hansonxiex-stack/nrf52-th-sensor-hardware/docs/变更记录表_智能温湿度传感器.md

# 设计变更记录表

> 项目：开源智能温湿度传感器 Pro PCB 设计
> 姓名：谢天成
> 说明：记录项目周期内所有对原理图、PCB、BOM 的实质性变更，按周次归档。
> 最后更新：第 7 周（2026.10.11）

---

## 使用说明

- **「变更前 → 变更后」** 只记录可核查的差异项，不含过程性调整。
- **「依据」** 一栏写明该变更的判据来源（数据手册条款 / 实测数据 / DRC 结果 / 工艺约束）。
- 涉及**库封装与板上实例不一致**的变更，详见《DRC 检查说明》与《DFM 检查报告与优化记录》。

---

## 变更总表

### 第 3 周（2026.09.07 — 09.13）叠层与板框

| # | 变更对象 | 变更前 | 变更后 | 依据 |
|---|---|---|---|---|
| 3-1 | 叠层结构 | 未定 | 4 层：F.Cu / In1.Cu(GND) / In2.Cu(VDD) / B.Cu | 信号—地—电源—信号结构；嘉立创 4 层标准叠层 |
| 3-2 | 板框尺寸 | 36 × 36 mm | 40 × 40 mm | 器件布局后面积不足 |

### 第 4 周（2026.09.14 — 09.20）布局与布线

| # | 变更对象 | 变更前 | 变更后 | 依据 |
|---|---|---|---|---|
| 4-1 | **U2 传感器 keepout 层设置** | 仅 `F.Cu` 单层 | `F.Cu` + `B.Cu` + `In1.Cu` + `In2.Cu` **四层** | SHT4x Datasheet v7.3 §5.3：*"There shall be no copper under the sensor other than at the pin pads."* 该要求为全层 |
| 4-2 | 板框尺寸 | 40 × 40 mm | **48.2 × 40 mm** | 为底层 LCD 段码走线腾出通道 |
| 4-3 | In1 / In2 铺铜区 polygon | x 124.6 ~ 166.0 | **x 116.1 ~ 166.0** | 同步 4-2 的板框变更；否则新扩区域铺不上铜 |
| 4-4 | **U3 焊盘局部角度** | 0°（库定义值） | **270°** | 焊盘长边原落在 0.635 mm 节距方向上，相邻焊盘重叠，产生 50 条 `shorting_items` / `clearance` 违规；旋转后清零 |
| 4-5 | U3 封装旋转 | — | 90°（置于 B.Cu） | 配合 LCD 引脚顺序 |
| 4-6 | 晶振 Y2 位置 | 原位置 | **下移 1.4 mm** | I2C_SCL 原从 Y2 焊盘下方穿过，间距仅 0.200 mm；下移后提升至 0.600 mm |
| 4-7 | I2C 总线速率 | 400 kHz | **100 kHz** | HT16C21A 手册：400 kHz 需 VDD ≥ 3.0 V，而 CR2032 放电过程中无法保证 |
| 4-8 | I2C 上拉电阻 R1 / R2 | 待定 | **10 kΩ**（维持） | 配合 4-7 的 100 kHz；上升时间余量约 8 倍 |
| 4-9 | 射频区走线 | 进入天线禁布区 | 调整通道位置 | 天线 keepout 要求 tracks/vias/pads/copperpour not_allowed |
| 4-10 | **AE1 天线 pad 2 环形宽度** | 0.10 mm（库定义值） | **0.25 mm** | 库中 0.10 mm 低于常见厂家最小环宽要求，加宽以满足可制造性 |

### 第 5 周（2026.09.21 — 09.27）布线收尾与 DRC

| # | 变更对象 | 变更前 | 变更后 | 依据 |
|---|---|---|---|---|
| 5-1 | **L2 型号（DC-DC 储能电感）** | Sunlord `SDFL1608S100KTF`（立创 C1035） | **Murata `LQM21FN100M80L`**（立创 C162582） | 原型号额定电流仅 **3 mA**，不满足 Nordic 参考设计的 **IDC,min ≥ 50 mA**；实测工作峰值电流 13.6 mA |
| 5-2 | L2 封装 | `Inductor_SMD:L_0603_1608Metric` | **`Inductor_SMD:L_0805_2012Metric`** | 随 5-1 换型；10 µH 且 ≥ 50 mA 的屏蔽功率电感在 0603 尺寸难以实现 |
| 5-3 | L2 连接走线 | — | 重画 `L2 → U1.DCC`、`L2 → L3` 两段 | 随换型后的焊盘位置重连 |
| 5-4 | 缝合过孔数量 | 20 个 | **66 个** | 消除 56 条 `unconnected_items`（GND 焊盘够不到 In1、VDD 焊盘够不到 In2） |
| 5-5 | 过孔与焊盘间距 | 7 个过孔孔净距不足 | 挪至**孔净距 0.15 mm / 环压焊盘 0.05 mm** | 孔离焊盘过近会导致回流焊时焊料沿孔壁虹吸流失 |
| 5-6 | C8 的 GND 过孔 | 孔净距 0.070 mm | **维持原位不动** | 几何上被夹死：L1 焊盘下沿到 C8 焊盘上沿仅 0.770 mm，而 0.7 mm 过孔加两侧间隙需 1.10 mm |
| 5-7 | U1 散热焊盘过孔 | 位置重合的散乱过孔 | **3 × 3 规整阵列**（9 个，孔径 0.3 mm） | 散热过孔需在 EP 焊盘内 |
| 5-8 | 丝印 Reference 字段 | 53 条 `silk_overlap` / `silk_over_copper` | **1 条**（LCD1 自身图形压自身焊盘） | 逐条处理后剩余的 1 条无需处理，理由见《DRC 检查说明》 |
| 5-9 | BOM · L2 行 | C1035 / 0.13 元 | **C162582 / 0.79 元** | 随 5-1 换型 |
| 5-10 | BOM 合计 | 27.48 元 | **28.14 元** | 随 5-9 |

### 第 6 周（2026.09.28 — 10.04）ESD 器件落地与全部布线完成

| # | 变更对象 | 变更前 | 变更后 | 依据 |
|---|---|---|---|---|
| 6-1 | **J1（SWD 调试座）位置与朝向** | (160.20, 61.80)，旋转 180° | **(160.90, 55.40)，旋转 −90°** | 需要为保护器件 U4 提供**同层且紧邻**的位置——ESD 保护要求保护器件与连接器同层、保护前路径最短，见《ESD 与滤波设计说明》§3.2.4 |
| 6-2 | **SW1（按键）位置** | (161.53, 55.20)，右上角紧邻原 J1 | **(140.10, 87.50)，左下角靠近电池座** | 回归叠层方案 §3.4 的分区：按键应与电池座 BT1 同处一侧、靠近板边便于操作。**层不变（仍为 B.Cu）** |
| 6-3 | **R4（KEY 上拉 10 kΩ）位置** | (157.20, 54.40) | **(135.78, 86.70)** | 随 6-2；上拉电阻应贴近按键入口 |
| 6-4 | **U2（SHT40）位置** | (140.80, 86.00) | **(131.90, 85.50)** | 增大与热源的距离：距主控 U1 由 20.7 mm 增至 **25.5 mm**，距电池座 BT1 由 8.2 mm 增至 **11.1 mm**。降低热耦合对测温精度的影响，见《热设计分析》§3.4 |
| 6-5 | **C12（U2 去耦 100 nF）位置** | (140.75, 88.40) | **(131.85, 87.90)** | 随 6-4。去耦电容必须保持在传感器电源脚旁，实测距 U2 仅 **2.4 mm** |
| 6-6 | C1（体电容 2.2 µF）位置 | (135.80, 79.00) | (135.80, 77.60) | 靠近电池座 BT1 |
| 6-7 | C7（DEC1 去耦）位置 | (145.92, 71.20) | (145.80, 71.80) | 微调避让走线 |
| 6-8 | **新增 U4：ESD 保护阵列** | — | **TT0554TLX @ (159.20, 62.10)，旋转 −90°，B.Cu** | 落地第 5 周确定的 ESD 方案 A，见《ESD 与滤波设计说明》§3.2 |
| 6-9 | **原理图符号（U4）** | 借用 KiCad 系统库 `Power_Protection:SRV05-4` | 新建**工程本地符号库** `TT0554TLX.kicad_sym` 并注册进 `sym-lib-table`；引脚名按 TT0554TLX 手册改为 `I/O_1 / GND / I/O_3 / I/O_4 / VCC / I/O_2` | SRV05-4 的引脚名与 TT0554TLX 不一致，其中 **pin 2 = GND、pin 5 = VCC** 是接线正确性的关键 |
| 6-10 | **SWDIO / SWDCLK / RESET 走线** | 4 / 4 / 3 段，J1 直连 U1 | **7 / 9 / 6 段**，改为 J1 → U4 → U1 | 随 6-8，把保护器件串入信号路径。保护前长度实测 3.66 / 3.83 / 7.25 mm |
| 6-11 | **VDD 走线** | 30 段 / 12 个过孔 | **38 段 / 10 个过孔** | 随 6-1 重走；U1 的三个 VDD 脚（pad 13 / 36 / 48）与 C4 / C17 / C18 重新接入 In2 电源平面 |
| 6-12 | **KEY 走线** | 8 段 | **10 段** | 随 6-2 / 6-3 重走 |
| 6-13 | I2C_SCL / I2C_SDA 走线 | 各 17 段 | 各 17 段，路径重画 | 随 6-4 重走 |
| 6-14 | 走线总量 | 329 段 | **354 段** | |
| 6-15 | **BOM · 新增 U4 行** | — | C5156695 / JingYang TT0554TLX / SOT-23-6 / **0.22 元** | 随 6-8 |
| 6-16 | **BOM 合计** | 28.14 元 | **28.36 元** | 随 6-15 |
| 6-17 | **DRC 状态** | 第 5 周末：4 条 warning | **0 error / 4 条 warning / 0 未连接**，与第 5 周报告的 4 条逐条相同 | 全部布线完成（第 6 周里程碑）。期间由 6-1 引出 1 条 J1 丝印出界、另现 1 条 LCD1 丝印重叠，均已修正 |
| 6-18 | **Y1（32 MHz 晶振）两脚走线长度** | XC1 6.73 mm / XC2 5.41 mm（差 **1.32 mm**，失配 19.6%） | **XC1 6.53 mm / XC2 6.31 mm（差 0.22 mm，失配 3.3%）** | 晶振两脚的寄生怕生应尽量相等，否则振荡的两个半周不对称。差值折算寄生电容差约 **0.013 pF**，相对 12 pF 负载电容为 0.1%。详见《信号完整性分析》§7.1 |

> **说明**：6-1 ~ 6-7 是**位置变更**而非器件变更。按本表的使用说明，位置调整仅在**它不是其他变更的副产物**时才单独记录——这七项均为独立的布局决策，故逐一记录。反之，6-8 ~ 6-13 中器件换型带来的位置变化（如 U4 的落位）不另列条目。

### 第 7 周（2026.10.05 — 10.11）可制造性收尾与生产文件定稿

| # | 变更对象 | 变更前 | 变更后 | 依据 |
|---|---|---|---|---|
| 7-1 | **过孔位置（12 处）** | 焊盘—过孔最小 **0.013 mm** | **0.150 mm** | 孔离焊盘过近时，回流焊的焊料会沿孔壁虹吸流失。《DFM 检查报告与优化记录》§2.1 |
| 7-2 | **过孔位置（1 处）** | 两枚过孔间距 **0.061 mm** | **0.418 mm** | 同上 |
| 7-3 | **元件外框丝印线宽** | **0.12 mm**（低于嘉立创 0.15 mm 下限） | **0.16 mm**，并重排位号避让焊盘与过孔 | DFM 丝印"危险"项 **109 → 0**（丝印距孔 46→0、丝印距焊盘 63→0）；实测线宽 0.1599 mm。《DFM 检查报告与优化记录》§2.1 |
| 7-4 | **BOM · R3 料号** | C17604（实际匹配为 **2 kΩ**，与 Comment "2.2k" 不符） | **C17520**（`0805W8F2201T5E`，2.2 kΩ ±1% 125 mW，UNI-ROYAL 厚声） | 设计阻值确认为 2.2 k；DFM 的 BOM 合并数据证实原料号错配。三份 BOM 同步更正。《DFM 检查报告与优化记录》§4 |
| 7-5 | BOM 合计 | 28.36 元 | **28.36 元（不变）** | 随 7-4：同厂、同系列、同为 0805 ±1%，仅阻值不同 |
| 7-6 | **DRC 状态** | 第 6 周末：4 warning（3 条库不一致 + 1 条丝印压焊盘） | **0 error / 0 未连接 / 34 warning** | 34 条全部为 `lib_footprint_mismatch`：丝印加粗后每个封装都与 KiCad 库副本不一致，属预期结果，不进制造数据 |
| 7-7 | **生产文件包定稿** | — | `生产文件_20261009/`：Gerber 11 图层 + gbrjob、钻孔、钢网（Paste 层）、CPL（31 位号）、BOM_SMT（23 行）、制板说明 | 交付件之一。《生产文件包清单》 |
| 7-8 | 文档数字勘误 | `制板说明` §六 丝印 0.12 mm；§二 焊盘—过孔 0.125 mm；`DFM说明` §2.1 最小铜净距 0.101 mm | 分别更正为 **0.16 mm**、**0.150 mm**、**0.200 mm**（0.101 一说的支撑不存在，已删除） | 《DFM 检查报告与优化记录》§2.2 |

> **7-1 ~ 7-3 只移动过孔与丝印，元件位置与布线拓扑未改变**；PCB 已重跑 DRC 与 DFM 复验通过。U3 的贴装方向问题（DFM 报 20 + 8 条）经核实属立创库模型朝向，**不改板**，转由 SMT 侧确认。

*记录完*
