hansonxiex-stack/nrf52-th-sensor-hardware/presentation/项目演示PPT_讲解稿.md

# 项目演示 PPT 讲解稿

**项目**：智能温湿度传感器　**讲解人**：谢天成
**配套 PPT**：`项目演示PPT_智能温湿度传感器.pptx`　（本稿即该文件各页的「备注」栏，放映时用演讲者视图直接看）
**进度**：22 页全部完成，逐页讲解时间合计 **8 分 43 秒**。

> 表中时间为排练目标。型号、单位与数字都要完整读出，另需留出翻页与指图停顿；建议完整试读一次、以实际录音为准，整体控制在 **8 分半至 9 分钟**。
> 合计为第 1~22 页逐页时间之和，不含自由开场与答问。

| 页码 | 页面标题 | 讲解时间 |
|---|---|---:|
| 1 | 项目名称与成果展示 | 10 秒 |
| 2 | 项目目标与工作范围 | 26 秒 |
| 3 | 系统总体方案 | 24 秒 |
| 4 | 核心器件与方案选择 | 22 秒 |
| 5 | 项目实施过程 | 18 秒 |
| 6 | 原理图与接口设计 | 21 秒 |
| 7 | PCB 总体布局 | 26 秒 |
| 8 | 四层叠层与布线规则 | 27 秒 |
| 9 | 射频馈线阻抗设计 | 25 秒 |
| 10 | 晶振与去耦布局 | 23 秒 |
| 11 | I²C 总线参数设计 | 20 秒 |
| 12 | 传感器布局与热隔离 | 18 秒 |
| 13 | LCD 接口扇出与换层设计 | 27 秒 |
| 14 | LTspice 电源仿真 | 29 秒 |
| 15 | 电源完整性与低电量阈值 | 32 秒 |
| 16 | ESD 防护与可测试性设计 | 28 秒 |
| 17 | DRC 检查与问题整改 | 25 秒 |
| 18 | DFM 检查与处理结果 | 30 秒 |
| 19 | U3 贴装方向核对案例 | 27 秒 |
| 20 | 生产文件与交付成果 | 17 秒 |
| 21 | 项目成果与后续计划 | 19 秒 |
| 22 | 个人收获与结束 | 29 秒 |
| | **合计（第 1~22 页）** | **8 分 43 秒** |

---

## 第 1 页　项目名称与成果展示

**页面要点**：项目名称、姓名、周期；一句话概括完成四层 BLE 温湿度传感器硬件设计与生产文件准备。主视觉为板卡正反面 3D 图。

> 我是谢天成，八周完成四层 BLE 温湿度传感器的硬件设计与生产文件准备。

---

## 第 2 页　项目目标与工作范围

**页面要点**：目标为独立走完从需求到制造文件的硬件设计流程；温湿度采集、低功耗蓝牙通信、段码显示三项功能；工作范围覆盖需求、原理图、PCB、专项分析与制造文件。配图为四段式研发流程图。

> 项目目标是独立走完一遍从需求到制造文件的硬件设计流程，交付可复现的开源硬件。功能上覆盖温湿度采集、低功耗蓝牙通信和段码液晶显示；工作范围从需求与原理图，到四层板布局布线，再到专项分析与制造文件交付。

---

## 第 3 页　系统总体方案

**页面要点**：nRF52810、SHT40、HT16C21A、LCD、CR2032、SWD 各模块的连接关系。配图为系统框图，区分供电与数据连接。

> 这是系统总体方案，分三条路径。数据路径上，SHT40 采集的温湿度经 I²C 交给 nRF52810，主控处理后用同一路 I²C 写入 HT16C21A 驱动段码 LCD，同时通过板载 PCB 天线对外广播。供电上，CR2032 直接给三个模块供电，不经过 LDO。辅助路径是 SWD 三线，入口处放了 U4 做 ESD 保护。

---

## 第 4 页　核心器件与方案选择

**页面要点**：主控与传感器选型；段码 LCD 的低功耗显示方案；CR2032 直供；标准带屏版 BOM 约 28.36 元。配图为器件／选择依据简表。

> 核心器件四块。主控选 nRF52810，把 BLE 和主控集成在一颗芯片里；传感器选 SHT40，功耗低、适合电池供电。显示用 HT16C21A 驱动段码 LCD，能做低功耗常显，而且和传感器共用一路 I²C。供电用 CR2032 直供，省掉 LDO 的压差损失。标准带屏版 BOM 约 28.36 元。

---

## 第 5 页　项目实施过程

**页面要点**：第 1~2 周需求与原理图；第 3~5 周叠层与布局布线；第 6~7 周分析及制造准备；第 8 周汇报交付。配图为四阶段时间轴。

> 八周分四个阶段：前两周做需求调研和原理图，中间三周做叠层设计、布局布线并把 DRC 收口，第六到七周做专项分析、整改 DFM 并定稿生产文件，最后一周汇总交付。

---

## 第 6 页　原理图与接口设计

**页面要点**：主控最小系统；SHT40 与 LCD 驱动共用 I²C；SWD、按键和状态灯。配图为原理图分区截图，突出三个功能区域。

> 原理图分三个功能区。左边是主控最小系统，按参考设计配齐了 VDD 去耦和 DEC 引脚的稳压外围。中间是 I²C 接口：SHT40 和 HT16C21A 地址不冲突，共用主控的 P0.06 和 P0.07，省掉一路总线。右边是 SWD 三线引到 J1，入口放 U4 做 ESD 保护。

---

## 第 7 页　PCB 总体布局

**页面要点**：板框 48.25 × 40.05 mm；正反面功能分区；射频、传感器、主控、显示及电池的相对位置。配图为正反面 PCB 图加功能标注。

> 板框 48.25 乘 40.05 毫米，四层板。正面放射频天线、主控、晶振和传感器，背面放 LCD 驱动、电池座、按键和 SWD 调试口。分区的原则是：射频链路单独占一角并保持参考地完整，传感器放在板边、远离主控这个热源，两者的间距最后从 20.7 毫米拉到了 25.5 毫米。

---

## 第 8 页　四层叠层与布线规则

**页面要点**：S-G-P-S 层序；顶层射频参考地平面；普通信号、电源和射频分别设置规则。配图为叠层示意图＋小型规则表。

> 叠层采用信号、地、电源、信号的四层结构，总厚约 1.6 毫米。顶层射频馈线以下方地平面为参考，关键走线避免跨越参考平面的开槽和分割区域。布线规则按网络类分别设置：普通信号 0.2 毫米，电源线按载流需要加宽，射频单独建 RF_50R 类，线宽 0.36 毫米。

---

## 第 9 页　射频馈线阻抗设计

**页面要点**：根据介质厚度 0.2104 mm 与介电常数计算；50 Ω 对应线宽约 0.36 mm；局部短颈缩及顶层无过孔布线。50 Ω 约束针对指定馈线段，不含 ANT 引脚到天线的全部连接。配图为阻抗计算截图＋射频走线放大图，标出颈缩位置。

> 指定的射频馈线段按叠层参数进行 50 欧阻抗设计：介质厚度 0.2104 毫米，介电常数约 4.4，对应线宽约 0.36 毫米。QFN 引脚出口受焊盘间距限制，局部采用约 0.7 毫米长的短颈缩，其余馈线按目标阻抗布线，并保持顶层连续连接、避免过孔。

---

## 第 10 页　晶振与去耦布局

**页面要点**：晶振靠近对应引脚；缩短关键连接；去耦电容结合对应电源引脚布置，缩短电源连接与接地回路。配图为主控周边局部图，标出晶振与负载电容。

> 晶振和去耦的原则是就近。Y1 的 32 兆主晶振紧靠 XC1、XC2，Y2 的 32.768 千赫兹紧靠 XL1、XL2。负载电容按晶振标称值反推，取 12 皮法。去耦电容结合对应的电源引脚布置，缩短电源连接和接地回路，降低寄生电感对去耦效果的影响。

---

## 第 11 页　I²C 总线参数设计

**页面要点**：受液晶驱动供电前提约束采用 100 kHz；上拉 10 kΩ；按约 30 pF 电容估算上升时间约 254 ns，满足 1000 ns 要求。配图为公式 t_r ≈ 0.8473RC 与三档电容的参数表。

> 综合液晶驱动的供电条件和系统通信需求，总线采用 100 kHz。上拉电阻取 10 kΩ，按约 30 皮法总线电容估算，上升时间约 254 纳秒，满足标准模式 1000 纳秒的要求，同时降低低电平期间的灌电流。

---

## 第 12 页　传感器布局与热隔离

**页面要点**：SHT40 靠近板边、远离主控；器件下方禁铜区；分析重点为降低板内热耦合。配图为传感器局部布局与四层禁铜区。

> SHT40 布置在板边，与主控中心距离约 25.5 毫米，并在器件下方设置四层禁铜区，减少铜层带来的热传导。第一版只做了顶层，内层和底层仍是满铜，后来扩展到四层。

---

## 第 13 页　LCD 接口扇出与换层设计

**页面要点**：24 根 SEG／COM 线；引脚间距和排列顺序限制；分组扇出及器件本体下方换层。配图为 LCD 与驱动间布线图，两组走线用不同颜色区分。

> LCD 和驱动之间 24 根线，三处限制叠在一起。第一，U3 焊盘 0.635 间距，相邻只剩 0.235 毫米缝隙，只能垂直出脚。第二，U3 跨度 8.25 毫米，LCD 每列跨 27.94 毫米，要扇出。第三，U3 右列和 LCD 左列顺序互为镜像，单层不交叉接不通。最后拆两组：10 根走左侧通道，14 根在芯片本体下方打孔换到顶层。

---

## 第 14 页　LTspice 电源仿真

**页面要点**：电池电压源＋内阻＋等效负载＋去耦模型；10 mA 高裕量负载；三档内阻下的电压跌落与恢复，最低约 2.499 V。配图为仿真电路＋电压波形。

> LTspice 中采用 3 伏电压源、电池串联内阻、等效脉冲负载和去耦电容建立模型，扫描 10、30、50 欧三档内阻。主控负载取 10 毫安高裕量工况，观察活动期间的电压跌落和负载结束后的恢复。脉冲持续 10 毫秒，使电源响应充分展开。最低电压约为 2.499 伏，相对 2.4 伏设计下限仍有约 99 毫伏裕量。

---

## 第 15 页　电源完整性与低电量阈值

**页面要点**：正常活动峰值采用 6 mA；PCB 压降小于 0.5 mV，电池内阻压降为主要影响；结合 2.4 V 下限设置 2.8 V 告警阈值。配图为压降对比简表＋电压裕量示意。

> 前面的仿真采用 10 毫安高裕量负载，这里的电源完整性分析采用 6 毫安正常活动峰值。PCB 本身的压降不到 0.5 毫伏，可以忽略；主要的电压波动来自电池内阻，6 毫安下约 60 到 360 毫伏。系统采用的 2.4 伏下限主要受显示部分约束。结合活动期间的电池内阻压降和预留裕量，将低电量告警阈值设为 2.8 伏。

---

## 第 16 页　ESD 防护与可测试性设计

**页面要点**：SWD 入口设置 U4；兼顾信号路径和漏电流；保留调试资源，规划上电、通信及功耗测试。配图为 SWD／ESD 局部图＋三步测试流程。

> SWD 入口设置 U4，并与调试接口同层紧邻布置。选型时兼顾保护性能与低功耗要求，重点控制漏电流，并按手册最大值核算；布局上兼顾保护路径和接地回路。可测试性方面，保留 SWD 与必要测试节点，后续按上电检查、通信与显示验证、功耗测量的顺序开展调试。

---

## 第 17 页　DRC 检查与问题整改

**页面要点**：最终 0 error、0 未连接；说明剩余封装库差异警告；举 LCD 通孔焊盘与 U3 焊盘角度两个例子。配图为最终 DRC 截图。

> 最后 DRC 是 0 error、0 未连接，34 条 warning 全是封装库差异，已逐项核对，制造文件按板上最终封装生成。例如，LCD 采用通孔焊盘，布局时同时检查正反两面的焊盘间距与装配空间。整改中还修正了 U3 的焊盘角度，消除了相关的 50 条违规。

---

## 第 18 页　DFM 检查与处理结果

**页面要点**：丝印整改；组装告警按模型差异、贴装方向与盘中孔工艺分类核对；盘中孔保留现有设计，制板说明注明采用 POFV 工艺。配图为危险溯源分类表＋DFM 分析截图。

> DFM 一共报了 96 条危险，按封装模型差异、贴装方向和盘中孔工艺逐条分类核对：U1 引脚轮廓 48 条、U3 模型朝向 30 条、U1 散热盘盘中孔 10 条，其余为模型差异。丝印方面，将外框线宽从 0.12 增至 0.16 毫米，距孔和距焊盘的相关告警均清零；盘中孔则在制板说明中明确采用 POFV 工艺。

---

## 第 19 页　U3 贴装方向核对案例

**页面要点**：主要差异是模型朝向；结合焊盘编号、坐标文件和一脚标记逐项核对；随生产文件提交方向说明。配图为模型与焊盘对照图。

> U3 是这版最需要交代的一处。DFM 报它 20 条无焊盘、8 条相交区域，核对下来主要差异是模型朝向：板上焊盘两排沿 X，模型引脚两列沿 Y。结合焊盘编号、坐标文件和丝印一脚标记逐项核对，CPL 记录 90°，一脚标记指向 pad 1，所以设计不改，随生产文件交一份方向说明。

---

## 第 20 页　生产文件与交付成果

**页面要点**：Gerber、钻孔、BOM、CPL、制板与贴装说明；核对元件数量、贴装面和方向等一致性。配图为文件构成图＋八项核对清单。

> 生产文件包是 10 月 9 日定稿的：Gerber 11 个图层加作业文件、两个钻孔、钢网、31 个位号的坐标文件、23 行的 BOM 和制板说明。四份文件之间做了八项一致性核对，全部通过。

---

## 第 21 页　项目成果与后续计划

**页面要点**：已完成硬件设计、专项分析和制造文件；后续安排打样、首件检查及功能／功耗／射频测试。配图为「已完成／后续工作」两栏＋关键数字。

> 目前完成的是硬件设计、五项专项分析和整套制造文件；后续是打样，首件回来重点查 U1 的 0.4 毫米间距焊接质量、散热盘空洞和 U3 的贴装方向，再做功能、功耗和射频测试。

---

## 第 22 页　个人收获与结束

**页面要点**：四点收获：电路连对到板子做得出来；参数不仅要有出处，还要判断是否适用；取值依据可来自数据手册、项目常用值、同类项目等多方来源并交叉印证；设计要能完整交付。配图为四条简短总结＋PCB 3D 图，页尾「感谢聆听」。

> 八周下来有四点收获。一，连对电路只是起点，板子做得出来才算数。二，参数有出处还不够，手册值都带工况前提。三，取值依据可以来自多处：数据手册给边界，项目常用值给范围，同类项目给参照，仿真与计算做校验。四，设计要能被完整交接才算做完。谢谢各位。

---

**第 5 页时间轴数据来源**（取自八周实验报告与总结报告 §4）：

| 阶段 | 时间 | 内容 | 里程碑 |
|---|---|---|---|
| 第 1–2 周 | 08.24 – 09.06 | 需求与原理图 | 原理图通过 ERC |
| 第 3–5 周 | 09.07 – 09.27 | 叠层与布局布线 | 未连接 56 → 0 |
| 第 6–7 周 | 09.28 – 10.11 | 分析与制造准备 | DRC 0 error + 生产文件包 |
| 第 8 周 | 10.12 – 10.18 | 汇报与交付 | 总结报告完成 |
