hansonxiex-stack/nrf52-th-sensor-hardware/docs/wk8/项目总结报告_智能温湿度传感器.md

# 开源智能温湿度传感器 Pro PCB 设计——项目总结报告

> 姓名：谢天成
> 项目周期：2026.08.24 — 2026.10.18（共 8 周）
> 报告日期：2026-10-18
> 交付物：本报告 + **生产文件包**（`正式工程_方案B/生产文件_20261009/`）+ 八份专项说明 + 《设计变更记录表》
> 正文字数：8,528 字（按汉字计）

板卡 3D 视图：左＝正面（射频、主控、传感器、晶振），右＝背面（LCD 驱动、电池座、按键、调试口）

---

## 1. 项目概述

### 1.1 目标与定位

本项目的目标不是"画一块能用的板子"，而是**完整实践一遍专业硬件研发流程**：需求调研 → 原理图 → 仿真 → 叠层 → 布局布线 → SI/PI/热/DFT 分析 → DFM 与生产文件 → 打样，最终形成一套**可供后续打样、验证与复用**的硬件设计及生产文件。

最终落在**方案 B（标准带屏版）**：nRF52810 + SHT40 + HT16C21A 段码 LCD 驱动 + CR2032 直供，四层板，48.2 × 40 mm。

### 1.2 最终设计规格

| 项 | 数值 |
|---|---|
| 主控 | Nordic **nRF52810** QFN-48（6 × 6 mm，带 EP） |
| 传感器 | Sensirion **SHT40**-AD1B，DFN-4 1.5 × 1.5 mm（**无中心盘**封装） |
| 显示 | 定制 20×4 段码 LCD 玻璃 + **HT16C21A**（SSOP-28）驱动 |
| 通信 | BLE 2.4 GHz，板载 PCB 天线（TI SWRA117D），射频链路 **13.15 mm / 全程 F.Cu / 0 过孔 / 0.36 mm** |
| 供电 | **CR2032 直供**（无 LDO），工作范围 2.4 ~ 3.3 V |
| 保护 | TT0554TLX 四通道 ESD 阵列（U4），置于 SWD 入口 |
| 层数 / 板框 / 板厚 | 4 层（S-G-P-S） / **48.25 × 40.05 mm** / 1.6 mm |
| 铜厚 | 外层 1 oz / 内层 0.5 oz |
| 叠层 | 与嘉立创标准模板 `JLC04161H-7628` 一致（PP 0.2104 mm / εr 4.4，Core 1.065 mm / εr 4.5） |
| 最小线宽 / 最小铜净距（异网络） | **0.20 mm** / **0.200 mm** |
| 过孔 | 65 个，全部 0.70 mm 盘 / 0.30 mm 孔（环宽 0.20 mm） |
| 孔总数 | 92（全部 PTH；NPTH 0） |
| 元件 / 贴装位号 | 37 个（正面 28 / 背面 9） / **31 个**（双面贴装，需两张钢网） |
| 走线 | 354 段，总长 798.7 mm |
| 网络数 | 47 |
| BOM 成本 | **¥28.36**（其中 SMT 部分 ¥27.01；基础库 9 项 / 扩展库 14 项） |
| 表面处理 / 特殊工艺 | 沉金（ENIG，1u"） / **盘中孔 POFV**（U1 散热盘 9 孔） |

### 1.3 交付物清单

| 类别 | 文件 | 内容 |
|---|---|---|
| **生产文件** | `生产文件_20261009/` | Gerber 11 图层 + `.gbrjob`、钻孔、钢网、CPL（31 位号）、BOM（23 行）、制板说明 |
| 可制造性 | 《DFM 检查报告与优化记录》 | DFM 报出的每一项：报了什么、为什么、依据在哪 |
| 可制造性 | 《DFM 可制造性设计说明》 | 设计要求与嘉立创 4 层板工艺能力的逐项核对 |
| 可制造性 | 《生产文件包清单》《BOM 清单与工艺说明》 | 文件构成、成本与库别、贴装范围 |
| 下单 | 《PCB 打样下单说明》《U3 贴装方向说明》 | 下单页逐项填写值、需向板厂确认的事项 |
| 分析 | 《信号完整性分析》《电源完整性分析》《热设计分析》《DFT 可测试性设计说明》《ESD 与滤波设计说明》 | 五份设计分析报告 |
| 分析 | 《LTspice 电源仿真取数依据与适用性说明》 | 早期仿真的取数溯源与适用范围界定 |
| 过程 | 《设计变更记录表》 | 第 3 ~ 7 周全部实质性变更（共 **48** 条：3-1~3-2、4-1~4-10、5-1~5-10、6-1~6-18、7-1~7-8） |
| 过程 | 第 1 ~ 7 周实验报告 | 每周目标、完成情况、问题与处理、进度评估 |

---

## 2. 系统组成与预期工作流程

### 2.1 三条路径

**数据路径**：SHT40 测得温湿度，经 I²C 交给 nRF52810；主控处理后，用同一路 I²C 把待显示内容写进 HT16C21A，由它驱动 20×4 段码 LCD；同时经 BLE 从板载 PCB 天线对外广播。

**供电路径**：CR2032（标称 3.0 V）直接给三个模块供电，**不经过 LDO**。电池端由 C1 2.2 µF 承担局部储能，五颗 100 nF 分别挂在 nRF52810 的 VDD 引脚旁做高频去耦；芯片内部 DC-DC 的外围（L2、L3、C11）按 Nordic 参考设计配置。不用 LDO 的理由是：本机关注的 2.5 ~ 3.2 V 区间本就落在 nRF52810 的 1.7 ~ 3.6 V 输入范围内，加一级稳压只会带来压差损失与额外静态功耗。

**辅助路径**：SWD 三线（SWDIO / SWDCLK / nRESET）引到 J1 调试座，入口处并联 U4（TT0554TLX）做 ESD 保护；SW1 按键与 D1 + R3 状态灯提供本地交互与指示。

### 2.2 预期运行过程

按硬件设计意图，固件运行时的常态是一个循环：

> 休眠 / 等待 → 唤醒 → 发起测量 → 读取数据 → 更新显示 / 发送广播 → 返回低功耗状态

三件事的节奏互相独立，**测量周期、显示刷新周期与广播间隔可以分别设置**。这也正是本板功耗结构的特点：LCD 常显的 18 µA 是持续负载，射频发射与传感器测量各只占很短的时间片，整机平均电流由各自的占空比决定。

需要说明的是，**本项目未开发固件**，以上是硬件侧的预期工作方式，具体周期须由固件侧确定。也正因为周期未定，第 2 周的电源仿真只能给出设定负载工况下的压降，给不出续航结论（原因见 §6.4）。

---

## 3. 原理图设计与器件选型落实

### 3.1 主控最小系统

- **电源与去耦**：VDD 轨上共 6 个电容（C1 2.2 µF + 5 × 100 nF）；DEC1 ~ DEC4 是芯片内部稳压节点的引出脚，按参考设计各配一颗（C7 / C6 / C5 / C11，其中 C6 为不贴装位）。核对方式是从**网表反查**：把每个电容两端的网络打出来，确认各自接在哪个节点上。核对确认了内部 DC-DC 的外围 L2（10 µH）与 L3（15 nH）在电路上**串联**、C11 是唯一的输出电容（最初以为两者之间还有电容支路）。
- **时钟**：Y1 32 MHz 主晶振（接 XC1 / XC2，负载电容 C15 / C16 = 12 pF）与 Y2 32.768 kHz RTC 晶振（接 XL1 / XL2，负载电容 C9 / C10 = 12 pF）分别靠近各自引脚。负载电容按晶振标称负载电容反推，核对结果与二版建议见 §9.3。
- **调试接口**：SWDIO / SWDCLK / nRESET 三线引到 J1（1.27 mm 2×5），入口处放 U4；保护优先级与选型依据见 §5.7。
- **射频外围**：按 Nordic 参考设计落实为 C8 0.8 pF 并联到地（芯片侧匹配）+ L1 3.9 nH 串联 + R5 0 Ω，另留 C13 / C14 两个并联位作为天线侧调试余量（当前 DNP）。

### 3.2 传感与显示接口

- **共享一路 I²C**：HT16C21A 的 7 位从机地址是 **0x38**，SHT40-AD1B 是 **0x44**，两者不冲突，可直接挂在同一对 P0.06 / P0.07 上，省掉一路总线。地址是**逐个查手册确认**的，不是按"常见值"填的——SHT40 按订购型号不同，地址有 0x44 / 0x45 / 0x46 三种。
- **上拉与供电**：R1 / R2 各 10 kΩ（取值依据见 §5.5），两条线的供电同取 VDD 轨。
- **液晶偏压**：HT16C21A 的 VLCD 直接取 VDD，不另做偏压电路。这一条带来一个全局后果：**整机工作范围的下限由它决定（2.4 V），而不是由 nRF52810 的 1.7 V 决定**，所以低电量告警必须在 LCD 先出问题之前发出（见 §5.6）。
- **段码玻璃**：20×4 段码 LCD 与驱动器之间有 24 根 SEG / COM 线，其扇出矛盾要到版图阶段才暴露（见 §5.10）。

### 3.3 符号与封装核对

原理图能不能画对，取决于**符号的引脚号与封装的焊盘号是不是真的对得上**，所以这两项分开核对：

- **符号**：每个器件按数据手册的引脚定义建符号，引脚编号与手册一致；连接靠网络标签落实。
- **ERC**：检查连接性、电源引脚冲突与未驱动网络。这一步发现一类较隐蔽的错——**HT16C21A 的 SEG9 与 LCD 符号的 SEG16 ~ SEG19 共 5 个引脚被放在 50 mil 网格之外（偏移约 0.05 mm）**，视觉上导线已碰到引脚，ERC 却报未连接；移回网格后通过。
- **封装**：按手册封装尺寸表逐个选 footprint 并对齐焊盘号——U1 为 QFN-48 6 × 6（带 4.6 mm 散热盘）、U2 为 DFN-4 1.5 × 1.5 **且无中心盘**（立创库内同料号的封装带 EP，属刻意不用的差异）、U3 为 `SSOP-28_3.9x9.9mm_P0.635mm`（最初误记为 5.3 mm 宽，核对手册 p34 尺寸表后更正）。段码玻璃无标准封装，按《HT16C21A_KiCad_symbol 创建指南》自建符号与封装：**两列各 12 个通孔焊盘（1.5 mm 盘 / 0.8 mm 孔），脚距 2.54 mm，每列跨度 27.94 mm**，与 §5.10 的扇出方式一致。

---

## 4. 八周主线

| 周次 | 时间 | 主线 | 里程碑 |
|---|---|---|---|
| 1 | 08.24 ~ 08.30 | 竞品调研、器件选型、KiCad 入门（两层板练习） | 选型方向确定 |
| 2 | 08.31 ~ 09.06 | 系统框图 → 原理图 → ERC → LTspice 电源仿真 → BOM 定价 | **原理图过 ERC**；成本口径确认 |
| 3 | 09.07 ~ 09.13 | 四层板叠层设计、50 Ω 阻抗计算、KiCad 规则落地 | **叠层 + 板框 + 网络类定稿** |
| 4 | 09.14 ~ 09.20 | 全部器件布局；天线 / LCD / I2C 三部分布线 | 布局完成；DRC 电气类违规清零 |
| 5 | 09.21 ~ 09.27 | 缝合过孔补齐、过孔—焊盘间距、丝印整理、DRC 收口 | 未连接 56 → **0**，DRC 仅余 4 条 warning |
| 6 | 09.28 ~ 10.04 | ESD 防护落地（U4 + 本地符号库）、全部布线完成 | **全部布线完成** |
| 7 | 10.05 ~ 10.11 | 嘉立创 DFM 全量提交与整改、生产文件包定稿 | **DRC 0 error + 生产文件包** |
| 8 | 10.12 ~ 10.18 | 总结报告、PPT、演示视频、GitHub 开源、答辩 | 报告、PPT、演示视频与开源仓库完成；答辩待进行 |

---

## 5. 关键设计决策：依据与取舍

### 5.1 方案分级与成本目标调整

需求阶段定的目标是 BOM ≤ 15 元。实际选型后发现，**nRF52810（¥13.71）+ SHT40（¥6.95）两颗核心器件就已经 ¥20.66**，仅这两颗就超了。

**处理**：把方案拆成极简广播版 / 标准带屏版 / 高精度 Pro 版三档，明确本项目做标准带屏版，成本口径随即调整为"约 28 元"，**经评审确认通过**，不再作为风险项。

**取舍**：综合功能要求与器件成本，保留现有主控与传感器方案，并调整成本目标。

### 5.2 四层板与 S-G-P-S 层序

本板含 2.4 GHz 蓝牙射频与 32 MHz 晶振，采用四层板。三种常见层序（S-G-P-S / G-S-S-P / S-S-G-P）中选定 **S-G-P-S**：顶层射频与晶振紧贴完整地平面，底层 I2C 紧贴电源平面，两个信号层各自都有完整参考平面。

**铜厚口径**：嘉立创标准四层板的铜厚为**外层 1 oz / 内层 0.5 oz（芯板标 H/HOZ）**，并非四层均为 1 oz；查标准叠层表后，在 KiCad 物理叠层里按 0.035 mm 与 0.0152 mm 分别填写，叠层合计 1.6062 mm 与标称 1.59 mm 相符。

### 5.3 射频馈线阻抗计算与布线设计

以本板实际叠层的**介质厚度 H = 0.2104 mm**（Top→GND 的 7628 半固化片）与 **εr ≈ 4.4** 为输入，用嘉立创阻抗计算器反算，得单端 50 Ω 微带线宽 **W = 14.1 mil ≈ 0.36 mm**，反算阻值 49.84 Ω。在 KiCad 中建 `RF_50R` 网络类（线宽 0.36 mm）绑定射频网络，布线时自动约束。

**取舍**：进入 QFN-48 的 ANT 脚时受 0.4 mm 间距限制，做了 **0.2 mm 颈缩**，长度仅 0.7 mm ≈ 0.01 λ，属集总范围，反射可忽略。权衡后未采用"全程等宽"的绕线方案，因绕出的额外长度代价大于颈缩。

### 5.4 SHT40 热隔离与禁铜区设计

SHT4x 数据手册 §5.3 的要求是 **"There shall be no copper under the sensor other than at the pin pads"** —— 传感器下方除引脚焊盘外不得有铜，**且覆盖所有层**。

第一版 U2 内嵌的禁铜区（keepout）**只设在 F.Cu**，In1（GND）、In2（VDD）、B.Cu 在传感器正下方都是满铜。其中 In2 是**载流、自热的电源平面**，压在温湿度传感器正下方尤为不利。

**判据**：铜的导热系数约 385 W/(m·K)，FR4 约 0.3 W/(m·K)，相差约 **1300 倍**。内层平面会把传感器与整块板热耦合在一起，其热沉作用强于表层铜；去除铜之后，剩余的 FR4 本身就是良好的隔热层。

**处理**：禁铜区由 F.Cu 扩展到四层。同时不在传感器下方开槽——U2 的 4 个焊盘之间净空只有 0.9 mm，小于嘉立创内槽最小宽度约 1.0 mm；且 SHT4x 的**感湿开孔在顶面**，底部开槽对湿度测量没有帮助。

**与热设计的关系**：本板平均功耗约 0.1 mW、最热器件结温升约 0.7 ℃，热设计的主要对象是传感器与板内热源的隔离，而非散热（U2 距 U1 由 20.7 mm 增至 25.5 mm）。

### 5.5 I2C 定 100 kHz、上拉保持 10 kΩ

**速率**：HT16C21A 手册的 I2C 交流特性是**分两档**写的——400 kHz 需要 VDD ≥ 3.0 V，100 kHz 只需 2.4 ~ 5.5 V。而 CR2032 标称 3.0 V，一接负载立即跌破，寿命末期内阻涨到数百 Ω ~ kΩ，蓝牙发射的 mA 级脉冲还会再拉低。**400 kHz 的前提条件不成立，定 100 kHz。**

**上拉**：按 100 kHz 的 1.0 µs 上升时间上限核算 `t_r ≈ 0.8473·R·C`，总线电容在 30 / 40 / 50 pF 三种估计下，10 kΩ 的余量分别为 3.9× / 2.9× / 2.4×，**10 kΩ 保持不变**，同时比 4.7 kΩ 省一半灌电流。

**灌电流判据的修正**：最初引用的是 **I2C 总线规范**的 3 mA，逐颗查手册后，nRF52810 的保证值为 **≥1 mA**（PS p188），余量由 11.5× 修正为 **3.8×**，核算以器件手册值为准。

### 5.6 供电压降分析与低电量阈值设计

PCB 导电路径的直流压降 **< 0.5 mV**；而 CR2032 内阻（10 ~ 60 Ω）在 6 mA 下造成 **60 ~ 360 mV** 压降，**比前者高两个数量级**。因此本板 PI 分析的重点是电池内阻引起的负载压降与局部去耦。

**工作范围的下限**：2.4 ~ 3.3 V 的**下限由 HT16C21A 的 2.4 V 决定**（nRF52810 可低至 1.7 V）。因此电量耗尽的先兆是 **LCD 先显示异常**，而不是 MCU 先掉电；据此把低电量告警阈值定为 **2.8 V**。另在早期 LTspice 的 10 mA 较重负载工况下，最低电压为 2.499 V，相对 2.4 V 下限仍有约 99 mV 余量。

### 5.7 ESD 器件选型与保护布局

U4 与连接器 J1 **同层紧邻**，四条保护前路径长度分别为 3.66 / 3.83 / 7.25 / 15.98 mm（版图测量）。VDD 那一路偏长，**评估后不把 U4 转 180°**：转过去 VDD 能缩到约 9.4 mm，代价是两条信号线的保护前长度从 3.83 / 7.25 mm 增至约 6.1 / 6.8 mm。

**判据**：SWDIO / SWDCLK / nRESET 是**裸露焊盘直连 nRF52810 引脚**，ESD 能量集中在单个引脚；VDD 网络有 2.2 µF 体电容与完整电源平面分摊。本项目优先保证两条信号线的保护前路径最短，未用其裕量换取 VDD 路径长度。

**另一条实现细节**：接入电源平面的过孔必须打在保护器件**之后**（pin 5 一侧），打在那 15.98 mm 路径的中段会让 ESD 电流在到达钳位点之前就流入电源平面，增加瞬态干扰进入电源平面的风险，削弱保护效果。

**器件选型的第一约束是漏电流**：本机静态电流约 20 µA，TT0554TLX 手册给出典型 0.1 µA / 最大 1.0 µA，按最大值核算占静态电流的 **5%**（按典型值则为 0.5%）。本板器件选型一律按手册最大值核算。

### 5.8 过孔与焊盘间距控制

本板的孔—盘间距按两条判据控制：

- **环压着焊盘不影响电气性能**：同网络下环与焊盘重叠属于零长度连接，本设计中不作限制。
- **孔必须离焊盘边 ≥ 0.15 mm**（0.10 mm 是底线）。孔和焊盘贴太近，回流焊时**焊料会顺着孔壁虹吸跑掉**，造成焊点虚空。

**孔净距 = 环净距 + 0.2 mm 是恒定的**（0.7 mm 外径 − 0.3 mm 钻孔 = 0.4 mm 环宽，两侧各 0.2 mm），因此调整位置时以**孔**的净距为准。全板最终做到孔净距 0.15 mm，仅 C8 的 GND 过孔受局部布局空间限制维持在 0.070 mm（已知例外）。

### 5.9 主控裸露焊盘的盘中孔工艺方案

U1（nRF52810）的散热焊盘 pad 49 为 4.6 × 4.6 mm，内部布置 9 个 0.30 mm 过孔（3 × 3），构成盘中孔。回流焊时敞口过孔会吸走焊料：**9 个过孔的总孔内容积约 1.02 mm³，约为钢网印刷锡膏体积（约 1.66 mm³）的 60%**，散热焊盘焊点存在空洞风险。

**处理**：采用**树脂塞孔 + 电镀填平（IPC-4761 Type VII / POFV）**。该工艺在 4 层板属**收费项**（嘉立创仅对 6 层及以上免费），下单时须由计价器核算；其余 56 个过孔按标配的免费"过孔塞油"处理。

### 5.10 LCD 接口扇出与换层布线

LCD 与驱动之间 24 根线，三处限制叠加：

1. U3 焊盘 1.2 × 0.4 mm @ 0.635 mm 间距，相邻焊盘只剩 **0.235 mm 缝隙**，0.2 mm 走线需要 0.6 mm 通道 → **焊盘之间走不了线，只能垂直出脚**；
2. U3 引脚跨度只有 8.25 mm，而 LCD 每列跨 27.94 mm，0.635 mm 要扇出到 2.54 mm；
3. **U3 右列与 LCD 左列的顺序互为镜像** —— SEG8 在 U3 右列最靠上，在 LCD 左列却最靠下。单层无交叉的扇出在拓扑上无法实现。

**化解**：拆成 10 根（U3 左列 → 左侧通道 → LCD 右列）+ 14 根（U3 右列 → 在芯片**本体下方**打过孔换层到 F.Cu → 顶层布线 → LCD）。利用**贴片器件本体下方 B.Cu 没有铜**这一点，在芯片本体下方区域布置 12 个换层过孔，外部不可见。

---

## 6. 验证结果

### 6.1 DRC（KiCad）

| 项 | 结果 |
|---|---|
| error | **0** |
| 未连接 | **0** |
| warning | 34（**全部为 `lib_footprint_mismatch`**） |

电气类检查（短路 / 间距 / 交叉 / 禁布区 / courtyard / 孔位 / 环宽 / 悬空过孔 / 孤立铜）**全部为 0**。

34 条 warning 的来源不是缺陷，而是丝印整改（外框线宽 0.12 → 0.16 mm）后每个封装都与 KiCad 库副本不一致，属**预期结果，不进制造数据**。其中 **U2 / AE1 / U3 三个器件禁止执行"从库中更新封装"**——U2 最危险：从库更新会**静默删掉四层热隔离 keepout，且不产生任何额外的 DRC 告警**。

### 6.2 DFM（嘉立创，Gerber + 钻孔 + CPL + BOM 全量提交）

| 分析层 | 危险 | 警告 | 处理 |
|---|---|---|---|
| 线路层 | **0** | 少量（同网络） | 无需处理 |
| 阻焊层 | **0** | 1 | 0.125 mm 高于板厂 0.09 mm 下限 |
| 丝印层 | **0** | 36 | **已整改**（109 条危险清零） |
| 钻孔层 | **0** | 0 | — |
| **元件组装（SMT）** | **96** | 2 | 已完成分类与原因分析（见下） |

**丝印整改**（本批唯一改动过 PCB 图形的一项）：元件外框线宽 0.12 → **0.16 mm** 并重排位号，丝印距孔 46 → **0**、丝印距焊盘 63 → **0**，线宽 69 条警告 → **全部达标**（DFM 检查值 0.1599 ~ 0.1600 mm）。

**SMT 侧 96 条危险的溯源结果**：

| 来源 | 条数 | 性质 |
|---|---|---|
| U3 库模型朝向与板上焊盘相差 90° | 30 | **工具侧模型差异** |
| U1 引脚边界轮廓差异 | 48 | **工具侧模型差异**（自测偏差 0.0000 ~ 0.0002 mm） |
| U1 散热盘盘中孔 | 10 | **设计意图** |
| L2 引脚边界轮廓差异 | 6 | **工具侧模型差异**（25 ~ 38 µm） |
| U2 中心盘 | 1 | **工具侧封装差异** |
| 同网络铜重叠 | 1 | **允许** |
| **合计** | **96** | **无一条由板上缺铜引起** |

**板上焊盘的数量、尺寸、间距已逐个数 Gerber 闪光核对**（U1 48 个 0.20 × 0.80 mm + 4.6 × 4.6 散热盘、U3 28 个 0.40 × 1.20 mm、U2 4 个、L2 2 个），**数量、尺寸、间距均与设计一致**。

### 6.3 U3 贴装方向核对

**发现的问题**：DFM 报 U3 有 20 条"PIN脚无焊盘"+ 8 条"焊脚和焊盘相交区域"，比对所用模型的引脚朝向与板上焊盘存在 90° 差异。

**核对内容**：封装尺寸、引脚间距、CPL 角度与丝印一脚标记。

| | 排列方向 | 间距 | 单脚间距 | 跨度 |
|---|---|---|---|---|
| 板上实际焊盘（Gerber 核对） | 两排，**沿 X** | 5.20 mm | 0.635 mm | 8.255 mm |
| DFM 模型摆出的引脚 | 两列，**沿 Y** | 5.169 mm | 0.635 mm | 8.255 mm |

**核对结果**：封装尺寸与引脚间距一致，仅整体朝向相差 90°。板文件、Gerber 与坐标文件三者对应关系一致——CPL 记录 90°，丝印一脚标记（`B_Silkscreen.gbo` 中指向 pad 1 的实心三角）同样指向 pad 1；DFM 的比对依据是 BOM 中 U3 的立创编号 C5444716，其库模型默认朝向与板上不同。逐脚接触面积比均为 0.41，与规整 90° 旋转的模型相符。

**处理措施**：保留现有设计，不改版、不修改 CPL；随生产文件提供《U3 贴装方向说明》，交由嘉立创在贴装审核环节确认。

### 6.4 仿真与专项分析

| 分析 | 主要结论 |
|---|---|
| 信号完整性 | 射频链路 49.8 Ω、电长度 0.19 λ；I²C 上升时间 254 ns（上限 1000 ns，约 4 倍电容裕量）；Y1 两脚走线失配由 19.6% 降至 3.3% |
| 电源完整性 | PCB 直流压降 < 0.5 mV；瓶颈是电池内阻（60 ~ 360 mV）；告警阈值定 2.8 V |
| 热设计 | 平均功耗约 0.1 mW，最热器件结温升约 0.7 ℃；重点是 SHT40 的热耦合而非散热 |
| DFT | 测试资源清单、功耗分档测量方案、测试流程 |
| ESD / 滤波 | U4 方案与选型、四路保护前路径、EMI 布局措施 |
| LTspice 复核 | 三路负载电流按手册值与裕量设定；**占空比假设可用于负载压降评估（< 1%），用于平均电流与续航评估不可用（差 4 ~ 6 倍）** |

**LTspice 电源模型与分析结果**

模型采用的等效电路为：3.0 V 电压源串联内阻 Rb（`.step` 10 / 30 / 50 Ω，分别代表低、中、高内阻的比较工况）表示电池，三路脉冲电流源表示 nRF52810、SHT40、HT16C21A 三个负载，2.7 µF（C1 2.2 µF + 5 × 100 nF）表示去耦电容组。该模型用于分析负载电流阶跃时 VDD 的跌落深度与恢复过程，即直供方案在电池内阻较大时剩余的余量，不用于估算电池续航。因此等效电路中保留去耦电容、内阻与脉冲电流三项即可，未建立完整供电路径。

**参数依据**：nRF 取 **10 mA** —— 在手册给出的发射电流基础上设置较高裕量，用于观察较重负载条件下的供电压降与恢复过程；SHT40 取 0.6 mA（手册最大值 0.5 mA 上取 20%）；HT16C21A 取 18 µA（手册典型值，恒流）。脉冲宽度 ton = 10 ms 有两条依据：覆盖 SHT40 最慢一档测量（8.3 ms），且等于 74 倍放电时间常数，保证谷底走到稳态，而不是停在电容未放完的中间态；脉冲周期 1 s / 2 s 无手册依据，按"设备随时在上报"的常发假设设定。

**仿真取值与 PI 分析取值的区别**：早期 LTspice 仿真采用 **10 mA**，是在手册值之上留有较高裕量的负载电流，用于观察较重负载条件下的供电压降与恢复过程；后续 PI 分析采用 **6 mA**，是预期正常运行时的活动峰值电流，用于评估电池内阻压降及低电量告警阈值，属正常工况的峰值电流而非平均电流。两者分属不同负载工况的分析，取值不同有明确原因。

**与 PI 分析的分工**：LTspice 给出的是**设定负载工况下**的时域响应（三档内阻、固定占空比），谷底最低 **2.499 V**，对 HT16C21A 的 2.4 V 下限余量 99 mV；PI 分析则把**最终设计参数**（走线、平面、过孔）与**预设工作工况**（七种"寿命阶段 × 温度"组合）代入，比较 PCB 压降（< 0.5 mV）、电池内阻压降（60 ~ 480 mV）与同一根 2.4 V 下限，换算出低电量告警阈值 2.8 V 与电池内阻边界 60 Ω。仿真的占空比假设只适用于压降评估：求平均电流与续航必须用固件上报周期，同一套数按 1 s 与 60 s 两种周期算出来相差 4 ~ 6 倍。

### 6.5 文件一致性核对

Gerber / CPL / BOM 三者 8 项核对全部通过：板框、层数、坐标系（X 正 / Y 负，三者一致可直接对齐）、元件数（37 = CPL 31 + 不贴 6）、贴装面分布、孔数（92 = `drill.rpt` 92）、U3 朝向、R3 料号；与 DFM 报告的 `assembler_total_num = 31`（正面 24 / 背面 7）完全一致。

---

## 7. 主要问题与整改记录

项目主要问题及整改结果汇总如下。以下 12 项均为过程中发现并已闭环、且影响设计或交付的问题；分析过程中的计算误差另见附录 A。

| # | 问题 | 原值 / 原表述 | 更正后 | 核对方式 |
|---|---|---|---|---|
| 1 | HT16C21A 封装 | 5.3 mm 宽 | `SSOP-28_3.9x9.9mm_P0.635mm` | 核对 Holtek 手册 p34 尺寸表 |
| 2 | 四层板铜厚 | 各层均为 1 oz | 外层 1 oz / 内层 **0.5 oz** | 查嘉立创标准叠层表 |
| 3 | 去耦优先级 | "地过孔必须离芯片 < 1 mm" | 平面扩展电感按**对数**增长，应先缩短顶层走线 | 重算过孔电感与平面扩展电感 |
| 4 | 传感器下方开槽 | 按手册要求开槽 | 手册全文无 cutout / slot 等词，感湿孔在顶面 | 逐页检索 SHT4x 与 SHT3x 手册 |
| 5 | U3 焊盘局部角度 | 0°（库定义值） | **270°**（旋转后 50 条短路 / 间距违规清零） | DRC 逐脚比对焊盘定义 |
| 6 | I2C 灌电流判据 | 引用 I2C 规范 3 mA | nRF52810 手册保证值 **≥ 1 mA**（余量 11.5× → 3.8×） | 逐颗查手册 |
| 7 | 盘中孔处理方式 | 按缩小过孔孔径处理 | 改用 **POFV**（树脂塞孔 + 电镀填平） | 复核毛细作用与孔径关系 |
| 8 | 制板说明 §六 丝印线宽 | 0.12 mm（低于 0.15 mm 下限） | **0.16 mm** | DFM 检查值 |
| 9 | 制板说明 §二 最小焊盘—过孔 | 0.125 mm（3 处） | **0.150 mm**（2 处） | DFM 检查值 |
| 10 | DFM 说明 §2.1 最小铜净距 | 0.101 mm（I2C_SDA 与 R1 pad 1） | **0.200 mm**（异网络最小净距） | 版图净距测量 + DRC／DFM 结果 |
| 11 | BOM · R3 料号 | C17604（实物为 **2 kΩ**） | **C17520**（2.2 kΩ ±1%，`0805W8F2201T5E`） | DFM 的 BOM 合并数据 |
| 12 | LTspice 正文 nRF 发射电流 | 7.5 mA | **4.6 mA**（7.5 mA 出自 nRF52832 手册的 +4 dBm 档，是另一颗芯片） | 溯源数据手册章节 |

第 10 条结合版图净距测量及 DRC／DFM 结果，确认并更正为异网络最小净距 **0.200 mm**。

---

## 8. 工程实践经验总结

八周中反复用到的是下面几条做法，与具体电路无关。

### 8.1 参数逐颗查手册

I2C 灌电流引用规范值时为 3 mA，nRF52810 手册的保证值只有 ≥ 1 mA；ESD 器件漏电流按典型值 0.1 µA 核算占静态电流 0.5%，按手册最大值 1.0 µA 核算则为 5%。本项目所有支撑设计判断的参数均以器件手册为准，规范值只用于总线级的通用约束。

### 8.2 一个数字用两个独立工具交叉验证

0.101 mm 那条净距的确认（见 §7 第 10 条）依靠 DFM 与 DRC 两个独立工具的结果一致。

### 8.3 判别几何方向要用非对称图元

把 `.kicad_pcb` 的焊盘局部坐标换算到板坐标时，**旋转方向极易搞反，且搞反时是整体 180° 翻转**。QFN-48 / SSOP / 0805 / DFN 这类封装的焊盘位置集合在 180° 下**映射到自身**，因此按焊盘位置做的校验都会通过，错误只在**引脚编号**上显形（即附录 A 中误算成 (127.415, −67.400) 的那一项）。

**本项目采用的做法**：使用**非对称图元**——把丝印的 `fp_poly` 顶点算出来，去 `B_Silkscreen.gbo` 里找同形状的描线，**顶点逐个对应**。

### 8.4 报警先溯源，再决定是否改动

DFM 报了 96 条危险，逐条溯源后没有一条由板上缺铜引起（逐项分类与条数见 §6.2），并以 Gerber 闪光复核焊盘数量与尺寸作为结论的落脚点。本项目在这一步按"先分类溯源、再确定改动范围"的顺序处理，最终仅丝印一项修改了 PCB 图形。

### 8.5 区分"危险档"与"警告档"

丝印线宽整改后，危险档清零，"警告"档反而从 0 增加（数值见 §6.2），只看总数会得出相反结论。板厂以危险档作为是否接收的判据；而 0.15 mm 的最细线宽下限不能靠减少细线数量规避。

### 8.6 版图类改动必须连带修改，文件改动前必须退出工具

- 板框每左扩一次，In1 / In2 两个铺铜区的 polygon 都必须同步重画，否则新扩出来的区域**铺不上铜**。
- 改 `.kicad_pcb` 前必须**完全退出 KiCad**，否则改动会被 KiCad 的保存覆盖（本项目发生过 3 次）。
- 处理**位置完全重合**的对象必须**框选**并看状态栏的选中数量——重合过孔在屏幕上只显示一个，单击也只能选中一个，会漏删。

### 8.7 先算清代价再动手

U4 是否转 180°（§5.7）、散热过孔用 0.2 mm 还是 0.3 mm（改小会触发 `drill_out_of_range`）、射频线颈缩还是绕线（§5.3）——这三项决策均先计算两种方案的代价再选定，而非依据惯例判断。

---

## 9. 后续工作与改进计划

### 9.1 尚未闭环的事项（下单环节）

| 事项 | 状态 |
|---|---|
| **打样订单** | 工艺参数已逐项核定并留存截图，**订单尚未提交** |
| **层压顺序** | 下单页选的是"指定层压顺序"，而建议选"我的文件中已有层压顺序"（可直接读 `.gbrjob` 声明的叠层）。**须确认所指定叠层与文件一致，关键在外层到 In1.GND 的介质厚度 0.2104 mm**——叠层一变，射频阻抗必须重算 |
| **J1（C51897894）库存** | 查询时为 0 pcs，需确认交期，或改为首版手工焊接、把 J1 从 SMT 范围剔除 |
| **盘中孔报价** | 4 层板为收费项，需由下单页计价器核算 |

### 9.2 设计本身尚未做到的部分

- **没有实物、没有实测数据。** 板子尚未打样，因此本报告中所有"结论"都是**设计层面与仿真层面**的结论，不是实测结论。首件到货后必须重点复查三项：**U1 的 0.4 mm 间距焊接质量**（是否连锡、开路及焊接偏移）、**U1 散热焊盘焊点空洞**、**U3 的贴装方向**。
- **固件未开发。** 本项目范围是硬件设计与制造文件，BLE 协议栈与低功耗固件不在交付范围内。
- **未做基准点（fiducial）**。嘉立创 SMT 允许无基准点下单，其产线可在工艺边自行添加；本板尺寸小、元件间距宽松，本次未添加。
- **天线性能未实测**。射频链路按叠层算出 49.8 Ω，理论值接近 50 Ω，但**未做阻抗测试条、未实测天线增益与驻波**。首版下单时"需要阻抗"选的是"无要求（免费）"；若实测不理想，二版再选 ±10% 管控。

### 9.3 二版可改进项

| 项 | 现状 | 建议 |
|---|---|---|
| Y2（32.768 kHz）负载电容 | C9 / C10 为 12 pF，估算负载电容偏大，需复核 | 改为 **8 pF** |
| C8 的 GND 过孔 | 孔净距 **0.070 mm**，全板唯一低于 0.10 mm（受局部布局空间限制） | 重新布局 C8 / L1 区域留出通道 |
| C6 / C13 / C14 不贴装件 | 板文件中**未勾选 DNP 属性**，重新导出坐标文件时会含它们 | 在板文件中勾上 DNP，或导出后手工剔除 |
| 基准点 | 无 | 若后续批量贴装，可在工艺边三个角加 1.0 mm 铜 / 1.5 mm 开窗 |

---

## 10. 个人收获

**从"电路连对了"到"板子真的做得出来"。** 进项目时我以为硬件设计的难点在电路本身，八周下来最深的体会是：原理图画对只是起点。LCD 那 24 根线在原理图上就是 24 条网络，看不出任何问题——到版图上才发现三处限制叠加、且 U3 右列与 LCD 左列的 SEG 顺序**互为镜像**，单层无交叉的扇出在拓扑上根本不可能实现，最后靠在芯片本体下方布置 12 个换层过孔才化解。QFN-48 周边也一样：0.4 mm 间距的引脚怎么出线、散热盘里的 9 个过孔算不算盘中孔、回流路径怎么走——这些在原理图上一条都看不见。**同一张网表可以对应一块好板，也可以对应一块做不出来的板。**

**从"参数有出处"到"判断参数适不适用"。** 第 2 周做电源仿真时，我把手册上的电流直接填进电流源，觉得"有手册依据"就站得住。到第 6、7 周复核取数时才把几件当时混在一起的事分开：**典型值 ≠ 保证值**（HT16C21A 静态电流典型 18 µA / 最大 36 µA，差一倍；ESD 器件漏电流典型 0.1 µA / 最大 1.0 µA，**差十倍**）；**活动电流 ≠ 平均电流**（峰值电流用于压降分析，平均电流用于续航估算）；**手册值还带工况前提**（nRF 的 4.6 mA 是 DC/DC 档，LDO 档是 10.1 mA）。"仿真里的 10 mA 与 PI 里的 6 mA 取值不同"这类问题，也是在复核取数时发现的。

**从"做完设计"到"交付设计"。** 板子画完、DRC 清零，并不等于别人能拿去生产。要交付出去，还得把坐标文件的角度基准、BOM 的料号、钢网开窗、贴装方向、特殊工艺都写成接手者能读懂的文字：U3 的库模型朝向与板上差 90°，如果只交文件不写说明，贴装厂会照库模型摆件；R3 的料号 C17604 对应实物是 2 kΩ 而不是 2.2 kΩ，只有写进 BOM 才不会被错采；盘中孔、沉金这些收费工艺也得在下单页逐项点明。**设计只有被完整地交接出去，才算真正做完。**

---

## 附录 A：分析过程勘误（不影响设计或交付）

以下两项为分析过程中的计算误差，不涉及板文件与生产文件，记录备查。

| # | 项 | 原值 | 更正后 | 核对方式 |
|---|---|---|---|---|
| A-1 | U3 pad 1 坐标 | (127.415, −67.400) | **(135.670, −72.600)** | 用丝印三角顶点对 Gerber 描线（见 §8.3） |
| A-2 | 丝印 1 脚标记距 U3 pad 1 | 0.53 mm | 距焊盘中心 **0.47 mm** / 距外沿 0.27 mm | 按板文件重算 |

---

## 附录 B：生成式 AI 在本项目中的使用情况

本项目由本人完成需求分析与方案取舍、器件选型、原理图与 PCB 设计、LTspice 仿真，以及 DRC／DFM 检查与整改，并负责关键参数核算、结果分析和生产文件整理。生成式 AI 辅助资料整理、候选方案比较、部分计算分析，以及各周报告、总结报告和演示材料的初稿编写，相关内容经本人核查、修改后采用。具体分工如下。

| 模块 | AI 辅助的部分 | 本人完成的部分 |
|---|---|---|
| 需求分析与方案分级 | 竞品资料整理、方案对比与报告起草 | 成本目标制定、"标准带屏版"的选定、预算可行性判断与功能取舍 |
| 器件选型与 BOM | 数据手册要点整理、候选器件参数对比、BOM 表格整理 | nRF52810、SHT40、HT16C21A 与 CR2032 直供方案的选定；价格、料号及阻容值核对 |
| 原理图与建库 | 建库方法说明、ERC 问题分析辅助 | 原理图绘制与连接、符号引脚映射、封装尺寸核定及 ERC 问题整改 |
| 叠层与阻抗 | 阻抗计算方法与相关资料整理 | 查找并选定板厂四层板叠层，采用 S-G-P-S 层序及对应介质厚度；使用板厂计算器与手算确定并交叉核对馈线线宽 |
| 布局与热隔离 | 布局原则与热隔离建议整理 | 器件分区与摆放、SHT40 与主控间距安排、天线及传感器区域禁铜处理 |
| 布线与接口参数 | 布线规则及 I²C 计算分析辅助 | SEG／COM 走线分组与换层、网络类规则设置、I²C 速率与上拉电阻选取及上升时间核算 |
| 电源仿真与电源完整性 | 相关资料整理、计算分析辅助与报告起草 | LTspice 电路搭建、参数设置、仿真运行与波形分析；电池内阻及负载条件选取；电源完整性参数核算与设计判断 |
| 热设计分析 | 热模型、估算方法及计算分析辅助 | 功耗与布局条件核对、计算结果审查及热隔离措施落实 |
| ESD 与可测试性 | 保护器件参数整理、候选器件比较与测试建议 | 保护器件选型与参数确认、J1 引脚安排及保护走线、调试流程规划 |
| DRC 与 DFM 整改 | 告警条目归类、问题解释与检查报告起草 | 检查提交、未连接项与缝合过孔整改、盘中孔及器件方向核查、DFM 条目逐项判断与整改取舍 |
| 生产文件与交付 | 文件清单与核对表整理 | Gerber、BOM、CPL 等生产文件导出与一致性核对；贴装角度与贴装面确认 |
| 报告与演示 | 各周报告、总结报告、演示 PPT 与讲解稿的初稿编写及排版辅助 | 提供设计文件、工具输出与过程记录；核对数值、修改内容并确定最终结论与讲解口径 |

原理图与版图编辑、LTspice 仿真及 DRC／DFM 检查提交均由本人操作完成。尺寸与间距依据 KiCad 测量结果核对，仿真波形与电压依据 LTspice 输出分析，可制造性条目依据板厂 DFM 结果逐项审查。器件参数、计算假设及分析结论结合数据手册与实际设计条件核查；AI 提供的建议经本人判断后采用，最终设计取舍与交付内容由本人确认。

---

## 附：文件索引

| 目录 | 内容 |
|---|---|
| `wk1/` | 产品需求分析报告、第 1 周实验报告 |
| `wk2/` | 第 2 周实验报告、LTspice 电源仿真、LCD 显示方案选型报告 |
| `wk3/` | 本项目叠层方案、PCB 四层板叠层设计教学、第 3 周实验报告 |
| `wk4/` | 叠层方案、第 4 周实验报告 |
| `wk5/` | 电源模块布线分析报告、ESD 与滤波设计说明、DRC 检查说明、第 5 周实验报告 |
| `wk6/` | 信号完整性分析、电源完整性分析、热设计分析、DFT 可测试性设计说明、第 6 周实验报告 |
| `wk7/` | DFM 检查报告与优化记录、DFM 可制造性设计说明、生产文件包清单、BOM 清单与工艺说明、PCB 打样下单说明、U3 贴装方向说明、LTspice 电源仿真取数依据与适用性说明、第 7 周实验报告 |
| `wk8/` | 本报告（答辩 PPT、演示视频、开源仓库） |
| 根目录 | 《设计变更记录表》、《项目理解与个人 8 周计划》 |
| `正式工程_方案B/` | KiCad 工程源文件、`生产文件_20261009/`（生产文件包） |

---

**参考**：Sensirion SHT4x Datasheet v7.3；Nordic nRF52810 Product Specification v1.0；Holtek HT16C21A Datasheet v1.30；TI SWRA117D；IPC-4761 / IPC-2221；嘉立创 4 层板制造能力与叠层参数。
