hansonxiex-stack/nrf52-th-sensor-hardware/docs/wk1/产品需求分析报告.md

# 开源智能温湿度传感器 Pro —— 产品需求分析报告（初稿骨架）

> 提交人：谢天成
> 提交日期：2026-08-25
> 最近更新：2026-09-03（锁定显示方案：HT16C21A-28SSOP，见 §5.4）
> 对应项目要求：第 1 周交付物 ① —— 产品需求分析报告（含 3 款竞品对比）
>
> 说明：本文件已根据 Sensirion SHT3x/SHT4x 与 Nordic nRF52810/nRF52832 官方数据手册完成第一轮补充。`【待补】` 标注项仍需通过价格查询、产品说明书、参考设计或评审沟通确认。

---

## 1. 产品概述

### 1.1 一句话定位

> 一款 **目标 BOM ≤ 15 元（可按 §2.4 方案分级放宽）、完全开源（原理图 / PCB / 固件）、可扩展的 BLE 低功耗智能温湿度传感器**，
> 用 4 层板实现消费级成本、开源级可复现性。

### 1.2 目标用户与使用场景

- **目标用户**：硬件学习 / 二次开发人群、智能家居 DIY 用户、需要低成本环境监测的中小场景
- **使用场景**：
  - 室内 / 仓储 / 实验室温湿度监测
  - 作为开源硬件参考设计，供他人复现与二次开发
  - 教学演示（4 层板 + 射频 + 低功耗全流程）

### 1.3 为什么做「开源」

| 开源优势 | 硬件层落地方式 |
|---|---|
| 低功耗 | 低频广播 + 深度睡眠，BOM 选低静态电流器件 |
| 低成本 | LCSC 基础库件、精简 BOM、4 层板控制打样成本 |
| 可扩展 | 预留 GPIO / 调试接口 / 模块化供电架构 |

---

## 2. 竞品分析（第 1 周核心交付）

### 2.1 竞品选取原则

按「一个代表一类」选取 3 款，分别覆盖本项目要学的三个能力点：

| 代表产品 | 覆盖的能力点 |
|---|---|
| 米家蓝牙温湿度计 2（LYWSD03MMC） | 成本 / 功耗极限（消费级量产标杆） |
| 青萍蓝牙温湿度计 Lite（CGDK2） | 显示与低功耗平衡（段码 LCD + BLE 5.0） |
| 美德时 JR916B 蓝牙温湿度记录仪 | 高精度 + 数据记录（工业 / 仓储定位） |

### 2.2 竞品对比表

| 维度 | 米家蓝牙温湿度计2 | 青萍温湿度计 Lite | 美德时 JR916B 记录仪 |
|---|---|---|---|
| **型号** | LYWSD03MMC | CGDK2 | JR916B |
| **通信** | BLE 4.2 | BLE 5.0 | 支持蓝牙，具体版本待说明书确认 |
| **主控 / SoC** | 小米定制 BLE SoC | 未公开 | 未公开 |
| **温湿度传感器** | Sensirion（SHT30/SHTC3 系） | Sensirion（瑞士工业级） | 未公开 |
| **温度量程 / 精度** | 0~60 ℃ / 约 ±0.3 ℃ | −9.9~50 ℃ / 显示 0.1 ℃ | −20~60 ℃ / ±0.5 ℃（26~42 ℃） |
| **湿度量程 / 精度** | 0~99.9 %RH / 约 ±3 %RH | 0~99.9 %RH / 显示 0.1 %RH | 10~99 %RH / ±3 %RH（43~79 %） |
| **供电** | CR2032 × 1 | CR2430 × 1 | 2 × AAA（7 号） |
| **续航** | ≈ 1 年 | 8~12 个月（官方约 10 个月） | 约 6 个月（蓝牙款，电池可换） |
| **尺寸 (mm)** | 43×43×12.5（约 18 g） | Ø60.5×13.7（约 38 g） | 117×94×23（约 165 g） |
| **板层数** | 2 层（拆解推测） | 未公开 | 未公开 |
| **显示** | 段码 LCD | 段码 LCD | 大屏 LCD |
| **数据记录** | App（云端，需网关） | 本地约 30 天 | 本地记录 + App 历史时间轴 |
| **价格** | ≈ ¥29–39 | ≈ ¥40–60 | ¥99.9 |
| **生态 / 定位** | 米家 / Home Assistant | 米家 App | 工业 / 仓储 / 实验室 |

> 注：美德时 JR916B 蓝牙款无官方公开规格。本表精度 / 量程取自美德时 JR916 官方参数页（anymetre.com，−20~60 ℃ / ±0.5 ℃）；蓝牙款特征（蓝牙 5.0、约 6 个月续航、超限震动提醒、App 历史时间轴绘图、量程可达 −20~70 ℃）来自淘宝商品介绍，需以实物说明书确认为准。三款价格随平台 / 活动波动，仅作量级参考。

### 2.3 差异化结论

> 米家用 **2 层板 + 极简 BOM + 低频广播** 把成本 / 功耗做到极致，但**封闭、不可复现、无扩展性**；
> 青萍 Lite 用**段码 LCD + BLE 5.0 + 本地历史** 在显示与低功耗之间取得平衡，但尺寸偏大、显示成本偏高；
> 美德时 JR916B 面向**工业 / 仓储**，大屏 + 高精度 + 数据记录，但体积大、成本高、同样封闭。
> 本项目切入点：**36×36mm 4 层板、目标 BOM ≤ 15 元（分级见 §2.4）、完全开源可复现的 BLE 温湿度传感器**——
> 比米家「更开源可复现」、比青萍「更小更便宜」、比美德时「更轻量、更面向学习与二次开发」。

### 2.4 本项目方案分级（需求对齐用，不搞一刀切）

> 评审反馈：需求可以「卡得不那么死」；**三个方案都推进**，电池 / 板框 / 天线**纳入各方案**而非单列，一切以**成本与性能**权衡；依自身学习状态，**优先做模块最少的方案（A）**，其余有时间再补。

| 方案 | 传感器 | SoC | 显示 | 供电 | 板框 | 天线 | 特色功能 | 器件+PCB BOM（估） | 对标竞品 |
|---|---|-----|---|---|---|---|---|---|---|
| **A 极简广播版** | SHT40 | nRF52810 QFN48 | 无（1×LED） | CR2032 直供 | 方形 36×36 | PCB | 周期采集 + BLE 广播 | ≈ 23 元 | 无屏信标（比米家更省） |
| **B 标准带屏版** | SHT40 | nRF52810 QFN48 | 无背光段码 LCD + HT16C21A-28SSOP（已锁定，见 §5.4） | CR2032 直供 | 方形 36×36 | PCB | 广播/直连 + LCD + 按键 + 电量 | ≈ 27–38 元 | 米家 / 青萍 |
| **C 高精度 Pro 版** | SHT45 | nRF52832 QFN48 | 段码 LCD / 墨水屏 | CR2477 | 方形 36×36（或按外壳） | PCB / 陶瓷 | + NFC + 本地记录 + OTA + App | ≈ 50 元 | 美德时（工业） |

> 注：方案 A 的 23 元 = §6 逐项拆解合计（SHT40 / nRF52810 为硬数据）；方案 B 在方案 A 上增加 LCD 驱动器、裸段码 LCD 玻璃和少量外围，当前按约 +3～15 元估算。LCD 玻璃价格与尺寸、图案、COM/SEG 数量及是否定制密切相关，定标前必须取得具体型号和询价。

**方案 A · 极简广播版（成本优先）**
- 精度目标：系统 ±0.3 ℃ / ±2.5 %RH（SHT40 典型 ±0.2 ℃ / ±1.8 %RH）
- 续航：≥ 12 个月（大广播间隔，如 10–60 s）
- 功能：只广播不直连；无屏、无 NFC、无本地记录、无 OTA
- 取舍：把成本 / 功耗压到最低，牺牲显示与连接交互，最接近「纯传感器信标」

**方案 B · 标准带屏版（均衡，推荐）**
- 精度目标：同方案 A
- 显示方案：无背光、反射式裸段码 LCD + 外置 LCD 驱动器；驱动器已锁定 **HT16C21A-28SSOP**（见 §5.4）
- 供电：与nRF52810共用CR2032的VDD，按3 V直接供电；HT16C21A 工作范围为 2.4–5.5 V
- 功耗目标：带屏版整机长期平均电流暂按≤80 μA设计；显示驱动器按≤60 μA进行首轮上限预算，最终以所选料号和样机实测为准
- 续航：当前仅暂估约3～10个月；禁止采用常亮背光，最终需通过功耗预算和实测确认
- 功能：广播 + 可直连读取 + 温湿度/电量段码显示 + 按键触发 + 低电量检测
- 取舍：增加约3～15元显示硬件和持续功耗，换来不依赖App的本地读数；价格和续航均高于方案A

**方案 C · 高精度 Pro 版（性能 / 功能优先）**
- 精度目标：系统 ±0.1 ℃ / ±1.0 %RH（SHT45 典型）
- 续航：约 6–12 个月（更大容量 CR2477，可换）
- 功能：+ NFC 触碰配网 + 本地历史记录（外部 Flash）+ OTA 升级 + App 曲线
- 取舍：SHT45 + nRF52832 + 大屏 + 记录，BOM 翻倍，换来工业级精度、可扩展与数据能力

**关于「≤ 15 元」的现实（需评审确认）**
- 即便最省的方案 A（SHT40 6.27 + nRF52810 11.7 + 晶振/阻容/PCB ≈ 5.4），器件+PCB 也已约 **23 元**，且不含电池 / 外壳 / 屏。
- 结论：在「nRF52 + SHT4x + 4 层板」这套方案下，「≤ 15 元」只有在大批量量产阶梯价、把 PCB/电池/外壳排除在外、或换国产低成本 BLE SoC（如 Telink / WCH，超出本项目 nRF52 范围）时才可能接近。
- 建议对齐口径：**15 元是「器件级、量产阶梯价」还是「整机含 PCB」**；若不放宽，方案 A 也无法达标，需回到方案替换（换 SoC）层面讨论。

**推进策略（评审口径 + 自身学习状态）**：三档**都推进**，按「模块从少到多」排序——先做 **方案 A（最简单）** 打底，跑通后再依次补 **B（加屏）→ C（加 NFC / 记录 / OTA）**。电池、板框、天线均已在各方案内按成本 / 性能给定，不再单列对齐。

---

## 3. 功能需求

| 优先级 | 功能 | 说明 |
|---|---|---|
| Must | 温湿度测量 | SHT 系列数字传感器，I2C 接口 |
| Must | BLE 广播 / 直连 | 低功耗广播，间隔可配置 |
| Must | 低功耗 | 静态 + 广播平均电流达标（见 §4） |
| Must | 成本 ≤ 15 元（目标） | 软目标，分级见 §2.4 |
| Should | 状态指示 | 方案A使用LED；方案B使用无背光段码LCD和外置驱动器 |
| Should | 按键 | 手动触发广播 / 配对 |
| Could | NFC | 快速配网（nRF52 支持，可选） |
| Could | 扩展 GPIO | 预留接口，支撑二次开发 |

---

## 4. 性能规格表（可测量，对齐 §8 验收标准）

| 规格项 | 目标值（建议） | 依据 / 来源 |
|---|---|---|
| 温度量程 | −20 ~ +60 ℃ | 对齐美德时 JR916B，覆盖室内 + 仓储 |
| 温度精度 | 系统目标 ±0.3 ℃（SHT40 传感器典型 ±0.2 ℃） | SHT4x 数据手册 |
| 湿度量程 | 0 ~ 100 %RH | SHT40 数据手册 |
| 湿度精度 | 系统目标 ±2.5 %RH（SHT40 传感器典型 ±1.8 %RH） | SHT4x 数据手册；系统精度需考虑结构与热源误差 |
| 供电电压 | CR2032直接供电，标称3 V；方案B的显示驱动器与系统共用VDD | SHT4x：1.08–3.6 V；nRF52：1.7–3.6 V；HT16C21A：2.4–5.5 V。低于2.4 V后不再保证显示正常 |
| 平均功耗 | 方案A：≤20 μA；方案B：≤80 μA（首轮目标） | 方案B包含显示驱动器持续工作电流，需通过功耗预算与样机实测确认 |
| 续航目标 | 方案A：≥12个月；方案B：暂估3～10个月 | CR2032有效容量、广播策略、显示驱动电流和低温性能都会影响实际续航 |
| 通信 | BLE 5.x，广播间隔可配 | nRF52810/32 |
| 通信距离 | ≥ 10 m（室内，暂定验收环境） | 需明确测试环境、发射功率和接收端 |
| BOM 成本 | 目标 **≤ 15 元**（可按 §2.4 分级放宽） | 项目要求；实际缺口见 §2.4 / §6 |
| 板尺寸 | 36×36 mm | 项目要求 |
| 板层数 | 4 层（信号-地-电源-信号） | 项目要求，设计核心 |
| 天线 | 50Ω PCB 天线 | TI SWRA117 指南 |

---

## 5. 硬件方案选型（由竞品 + 手册推导）

> 本节为推导过程，结论经评审后再锁定。每张表填完即形成选型依据。

### 5.1 传感器选型：SHT40 vs SHT30 vs SHT45

| 对比项 | SHT30(SHT30-DIS-B2.5KS) | SHT40(SHT40-AD1B-R3) | SHT45(SHT45-AD1B-R2) | 结论倾向 |
|---|---|---|---|---|
| 温度精度 | 典型 ±0.2 ℃（0–65 ℃） | 典型 ±0.2 ℃ | 典型 ±0.1 ℃ | SHT45 最高，SHT40 已满足消费级目标 |
| 湿度精度 | 典型 ±2 %RH | 典型 ±1.8 %RH | 典型 ±1.0 %RH | SHT40 性能与成本较平衡 |
| 测量范围 | −40–125 ℃；0–100 %RH | −40–125 ℃；0–100 %RH | −40–125 ℃；0–100 %RH | 三者均覆盖目标范围 |
| 空闲 / 测量电流 | 0.2 μA 典型空闲；600 μA 典型测量 | 0.08 μA 典型空闲；320 μA 典型测量 | 与 SHT4x 平台相同的典型电气指标 | SHT4x 更适合低功耗 |
| 1 次/秒平均电流 | 1.7 μA（最低重复性、单次测量） | 0.4/1.2/2.2 μA（低/中/高重复性） | 0.4/1.2/2.2 μA（低/中/高重复性） | 可通过降低测量频率进一步降低平均值 |
| 工作电压 | 2.15–5.5 V | 1.08–3.6 V | 1.08–3.6 V | SHT4x 更适合纽扣电池直接供电 |
| 封装 | 8-pin DFN，2.5 × 2.5 × 0.9 mm | 4-pin DFN，1.5 × 1.5 × 0.54 mm（标称值） | 同 SHT4x 4-pin DFN | SHT4x 更小、引脚更少 |
| I²C 地址 / 接口 | I²C，0x44 默认或 0x45（由 ADDR 脚选择） | I²C；具体订购型号可为 0x44/0x45/0x46，常见 SHT40-AD1B 为 0x44 | I²C，SHT45-AD1B 为 0x44 | 均可直接连接 nRF52 TWI/TWIM |
| 响应时间（典型） | 湿度约 8 s；温度大于 2 s | 湿度约 4 s；温度约 2 s | 湿度约 4 s；温度约 2 s | SHT4x 响应更快 |
| 单价（LCSC，1000+阶梯价，￥） | 9.77 | 6.27 | 24.05 | 价格是最终选型关键 |

**初步选型结论**：优先选择 **SHT40-AD1B**。相较 SHT30，它尺寸更小、空闲和测量电流更低、工作电压范围更适合 CR2032 直接供电；相较 SHT45，它的精度略低，但已能满足室内消费级温湿度监测需求，预计成本更容易控制。最终仍需用 LCSC 单价和库存验证是否满足 15 元 BOM。

**PCB 设计约束**：SHT4x 顶部开孔必须接触环境空气；应远离 nRF52、电源器件、电池和显示驱动等热源。官方不建议在传感器中央焊盘下方铺铜或放置铜焊盘，以免形成热传导路径并影响片上加热器和测量结果。

### 5.2 主控选型：nRF52810 vs nRF52832

| 对比项 | nRF52810(NRF52810-QFAA-R) | nRF52832(NRF52832-QFAA-R) | 结论倾向 |
|---|---|---|---|
| Flash / RAM | 192 kB / 24 kB | 512 kB/64 kB 或 256 kB/32 kB（按具体变体） | nRF52832 余量更大；nRF52810 更精简 |
| CPU | 64 MHz Cortex-M4，无 FPU | 64 MHz Cortex-M4F，带 FPU | 本项目基本采集和 BLE 不依赖 FPU |
| 外设资源（GPIO/I²C/ADC） | 最多 32 GPIO；1 组 I²C 兼容 TWIM/TWIS；8 通道 12-bit ADC | 32 GPIO；最多 2 组 I²C 兼容 TWIM/TWIS；8 通道 12-bit ADC | 两者均满足 SHT40 + 按键 + 电量检测 |
| BLE 数据率 | 1 Mbps、2 Mbps | 1 Mbps、2 Mbps | 相同 |
| 发射功率 / 接收灵敏度 | −20 至 +4 dBm；BLE 灵敏度 −96 dBm | −20 至 +4 dBm；BLE 灵敏度 −96 dBm | 射频能力相近 |
| 射频峰值电流 | TX 0 dBm 约 4.6 mA；RX 约 4.6 mA（Key features 条件） | TX 0 dBm 约 5.3 mA；RX 约 5.4 mA | nRF52810 略低；整机平均值取决于广播占空比 |
| 低功耗模式电流（3 V） | System OFF 0.3 μA（无 RAM 保持）；0.5 μA（全 RAM 保持）；System ON + RTC 1.5 μA | System OFF 0.3 μA；0.7 μA（全 64 kB RAM 保持）；System ON + RTC 1.9 μA | nRF52810 略低 |
| NFC | 数据手册 Key features 未列出 NFCT | 支持 NFC-A Tag、触碰配对 | NFC 若为必需功能，应选 nRF52832 |
| 工作电压 | 1.7–3.6 V | 1.7–3.6 V | 均可由 CR2032 直接供电 |
| 封装 | QFN48 6 × 6 mm（QFAA） | QFN48 6 × 6 mm；WLCSP 3.0 × 3.2 mm | 首版 QFN48（QFAA）；WLCSP 不利于打样返修 |
| 单价（LCSC，1000+阶梯价，￥） | 11.7 | 16.3 | |

**初步选型结论**：若产品只需要周期采集、BLE 广播/连接和简单状态显示，优先选择 **nRF52810 QFN48（QFAA-R）**，其资源基本够用、与 nRF52832 QFN48 基本 pin 兼容（便于后续升级）且已按 11.7 元定价。若后续确认需要 NFC、较复杂的 LCD、较长历史数据、OTA/双镜像升级或更复杂协议栈，则选择 **nRF52832 QFN48** 更稳妥。最终决定需要结合固件空间估算、具体料号价格和库存。

### 5.3 电源架构：直接供电 vs LDO vs 开关电源

| 对比项 | CR2032 直接供电 | LDO（如 ME6211） | 开关电源（Buck） | 结论倾向 |
|---|---|---|---|---|
| 静态电流 | 无稳压器静态电流 | 【待补：ME6211准确型号手册】 | 【待补：候选Buck型号手册】 | 直接供电最低 |
| 电压兼容性 | nRF52 为 1.7–3.6 V；SHT4x 为 1.08–3.6 V，理论兼容 CR2032 放电范围 | 可提供固定电压，但会损失压差和有效电池容量 | 可稳压，但轻载效率和待机电流需验证 | 直接供电可行 |
| 效率 | 无转换损耗 | 约等于 VOUT/VIN | 取决于负载，轻载可能不占优势 | 小电流场景直接供电最简单 |
| 成本 / 外围复杂度 | 最低 | 增加芯片和电容 | 最高，通常还需电感等外围 | 直接供电有利于 BOM ≤ 15 元 |
| 输出噪声 | 电池本身较低，但需局部去耦 | 较低 | 通常高于 LDO，布局更复杂 | 本项目不需要 Buck |

**初步选型结论**：若最终确定使用单颗 CR2032，首版建议 **直接供电，不使用 LDO 或 Buck**。需在原理图中保留足够的局部去耦，并通过电池内阻和射频发射脉冲电流计算/测试确认最低电压不会触发复位。只有在更换为锂聚合物电池或加入其他电压不兼容器件后，才重新评估稳压方案。

### 5.4 显示方案选型：无背光段码 LCD + HT16C21A-28SSOP（已锁定）

> 结论（源自《LCD 显示方案选型报告》，本处只列最终结论）：
> 方案 B/C 采用 **无背光反射式段码 LCD + Holtek HT16C21A-28SSOP（LCSC C5444716）**，由 3 V VDD 直接供电，经 I²C（SDA/SCL）与 SHT40 共用总线。

| 对比项 | 结论 |
|---|---|
| 显示器件 | 无背光反射式段码 LCD（常显功耗低、适配 CR2032；OLED 显示能力过剩） |
| LCD 驱动器 | HT16C21A-28SSOP（C5444716），工作电压 2.4–5.5 V，覆盖 3 V VDD |
| 与 HT1621B 对比 | 2 线 I²C vs 3 线串行（引脚更少）、28-SSOP vs 48-SSOP/LQFP（体积更小）、约 18 μA vs 约 60 μA（功耗更低） |
| 驱动容量 | 20×4 / 16×8，覆盖温度、湿度、单位、电量与状态图标显示 |
| 电路影响 | 与 nRF52810、SHT40 共用 3 V VDD，VDD 引脚旁加 100 nF 去耦；SDA/SCL 并入现有 I²C 总线 |

### 5.5 天线方案：PCB 天线 vs 陶瓷天线

| 对比项 | PCB 天线 | 陶瓷天线 | 结论倾向 |
|---|---|---|---|
| 成本 | 无独立器件成本，但增加 PCB 禁布区 | 增加天线器件和匹配成本 | PCB 天线更利于成本目标 |
| 占用面积 | 天线本体和净空区较大，形状受参考设计约束 | 器件本体较小，但仍需要净空区和匹配网络 | 需结合 36 × 36 mm 板框评估 |
| 设计难度 / 一致性 | 对叠层、板框、外壳和附近铜皮敏感；必须复用参考布局并实测调谐 | 布局相对紧凑，但天线型号、地尺寸和匹配同样影响性能 | 陶瓷天线通常一致性更好，成本更高 |

**初步选型结论**：首版优先 PCB 天线以控制 BOM，但不能只照抄天线外形。需取得所选 nRF52 封装对应的 Nordic 射频参考布局，并根据最终 4 层叠层计算 50 Ω 馈线；预留 π 型匹配网络和测试位置。若板框或外壳无法满足 PCB 天线净空，再改用有完整参考设计的陶瓷天线。

---

## 6. 成本预算拆解（目标 BOM ≤ 15 元；本表 = §2.4 方案 A 基准 ≈ 23 元）

> 逐项估，找到缺口在哪里、哪里能砍。SHT40 / nRF52 为 LCSC 1000+ 阶梯价（引自 §5.1 / §5.2，属硬数据）；其余标注「估」的为参考值，最终以实际询价为准。

| 类别 | 器件 | 预估单价（￥） | 数量 | 小计（￥） | 备注 |
|---|---|---|---|---|---|
| 传感器 | SHT40-AD1B | 6.27 | 1 | 6.27 | LCSC 1000+ 阶梯价（§5.1） |
| 主控 | nRF52810-QFAA（QFN48） | 11.70 | 1 | 11.70 | LCSC 1000+ 阶梯价（§5.2，QFAA 料号）；选 nRF52832 则 16.30 |
| 电源 | CR2032 直接供电；不配置稳压芯片 | 0 | — | 0 | 若电池方案改变则重新评估 |
| 晶振 | 32 MHz + 32.768 kHz | 0.7 / 0.5 | 各 1 | 1.20 | 估，待询 LCSC |
| 阻容 | 去耦 / 滤波 / 匹配网络（约 20 颗） | 0.03 | 约 20 | 0.60 | 估，基础库件优先 |
| 天线 | PCB 天线（板载，无单独成本） | 0 | — | 0 | 或陶瓷天线【待补】 |
| 连接器 / 其它 | 电池座 / 测试点调试接口 | 0.60 | 1 | 0.60 | 估，可用测试焊盘替代 |
| PCB | 4 层板（打样分摊） | 3.00 | — | 3.00 | 估，待询嘉立创 |
| **合计（估算）** | | | | **约 23.37** | **＞ 15，超预算约 8 元**；不含电池 / 外壳 / 屏 |

### 6.1 方案 B 显示部分新增预算

| 类别 | 器件 | 预估单价（￥） | 数量 | 小计（￥） | 备注 |
|---|---|---|---|---|---|
| LCD驱动 | HT16C21A-28SSOP（C5444716，已锁定） | 1～4 | 1 | 1～4 | 见 §5.4；具体价格待 LCSC 询价确认 |
| 显示器 | 无背光裸段码LCD玻璃 | 2～10 | 1 | 2～10 | 定制图案可能另有开模费和MOQ |
| 外围 | 100 nF去耦及偏置/预留器件 | 0.1～0.5 | 1组 | 0.1～0.5 | VLCD外围以最终LCD和驱动器数据手册为准 |
| PCB/装配增量 | 布板面积或装配工序 | 0～1 | — | 0～1 | 36×36 mm能否容纳需在布局阶段验证 |
| **方案B新增合计** | | | | **约3.1～15.5** | 不含LCD定制开模费、外壳和电池 |
| **方案B总计** | 方案A 23.37 + 显示部分 | | | **约26.5～38.9** | PRD取整写约27～38元 |

> 若采用现成OLED或HT1621显示模块，样机验证更快，但模块尺寸、接口板和价格不代表正式产品方案。正式PCB仍需根据实际LCD玻璃、驱动器和机械结构重新设计。

**成本风险与对策**：已量化的核心矛盾是 **SHT40（6.27）+ nRF52810（11.70）= 17.97 元**——仅两颗主芯片就超过 15 元预算，且这是 1000+ 阶梯价、小批量更高；全 BOM（含晶振 / 阻容 / PCB 分摊）估算约 23 元。不能随意删除数据手册要求的去耦、晶振负载或射频匹配元件。若超预算，应依次评估：① 评审确认「15 元」口径（是否含 PCB / 电池 / 外壳、按打样价还是量产价）——见 §8 第 5 问；② 锁定 nRF52810 低配封装并复核小批量价；③ 取消非必要 LCD / NFC / 连接器；④ 用测试焊盘代替连接器；⑤ 比较合规替代料。关键去耦和射频网络不作为优先删减项。

---

## 7. 约束条件与 DFM 约束

| 约束 | 值 |
|---|-----|
| 板尺寸 | 36×36 mm（方形，见 §2.4） |
| 板层数 | 4 层（信号-地-电源-信号） |
| 工艺 | 嘉立创（已确认；最小线宽 / 线距 / 孔径 / 叠层待锁定） |
| 焊接 | 手工可焊 / 回流焊兼容，QFN/DFN 封装需热风或钢网 |

【待补：评审确认嘉立创具体工艺参数，避免第 7 周 DFM 返工】

---

## 8. 待确认问题（待评审确认）

1. **推进顺序**：三档都推进，先做方案 A（模块最少）打底，时间允许再补 B、C。
2. **嘉立创工艺参数**：已确认走嘉立创，提前锁定 4 层板最小线宽 / 线距 / 孔径 / 叠层，避免第 7 周 DFM 返工。

---

## 9. 仍需补充的资料清单

### 9.1 优先级 A：第 1 周必须取得

1. **项目边界确认**：15 元是否包含 PCB、显示、电池、电池座和外壳；首版是否必须显示；电池是否指定 CR2032。

### 9.2 优先级 B：第 2–3 周原理图和布局前必须取得

1. **所选 nRF52 完整封装对应的 Nordic Reference Schematic、Reference Layout/Gerber 和 Hardware Design Guidelines**。
2. **32 MHz 与 32.768 kHz 晶振候选型号数据手册**：频率精度、负载电容、ESR、启动要求、封装和价格。
3. **PCB 天线参考设计**：天线几何尺寸、所需地尺寸、净空区、匹配网络及允许修改范围。
4. **CR2032 电池与电池座数据手册**：容量、脉冲放电能力、内阻、工作温度、终止电压、尺寸和焊盘。
5. **显示器资料（方案B）**：无背光段码LCD的具体型号、外形尺寸、显示图案、COM/SEG数量与引脚映射、偏置/占空比、推荐LCD驱动电压、工作温度、连接方式、MOQ、开模费和批量价格。LCD 驱动器已锁定 HT16C21A-28SSOP（C5444716，见 §5.4），仍需确认其阶梯价格与库存。
6. **ESD 器件、按键、LED、连接器及候选稳压器数据手册**：只有确定器件后才能完成电气和封装设计。

### 9.3 优先级 C：PCB 与生产阶段需要

1. 嘉立创目标4层板叠层、介质厚度、铜厚和阻抗计算参数。
2. 嘉立创最小线宽/线距、过孔、阻焊桥、板边间距及贴片工艺能力。
3. 外壳尺寸、通风孔、电池更换方式、安装孔和禁布区要求。
4. 功耗测试方案和设备条件，例如万用表、示波器、电流分析仪或低功耗测量工具。
5. 射频验证条件：是否具备 VNA、频谱仪或由板厂/实验室协助调试天线。

---

## 参考资料

- 小米米家电子温湿度计 2 参数：https://m.suning.com/itemcanshu/0000000000/12072324558.html
- Mi Temperature and Humidity Monitor 2 Specs：https://www.mi.com/pl/product/mi-temperature-and-humidity-monitor-2/specs/
- 青萍 Temp & RH Monitor Lite 规格：https://www.qingping.co/temp-rh-monitor-lite/specifications
- 美德时（ANMEATE）JR916 官方参数页：https://anymetre.com/goods.php?id=141&lang=zh_cn
- Sensirion：SHT3x-DIS Datasheet，Version 7，December 2022（用户提供）
- Sensirion：SHT4x Datasheet，Version 7.3，June 2026（用户提供）
- Nordic Semiconductor：nRF52810 Product Specification v1.0，2017-09-29（用户提供）
- Nordic Semiconductor：nRF52832 Product Specification v1.4，2017-10-10（用户提供）
- Holtek Semiconductor：HT1621/HT1621G产品页（32×4段码LCD驱动，2.4–5.2 V）：https://www.holtek.com/page/vg/ht1621
- Holtek Semiconductor：LCD Controller & Driver产品表（HT16C21A与HT1621参数对比）：https://www.holtek.com/products/100417
- Holtek Semiconductor：HT1621 Datasheet，Application Circuits：https://static.chipdip.ru/lib/249/DOC000249765.pdf
- LCSC：HT1621B价格与库存参考：https://www.lcsc.com/product-detail/LCD-Drivers_Holtek-Semicon-HT1621B_C7873.html
- Solomon Systech：SSD1306官方产品页（128×64 OLED控制器）：https://www.solomon-systech.com/en/product/SSD1306
- Winstar：0.96英寸128×64 OLED示例（50%图案时约6 mA）：https://www.winstar.com.tw/products/oled-module/graphic-oled-display/weo012864ad.html
