hansonxiex-stack/nrf52-th-sensor-hardware/docs/wk4/第4周实验报告_智能温湿度传感器.md

# 开源智能温湿度传感器 Pro PCB 设计——第 4 周实验报告

> 姓名：谢天成
> 项目周期：第 4 周（2026.09.14—2026.09.20）
> 本周阶段：完成布局，并完成天线、LCD、I2C 三部分的布线

---

## 1. 本周目标

按第 3 周锁定的叠层方案进入实际布局与布线，具体包括：

- 完成 **Top 层**射频链路与主控段布局，把第 3 周算出的 50Ω 规则落到实际走线上。
- 落实温湿度传感器（SHT4x）的**热隔离**设计，这是本项目区别于普通 MCU 板的关键点。
- 完成 **Bottom 层**布局（段码玻璃、HT16C21A 驱动、电池座、按键、SWD），并解决 LCD 与驱动之间 24 根线的走线难题。
- 核查 I2C 总线的电气参数（速率、上拉、灌电流）与走线质量。

## 2. 本周完成情况

### 2.1 Top 层布局：射频与主控段完成

- 天线 AE1（TI SWRA117D）放置在板角，辐射边贴板边；四层 keepout 净空区（`tracks/vias/pads/copperpour not_allowed`）已核对，无走线或过孔侵入。
- 射频链路 `U1.ANT → L1 → C13/R5 → C14 → AE1` 全程 Top 层、0.36mm 线宽、无换层无过孔。末段进入 nRF52810 的 ANT 脚时受 QFN-48（0.4mm 间距）限制，做了 **0.2mm 颈缩**（长度 0.7mm ≈ 0.01λ，属集总范围，反射可忽略）。
- nRF52810（U1，QFN-48 带 EP）与 32MHz 晶振 Y1、负载电容 C15/C16 完成布局；晶振紧贴 XL1/XL2 脚，走线全程 Top。
- DC-DC 外围（L2 10µH、L3 15nH、C11 1µF）放在 U1 西侧。评测后确认：开关环路虽比"贴着芯片"略大，但**离晶振 9.0mm、离射频区 13.8mm**，隔离优先，维持现布局。

### 2.2 传感器热隔离：keepout 从单层扩展到四层 ★

**数据手册的明文要求**——SHT4x Datasheet v7.3 **§5.3 Land Pattern（第 16 页）**：

> "Soldering of the central die pad, as well as an exposed copper pad underneath it, is not recommended by Sensirion due to **it acting as a heat sink** which prevents the heater from functioning according to its specifications."

Figure 17 图注原文：

> **"There shall be no copper under the sensor other than at the pin pads."**

即：**传感器下方除引脚焊盘外不得有铜，且是所有层。**

**问题**：U2 内嵌的 keepout 原先**只有 F.Cu**。In1（GND 平面）、In2（VDD 平面）、B.Cu 在传感器正下方都是满铜。其中 In2 是载流、自热的电源平面，压在温湿度传感器正下方尤其错误。

**依据**：铜的导热系数 ≈ **385 W/(m·K)**，FR4 ≈ **0.3 W/(m·K)**，相差约 **1300 倍**。内层平面不只是"下面的铜"——它把传感器和整块板热耦合在一起，**热沉效应比表层铜更强**。去掉铜之后，剩下的 FR4 本身即是良好的隔热层。

**处理**：把 U2 内嵌 keepout 的层设置由单层改为四层。

```
(layer  "F.Cu")                                  ← 修改前
(layers "F.Cu" "B.Cu" "In1.Cu" "In2.Cu")         ← 修改后
```

净空轮廓（1.5 × 1.5 mm，绝对坐标 x 149.65~151.15 / y 86.05~87.55）不变。

**顺带澄清的两个问题：**

1. **不需要开槽（routed cutout）。** 逐页检索 SHT4x 与 SHT3x 数据手册，**全文均未出现 cutout / slot / routed / milled 等开槽相关词**。而且 SHT4x 的**感湿开孔在顶面**，底部开槽对湿度测量没有帮助——开槽是给底部开孔的传感器、或极限热隔离场合用的。
2. **开槽在本板正下方也做不到。** U2 的 4 个焊盘（0.5×0.3mm，位于 ±0.7 / ±0.4）之间**净空只有 0.9mm**，而嘉立创内槽最小宽度约 1.0mm，放不下。

**性质说明（已确认不影响后续项目）**：该 zone 位于 `.kicad_pcb` 中 U2 封装块内部（板文件），**不是库文件**。系统库 `Sensor_Humidity.pretty` 保持只读、未被改动，对以后的工程零影响。但需注意：**不可对该器件执行"从库中更新封装"**，否则 keepout 会被整体删除且不产生 DRC 告警。

### 2.3 由叠层推出的去耦设计规则

把叠层的电气后果量化后写入《叠层方案.md》：

| 连接 | 孔深 | 过孔电感 |
|---|---|---|
| F.Cu → In1.Cu（**地过孔**） | 0.2355 mm | **0.101 nH** |
| F.Cu → In2.Cu（**电源过孔**） | 1.3157 mm | 1.017 nH |

**关键结论**：In1 就在顶层下方 0.235mm，**去耦电容的地过孔几乎免费**。而平面扩展电感是**对数增长**的（1mm 0.089nH → 6mm 0.174nH → 10mm 0.198nH），远小于顶层走线的 0.30 nH/mm。

由此定出去耦优先级：① 缩短"引脚→电容 VDD 焊盘"的顶层走线② 电容地就近打过孔下 In1，不要用走线串到芯片 GND 焊盘 ③ 两个过孔的距离是次要的。**电容朝向应 VDD 焊盘朝内。**

> **一处自我修正**：最初曾按"地过孔必须离芯片 <1mm"设计，后来重算发现平面扩展电感是对数的，1mm 走线 ≈ 挪远 10mm 过孔。正确的优先级是"先缩短顶层走线"。这个结论已写入叠层文档。

### 2.4 板框扩边与铺铜区同步

为给 Bottom 层腾出走线空间，板框从 40×40mm 左扩到 **48.2 × 40mm**（x 116.80~165.00）。

**踩到的坑**：板框改了，但 In1 GND 和 In2 VDD 两个 zone 的 polygon 仍是旧板框的 `x 124.6~166`，导致新扩出来的左侧一条（约 7.8mm 宽）**铺不上铜**。

**处理**：两个 zone 的 polygon 同步改到 `x 116.1~166.0`。

**教训（本周最大的流程教训）**：

> **① 板框每改一次，两个铺铜区的 polygon 都必须同步重画。**

### 2.5 底层布局：LCD 驱动扇出分析

段码玻璃 LCD1、驱动 HT16C21A（U3）、电池座 BT1、32.768kHz 晶振 Y2、按键 SW1、SWD 座 J1 放到 Bottom 层。

**排查了 LCD 与驱动之间 24 根线难走的原因，得到三条结论：**

1. **引脚顺序其实是完美对应的**——`LCD pad N ↔ U3 pad N+4`（N = 1..24），COM0~COM3 与 SEG0~SEG19 一一对上，不存在顺序错位。
2. **两处物理限制**：
   - **U3 的焊盘是 1.2×0.4mm @ 0.635mm 间距**，相邻焊盘只剩 **0.235mm** 缝隙，而 0.2mm 走线需要 0.6mm 通道 → **焊盘之间走不了线，只能垂直出脚**；
   - **U3 的引脚跨度只有 8.25mm，而 LCD 每列跨 27.94mm**，0.635mm 间距要扇出到 2.54mm 间距，扇出必然展开。
3. 补充发现：**LCD1 的焊盘是通孔**（`thru_hole`，1.5mm / 钻 0.8mm）→ 顶底两层都能直接落到焊盘上。

**但最根本的一条瓶颈是最后才找到的：**

> **U3 右列的顺序与 LCD 左列的顺序是镜像的。**
> SEG8 在 U3 右列是最靠上的一个（y=63.80），在 LCD 左列却是最靠下的一个（y=85.18）。
> 这导致单层、无交叉的扇出**在拓扑上不可能实现**——无论通道顺序怎么排，总有一侧必然交叉。

### 2.6 LCD 24 根走线

**最终方案**：

```
10 根（COM0~COM3、SEG0~SEG5）
    U3 左列 → 左侧通道扇出 → LCD 右列焊盘

14 根（SEG6~SEG19）
    U3 右列 → 在本体下方打过孔换层到 F.Cu → 顶层布线 → LCD
```

**关键手法**：U3 是贴片件，**本体下方 B.Cu 没有铜**，所以可以在芯片正中央打 12 个过孔，用换层来化解"镜像顺序"造成的拓扑交叉。过孔全部藏在芯片底下，外部不可见。

**过程中的两次失败与原因（值得记录）**：

| 次数 | 现象 | 根因 |
|---|---|---|
| 第 1 次 | 32 条 `tracks_crossing`（走线互相交叉） | 通道排序排反了：最外侧通道配了最靠上的走廊高度，导致长横段切断了所有内侧竖段 |
| 第 2 次 | 23 条 `items_not_allowed`（走进禁布区） | 右侧上升通道安排在 `x 136.6~141.0`，而**天线禁布区从 x=137.8 开始** |

**共同根因**：**检查时只比对了"走线 ↔ 焊盘"，没有比对"走线 ↔ 走线"和"禁布区"**，所以得出了错误的"无违规"结论。

**后续修正**：走线前必须同时校验五项——① 四层禁布区 ② 走线↔走线 ③ 走线↔所有焊盘 ④ 45° 拐角 ⑤ 通道排序单调性。

最终完成布线，**DRC 电气类违规 0 条**。

### 2.7 I2C 总线专项核查 ★

**拓扑**：`U1(pin8/9) → R1/R2 上拉 → U2(SHT40) + U3(HT16C21A)` 共用一条总线。

#### ① 速率：100 kHz，不是 400 kHz

**HT16C21A 数据手册（中文版 p8）的 I2C 交流特性是分两档写的：**

| | VDD = 2.4~5.5V | VDD = 3.0~5.5V |
|---|---|---|
| f_SCL 最大值 | **100 kHz** | 400 kHz |
| t_R 上升时间上限 | **1.0 µs** | 0.3 µs |

**而 CR2032 保不住 3.0V**：标称 3.0V，一接负载立即跌破；内阻从全新的 ~10~40Ω 涨到寿命末期的数百 Ω~kΩ；nRF 蓝牙发射时 mA 级脉冲会把电压进一步拉低。

**所以 400kHz 的前提条件不成立，只能按 2.4~5.5V 那一档设计 → 100 kHz。**

#### ② 上拉电阻：保持 10 kΩ

按 100kHz 的 1.0µs 上升时间上限核算（`t_r ≈ 0.8473 × R × C`）：

| 假设总线电容 | 10kΩ 的上升时间 | 余量 |
|---|---|---|
| 30 pF | 254 ns | 3.9× |
| 40 pF | 339 ns | 2.9× |
| 50 pF | 424 ns | 2.4× |

三种估计下余量都在 2.4 倍以上，**10k 可以保持不变**，同时比 4.7k 省一半灌电流（对 CR2032 有利）。

> 一度考虑换成 4.7k（为 400kHz 留余量），确认速率只需 100kHz 后**不需要改**。

#### ③ 灌电流核算（查数据手册，不用规范值）

| 器件 | 数据手册 IOL 规格 | 出处 | 260µA 的余量 |
|---|---|---|---|
| **nRF52810** | **≥ 1 mA** @ VOL=0.4V（标准驱动） | PS **p188** | **3.8×** |
| nRF52810（高驱动） | 3 mA @ VOL=0.4V | PS p188 | 11.5× |
| **HT16C21A** | **≥ 3 mA** @ VOL=0.4V, VDD=3V | 中文 DS **p8** | **11.5×** |
| **SHT40** | 未给 IOL，仅给 `R_pullup > 390Ω` | DS **p9** | 4.7k/10k ≫ 390Ω ✓ |

> **方法上的修正**：最初引用的是 **I2C 总线规范**的 3mA（接口通用要求），而不是各芯片数据手册的实际保证值。nRF52810 的实际规格是 **≥1mA**，余量从 11.5 倍修正为 3.8 倍。**这类参数必须逐颗查手册，不能用规范值代替。**

#### ④ 走线质量

| 项 | 实测 | 判定 |
|---|---|---|
| 长度 | SCL 37.85mm / SDA 39.47mm，差 1.62mm | ✓ I2C 不要求等长，1.6mm ≈ 11ps，相对 2500ns 位周期可忽略 |
| 换层 | 各 1 次（每网 1 个过孔） | ✓ 同一网络在过孔处汇合，正确用法 |
| SDA/SCL 过孔间距 | 0.406 mm | ✓ 规则 0.2 |
| SDA 与 SCL 平行段最小间距 | 0.200 mm | ✓ 刚好卡规则，长度很短，低速下无影响 |
| R1/R2 的 VDD 就近过孔 | 1.48 / 1.29 mm，走线已连通 | ✓ 上拉是直流，不受此距离影响 |

#### ⑤ 与 32.768kHz 晶振 Y2 的干涉

**发现**：I2C_SCL 有一段 12.2mm 的横线（B.Cu，`y=74.40`），正好从 Y2 的两个焊盘（F.Cu，`y 73.70~75.50`）中间穿过，最小间距仅 **0.200mm**。

**处理**：把 Y2 下移 1.4mm（y 74.600 → 76.000），间距提升到 **0.600mm**。

**判定依据**：这不只是"0.6mm 是规则的 3 倍"，更关键的是层间关系——Y2 焊盘在 F.Cu，In1 完整地平面就在其下方 **0.236mm**，而走线在 1.61mm 外的 B.Cu。**焊盘的电场几乎全部终止在 In1 上，走线在场之外**，所以 0.6mm 的平面投影距离是安全的。（若在同层，0.6mm 就偏近了。）

### 2.8 制程检查

| 检查项 | 规则 | 实测 | 结果 |
|---|---|---|---|
| 元件焊盘到板边 | 0.5 mm | 最紧为 SW1 的 0.875mm，其余 ≥1.4mm | ✅ |
| 走线到板边（196 段） | 0.5 mm | 全部合格 | ✅ |
| 过孔到板边（19 个） | 0.5 mm | 全部合格 | ✅ |
| 走线宽度 | Default 0.2 / RF_50R 0.36 | 一致 | ✅ |

## 3. 本周遇到的问题及处理

| 问题 | 处理情况 |
|---|---|
| 传感器 keepout 只做了表层，内层平面仍是满铜 | 查 SHT4x 数据手册 §5.3 确认"传感器下方不得有铜"是**全层**要求；改为四层 keepout |
| 一度认为数据手册推荐在传感器下方开槽 | 逐页检索 SHT4x / SHT3x 数据手册，全文无 cutout/slot 相关词，此说法不成立；且感湿孔在顶面，底部开槽无收益 |
| 在 PCB 编辑器里选中不了 U2 的 keepout | 该 zone 位于**封装内部**，点选只会选中器件。确认其为板级实例、不影响库文件后直接修改该行 |
| **DRC 报 50 条短路/间距违规，全部指向 U3，无法走线** | 逐脚比对 U3 的焊盘定义，发现焊盘旋转角度异常，导致 1.2mm 长边落在 0.635mm 的引脚间距方向上、相邻焊盘重叠；修正后 50 条报错清零 |
| LCD 与驱动之间 24 根线怎么也走不通 | 找到根因：**U3 右列与 LCD 左列的顺序是镜像的**，单层无交叉在拓扑上不可能。改用"在本体下方打过孔换层"化解 |
| 走线走进天线禁布区 | 右侧上升通道排在 x 136.6~141.0，与禁布区（x≥137.8）重叠。调整后解决 |
| 板框扩了但左侧铺不上铜 | 两个 zone 的 polygon 未同步。**板框与铺铜轮廓必须同改** |
| I2C 速率与上拉如何定 | 查 HT16C21A 手册确认 400kHz 需要 VDD≥3.0V，而 CR2032 保不住 3.0V → 定 100kHz → 上拉 10k 保持不变 |
| I2C_SCL 从 32.768kHz 晶振焊盘下方穿过 | Y2 下移 1.4mm，间距从 0.200mm 提升到 0.600mm；且 In1 地平面提供层间屏蔽 |

## 4. 当前进度评估

**已完成**：全部器件布局；天线（含射频匹配网络）、LCD 驱动（24 根）、I2C 总线三部分的布线；板框定稿（48.2 × 40mm）；In1/In2 铺铜。

**DRC 现状（截至 09-20 16:28）：56 条违规 + 56 条未连接**

| 类型 | 条数 | 归属 |
|---|---|---|
| `shorting_items` / `clearance` / `tracks_crossing` / `items_not_allowed` | **0** | ✅ 电气类全部清零 |
| `silk_overlap` / `silk_over_copper` | 53 | 丝印，收尾阶段集中处理 |
| `lib_footprint_mismatch` | 3 | AE1 / U2 / U3，**均不可执行"从库中更新封装"** |
| `unconnected_items` | 56 | 见下 |

**56 条未连接的构成：**

| 网络 | 出现次数 | 说明 |
|---|---|---|
| **GND** | 49 | **主因**：32 个 GND 焊盘目前只有 4 个过孔，够不到 In1 地平面 |
| **VDD** | 24 | 16 个 VDD 焊盘只有 2 个过孔，够不到 In2 电源平面 |
| KEY / XL1 / XL2 | 6 / 4 / 4 | 按键 SW1、32.768kHz 晶振 Y2 的连线 |
| DEC4 / DEC1 / DCC | 3 / 2 / 2 | DC-DC 外围 |
| SWDCLK / SWDIO / RESET / LED | 2 / 2 / 2 / 2 | 调试口、复位、指示灯 |

> 每条未连接涉及两个网络，故上表次数之和大于 56。

**未完成**：
1. **GND / VDD 缝合过孔**（约 40~48 个）—— 这是 56 条未连接的主因，不是布线问题
2. 按键、晶振、DC-DC、SWD/LED 等信号的走线
3. 丝印整理（53 条）

## 5. 下周计划

1. **补齐 GND / VDD 缝合过孔** —— 32 个 GND 焊盘现有 4 个过孔，16 个 VDD 焊盘现有 2 个，是当前 56 条未连接的主因。
2. 走完剩余信号：按键 SW1、32.768kHz 晶振 Y2、DC-DC 外围、SWD / 复位 / 指示灯。
3. 整理丝印（53 条），收尾阶段集中处理。
4. 输出制板文件（Gerber + 钻孔 + 阻抗控制要求），评审确认后下样。

## 6. 本周总结

本周完成了全部器件布局，并走通了天线、LCD、I2C 三部分布线，**DRC 的电气类违规（短路、间距、交叉、禁布区）全部清零**。

技术上最有价值的两处收获：

**① LCD 扇出的拓扑矛盾**——引脚顺序是完美对应的（`LCD pad N ↔ U3 pad N+4`），但 **U3 右列与 LCD 左列的顺序互为镜像**，加上 U3 焊盘 0.235mm 的缝隙走线穿不过去、引脚跨度 8.25mm 要展开到 27.94mm，三者叠加导致单层无交叉走线在拓扑上不可能。最终用"在芯片本体下方打过孔换层"化解——利用贴片器件本体下方无铜的特性，把 12 个过孔藏在芯片底下。

**② I2C 参数必须逐颗查手册**——最初引用的 3mA 是 I2C 总线规范值，实际查手册后发现 nRF52810 的保证值只有 ≥1mA。另外确认了 400kHz 需要 VDD≥3.0V，而 CR2032 的电压特性满足不了，因此定在 100kHz、上拉保持 10k。

流程上有两条教训值得记牢：

**① 板框改了，两个铺铜区的 polygon 必须同步重画。** 三次板框左扩都只改了 `gr_rect`，新区域一直铺不上铜。
**② 改 `.kicad_pcb` 前必须完全退出 KiCad。** 本周有 3 次文件改动被 KiCad 的保存覆盖。

还有一条关于自查方法的教训：走线检查最初只比对了"走线↔焊盘"，漏掉了"走线↔走线"和"禁布区"，因此得出了**错误的通过结论**，导致 32 条交叉和 23 条禁布区违规在 DRC 时才暴露。补上五项校验（禁布区、走线↔走线、走线↔焊盘、45° 拐角、通道排序单调性）之后才可靠。
