hansonxiex-stack/nrf52-th-sensor-hardware/docs/wk6/电源完整性分析_智能温湿度传感器.md

# 电源完整性分析

**项目**：智能温湿度传感器（方案 B） · 四层板 · nRF52810 + SHT40 + HT16C21A + 20×4 段码 LCD + CR2032
**日期**：2026-10-04，修订 2026-10-06　**依据文件**：`正式工程_方案B.kicad_pcb`、`BOM.csv`

本报告依据设计文件、器件资料及工程估算，分析本板供电网络的电压稳定性，为当前设计取值和后续调试提供依据。

---

## 1. 供电架构与工作范围

```
CR2032（标称 3.0 V）
   │
   └── BT1 ──┬── C1 2.2 µF（局部储能）
             │
             └── In2 完整电源平面（VDD）──┬── U1 nRF52810（内部 DC-DC）
                                          ├── U3 HT16C21A（LCD 驱动）
                                          ├── U2 SHT40（传感器）
                                          ├── R1/R2（I²C 上拉）
                                          └── R3 → D1（状态指示）
```

**不使用 LDO**：本项目关注的电池电压区间（约 2.5 ~ 3.2 V）落在 nRF52810 的 1.7~3.6 V 输入范围内，无需稳压；加入 LDO 会带来压差损失与额外的静态功耗，对本机的低功耗目标不利。

### 1.1 电池电压的术语与取值

锂锰纽扣电池的端电压在放电过程和不同温度下有较大跨度，**"电池电压"这个词本身不是单值的**。为避免全文混用，统一按下表的口径表述：

| 术语 | 定义 | CR2032 取值 |
|---|---|---|
| **标称电压** | 电芯规格书给出的标称值，用于器件选型与功耗估算 | **3.0 V** |
| **开路电压 V_OCV** | 无负载时电池两端电压，随放电深度与温度变化 | 新电池 25 °C 约 **3.2 V**；寿命末期降至 2.6 V 以下 |
| **最高电压** | 设计输入上限 | 暂按 **3.3 V** 取值 |
| **负载电压 V_LOAD** | 带载时器件端电压，`V_LOAD = V_OCV − I·R_bat` | §4 的计算对象 |
| **工作范围** | 全板器件均满足规格的供电区间 | **2.4 ~ 3.3 V** |
| **低电量告警阈值** | 固件判定低电量的门限，按轻载时的端电压判定 | **2.8 V**（推导见 §4.3） |

**工作范围**　下限由 U3（HT16C21A）的 **2.4 V** 决定，上限为上述设计输入上限 **3.3 V**。因此本板按 **2.4 ~ 3.3 V** 分析。nRF52810 可低至 1.7 V、U2（SHT40）可低至 1.08 V，均不构成下限。

**这决定了本板 PI 分析的重心**：没有稳压器，电池内阻造成的压降会直接落在器件上。**本板 PCB 导电路径的直流压降较小，供电分析重点是电池内阻压降及局部去耦。**

## 2. 去耦网络

### 2.1 PDN 构成

| 组成部分 | 实现 | 说明 |
|---|---|---|
| **电源平面** | In2 完整 VDD 平面（0.5 oz），不分块不切槽 | 提供低阻抗的电流分配 |
| **去耦电容** | C1 2.2 µF（局部储能）＋ **5 颗** 100 nF（VDD 引脚）＋ 4 个 DEC 电容位（其中 C6 不贴装） | 去耦主力 |
| **过孔** | 10 个 VDD 过孔、38 个 GND 过孔 | 连接各层 |

**两类电容需要分开看**：直接接 VDD 的 C4、C12、C17、C18、C19 服务 VDD 网络；C7、C6、C5、C11 分别接 U1 的 DEC1~DEC4，服务的是芯片内部电源节点，不直接并联在 VDD 平面上，不应与前一组合并计数。

**平面电容**　In1.GND 与 In2.VDD 之间夹 1.065 mm 芯板（Er ≈ 4.5），构成平行板电容：

```
C_plane = ε0·εr·A/d = 8.854×10⁻¹² × 4.5 × 1.928×10⁻³ / 1.065×10⁻³ ≈ 72 pF
```

相对 2.2 µF 的体电容小四个数量级，**对本板的低频储能贡献很小**。本板 VDD 平面真正的作用是低阻抗的电流分配，而不是储能。

### 2.2 去耦的频段说明

**2.2 µF 用于局部储能，100 nF 用于各芯片电源脚的高频去耦；两者的实际效果由电容量、ESR、ESL 和连接电感共同决定。**

按 ESL = 0.6 nH 估算，0402 封装 100 nF 的自谐振频率约 20 MHz。超过自谐振后电容转为感性、阻抗随频率上升，但**阻抗上升不等于失去去耦作用**。取 50 MHz 作对比：

```
100 nF 电容：X_L = 2πfL ≈ 0.19 Ω，X_C = 1/(2πfC) ≈ 0.03 Ω
             |Z| ≈ |0.19 − 0.03| ≈ 0.16 Ω
72 pF 平面电容：|Z| = 1/(2π × 50 MHz × 72 pF) ≈ 44 Ω
```

在该频点上电容的阻抗仍比平面电容低两个数量级以上，去耦依然由电容承担。平面电容在更高频段的贡献，需要结合具体的电流变化速率与回路电感评估，不能仅凭阻抗的单调性判断。

### 2.3 DC-DC 输出外围

U1 内部 DC-DC 的输出（DEC4）外接 **L2 10 µH、L3 15 nH、C11 1.0 µF**。经网表核实，**L2 与 L3 之间没有电容支路，两者在电路上串联**（L_eq ≈ 10.02 µH），C11 是唯一的输出电容。

该网络的元件取值来自 Nordic nRF52810 参考设计，作用是配合芯片内部 DC-DC 完成降压与输出滤波。其滤波效果由内部开关频率、电感直流电阻、C11 的 ESR/ESL 与负载共同决定。

<div class="keep" markdown="1">

## 3. PCB 侧的电压降落

从电池到芯片，电流经过三段路径：

| 段 | 计算 | 6 mA 下的压降 |
|---|---|---|
| **走线**（最坏路径按 25 mm、0.2 mm 宽、1 oz 铜） | R = ρL/A = 0.061 Ω | **0.4 mV** |
| **In2 电源平面**（片电阻 1.13 mΩ/□，取 20×20 mm 一段） | R ≈ 1.1 mΩ | **约 7 µV** |
| **过孔**（0.7/0.3 mm） | 单孔电阻在 0.5 mΩ 量级 | 可忽略 |

**PCB 侧合计 < 0.5 mV。**

</div>

本板负载在毫安级，走线、平面与过孔的**载流与压降都不是约束**，0.2 mm 走线与 0.3 mm 孔径过孔的载流余量充足。过孔选用 0.7/0.3 mm 是由工艺规则下限（`min_via_diameter = 0.6`、`min_via_annular_width = 0.2`）决定的，不是由载流决定的。

## 4. 电池脉冲压降（本板 PI 的主导项）

### 4.1 电池内阻造成的压降

```
ΔV = I × R_bat
```

内阻不是常数，它受**温度**与**放电深度**共同影响。下表按「寿命阶段 × 温度」列出七种**估算工况**，负载电流取本板峰值 6 mA：

| # | 寿命阶段 | 温度 | 开路电压 V_OCV | 内阻 R_bat | 6 mA 下压降 | 负载电压 V_LOAD | vs U3 的 2.4 V |
|---|---|---|---|---|---|---|---|
| ① | 新电池 | 25 °C | 3.20 V | 10 Ω | 60 mV | 3.14 V | ✓ |
| ② | 新电池 | −10 °C | 3.15 V | 20 Ω | 120 mV | 3.03 V | ✓ |
| ③ | 中等放电 | 25 °C | 2.95 V | 20 Ω | 120 mV | 2.83 V | ✓ |
| ④ | 中等放电 | −10 °C | 2.90 V | 40 Ω | 240 mV | 2.66 V | ✓ |
| ⑤ | 寿命末期 | 25 °C | 2.70 V | 40 Ω | 240 mV | 2.46 V | ✓（余量 60 mV） |
| ⑥ | 寿命末期 | 0 °C | 2.65 V | 60 Ω | **360 mV** | **2.29 V** | **✗** |
| ⑦ | 寿命末期 | −10 °C | 2.60 V | 80 Ω | **480 mV** | **2.12 V** | **✗** |

> 各工况的开路电压与内阻按通用 CR2032 特性估算，**不对应某一具体电芯**；选定型号后应按其**放电曲线**与**温度-内阻曲线**复核，重点是 0 °C 以下的数据。

**由表得到两条结论：**

- **在所列工况中，常温工况均满足供电下限**（①③⑤，最低为 ⑤ 的 2.46 V）；
- **末期低温工况下，电池压降增大，LCD 驱动首先低于保证工作电压**（⑥⑦）。这也是判据取 U3 的 2.4 V、而不是 nRF52810 的 1.7 V 的原因。

电池内阻造成的压降（60 ~ 480 mV）比 PCB 侧全部压降（< 0.5 mV）高**两个数量级以上**。

### 4.2 体电容能支撑多久

<div class="keep" markdown="1">

负载阶跃时，去耦电容同时供电，因此还要看电流脉冲持续多久。假设 6 mA 全部由 C1 提供、允许下降 30 mV：

```
Δt = C·ΔV / I = 2.2 µF × 30 mV / 6 mA ≈ 11 µs
```

该计算不是电压跌落的预测。它说明的是：**在电容独立提供 6 mA、允许压降 30 mV 的假设下，C1 的支撑时间约为 11 µs**——即体电容主要用于短时缓冲，**持续供电仍依赖电池**，平均电流决定了电池能支撑多久。

</div>

### 4.3 低电量告警阈值

告警必须**在 U3 跌破保证工作电压之前**发出，因此阈值不能直接取 2.4 V。**保证供电的条件**是：

```
V_OCV − I × R_bat ≥ 2.4 V        （U3 的保证工作下限）
```

<div class="keybox" markdown="1">
<p class="kb-title">取值依据</p>

```
V_alarm = 2.4 + I_peak × R_design + V_margin
        = 2.4 + 0.006 × 40 + 0.16
        = 2.80 V
```

**I_peak = 6 mA**　整板峰值电流，与《热设计分析》§1.2 的峰值功耗采用相同工况。

**R_design = 40 Ω**　**室内常温场景采用的设计内阻估算值**。§4.1 表中 60 ~ 80 Ω 的低温、放电末期工况作为**额外校核**保留，不纳入本阈值的设计覆盖范围。

**V_margin = 160 mV**　**总设计余量**，用于吸收电池电压检测误差、电池内阻及峰值电流估算偏差与老化裕量。该数值是设计取值，不等于 ADC 的误差值。

</div>

**按 ADC 比例误差上限校核**（手册 SAADC 电气规格 `EG1/6`，增益 1/6，**−3% ~ +3%**，脚注 b 注明不含温漂）：

```
最坏按 +3% 计：读数 2.8 V 对应的实际电池电压
    2.8 / 1.03 ≈ 2.718 V
扣除 40 Ω × 6 mA = 240 mV 的电池内阻压降
    2.718 − 0.240 = 2.478 V

在上述估算条件下，距 2.4 V 下限约有 78 mV 余量。
```

**取值：低电量告警阈值 = 2.8 V**，按**轻载时的端电压**判定。

**测量方式**　固件在**主要负载空闲、供电电压恢复后**采样，以减小电池内阻压降对读数的影响。

nRF52810 的 SAADC **可以直接把 VDD 选作输入通道**（PS Table 69：`CH[n].PSELP = VDD` 合法），**不需要外加分压电阻**；当前 ADC 配置（内部参考 + 1/6 增益）的**满量程为 3.6 V**。

<div class="keep" markdown="1">

### 4.4 续航估算

续航按**平均电流**估算，与瞬时压降所用的**峰值电流（6 mA）不可混用**：

```
t = 可用容量 / 平均电流
  = (150 ~ 200 mAh) / 0.033 mA
  ≈ 189 ~ 253 天 ≈ 6 ~ 8 个月
```

- **平均电流 33 µA** 取自《热设计分析》§1.4，其假设为：BLE 广播间隔 1 s、单次发射 1.5 ms；传感器采样间隔 60 s、单次 8.3 ms；每次广播后 CPU 处理 3 ms；LCD 常显。
- **可用容量 150 ~ 200 mAh** 是**续航预算假设**，不是厂家放电曲线上精确对应 2.8 V 的容量。

**按可用容量暂取 150 ~ 200 mAh、平均电流约 33 µA 估算，预计使用时间约 6 ~ 8 个月（量级估算，不是保证的告警触发时间），出现持续低电量告警时提前更换。**

</div>

## 5. 结论

| 项 | 结论 |
|---|---|
| **供电架构** | CR2032 直供 + In2 完整平面，满足要求，当前架构可保留 |
| **工作范围** | **2.4 ~ 3.3 V**；下限由 U3（HT16C21A）决定，设计输入上限暂按 3.3 V 取值 |
| **去耦** | 2.2 µF 局部储能 + 5 颗 100 nF 引脚去耦，DEC 电容按参考设计配置；当前取值可保留 |
| **PCB 压降** | < 0.5 mV，相对电池内阻可忽略；毫安级负载下走线与过孔载流余量充足 |
| **限制所在** | 电池内阻：`ΔV = I·R_bat` 是主导项。所列工况中常温工况均满足供电下限；**末期低温工况下电池压降增大，LCD 驱动首先低于保证工作电压** |
| **低电量告警阈值** | **2.8 V**（按轻载时的端电压判定）= 2.4 V + 6 mA × 40 Ω + 160 mV 设计余量 |
| **后续** | ① 索取选定电芯的**放电曲线**与**温度-内阻曲线**（重点是 0 °C 以下）；② 据此复核告警阈值与产品的最低工作温度 |

---

## 附录 A　计算依据

### A.1 目标阻抗

```
Z_target = ΔV_允许 / ΔI_瞬态
```

- **ΔV 允许 = 30 mV**：本报告设定的设计预算（约标称电压 3.0 V 的 1%）。该数值是设计目标，不由器件的供电范围推出。
- **ΔI 瞬态取 VDD 侧的负载电流变化**：按射频发射开启的阶跃，约 4.6 mA。此处不使用 U1 内部 DC-DC 的电感峰值电流——后者位于 DEC4 侧，不直接构成 VDD 网络的负载阶跃。

```
Z_target = 30 mV / 4.6 mA ≈ 6.5 Ω
```

单颗电容在某一频点的阻抗为

```
|Z| = √( ESR² + (ωESL − 1/ωC)² )
```

但**单颗电容的阻抗不能代表整个 PDN**——完整评估还需计入全部电容、平面与连接电感。本报告不据此给出倍数结论：本板的判断依据是 PCB 导电路径的直流压降（毫安级负载下 < 0.5 mV，见 §3），高频段的供电阻抗由 §2.2 的局部去耦承担。

**30 mV 预算的适用范围**：该预算用于局部快速瞬态的去耦设计参考；电池内阻压降（§4，60 ~ 480 mV），按器件的最低工作电压单独校核。

### A.2 数据来源

| 数据 | 来源 |
|---|---|
| 板框尺寸、铺铜层、过孔数量 | 从 `正式工程_方案B.kicad_pcb` 文件提取（65 过孔：GND 38 / VDD 10 / 信号 17） |
| 电容容值、器件位号与位置 | `BOM.csv` + PCB 文件 |
| 网络拓扑（L2–L3 串联、C11 接 DEC4） | 从 `正式工程_方案B.net` 网表核实 |
| 叠层介质厚度与 Er | 《本项目叠层方案_智能温湿度传感器_4层板》 |
| DC-DC 外围元件取值 | Nordic nRF52810 参考设计 |
| U3 工作电压下限 2.4 V | HT16C21A 数据手册 |
| CR2032 内阻范围 | 通用 CR2032 规格书典型值，按电芯规格书复核 |
| SAADC 可直接测量 VDD（`CH[n].PSELP = VDD`） | Nordic nRF52810 产品规格书 Table 69（Legal connectivity CH[n] vs. analog input） |
| SAADC 增益误差 `EG1/6` = −3% ~ +3%（不含温漂） | **Nordic nRF52810 产品规格书 v1.0（4430_161）印刷页 370**，§6.17.12.1 SAADC Electrical Specification；脚注 b "Does not include temperature drift" |
| 平均电流 33 µA 及其假设 | 《热设计分析》§1.4 |
| 可用容量 150 ~ 200 mAh | **续航预算假设**，非厂家曲线对应值，待选定电芯后复核 |
| 平面电容计算 | 平行板电容模型 C = ε0·εr·A/d |
