hansonxiex-stack/nrf52-th-sensor-hardware/docs/wk7/DFM可制造性设计说明_智能温湿度传感器.md

# DFM 可制造性设计说明

**项目**：智能温湿度传感器（方案 B） · 四层板 · nRF52810 + SHT40 + HT16C21A + 20×4 段码 LCD + CR2032
**日期**：2026-10-11 定稿 / **2026-10-12 补入评审确认结论**（§3.4、§5、§5.1、§6）　**依据文件**：`正式工程_方案B.kicad_pcb`、`DRC.rpt`、生产文件包（2026-10-09 批）
**目标工艺**：嘉立创 4 层板常规工艺

本说明依据最终设计文件，逐项核对本板与嘉立创 4 层板工艺能力的匹配情况，给出生产文件清单与下单前需向板厂确认的事项。

---

## 1. 板参数与工艺选定

### 1.1 板参数

| 项目 | 数值 |
|---|---|
| 层数 | 4 层 |
| 板框 | 48.2 × 40.0 mm 矩形，无挖槽、无内部开窗 |
| 成品板厚 | 1.6 mm |
| 铜厚 | 外层 1 oz / 内层 0.5 oz |
| 走线 | 354 段：0.20 mm（339 段）、0.36 mm（15 段），全部位于 F.Cu 与 B.Cu |
| 内层 | In1.GND、In2.VDD 均为整层平面，**无走线** |
| 过孔 | 65 个，全部 0.70 mm 盘 / 0.30 mm 孔 |
| 插件孔 | 0.80 mm（LCD1，24 个）、1.50 mm（BT1，2 个）、0.30 mm（AE1 馈点，1 个） |
| 孔总数 | 92，全部为镀通孔；无非镀通孔 |
| 元件 | 37 个（正面 28 / 背面 9） |
| DRC | **0 error / 0 未连接 / 34 warning** —— 34 条全部是 `lib_footprint_mismatch`（封装与 KiCad 库副本不一致的"本地覆盖"），源于丝印加粗这一步，属预期结果，不进制造数据 |

### 1.2 叠层

叠层与嘉立创 4 层 1.6 mm 标准模板 `JLC04161H-7628` 一致（详见《叠层方案》§1）：

```
F.Cu          1 oz        0.035  mm
prepreg 7628  εr 4.4      0.2104 mm
In1.Cu        0.5 oz      0.0152 mm    ← GND 平面
core          εr 4.5      1.065  mm
In2.Cu        0.5 oz      0.0152 mm    ← VDD 平面
prepreg 7628  εr 4.4      0.2104 mm
B.Cu          1 oz        0.035  mm
```

**该叠层为嘉立创标准叠层，不产生指定叠层的额外费用。** 射频馈线（0.36 mm）的 50 Ω 阻抗控制建立在 0.2104 mm 介质与 εr 4.4 之上，若更换叠层必须重新核算阻抗。

### 1.3 表面处理

**选定沉金（ENIG）**，理由有二：

1. U1 为 0.4 mm 间距 QFN，焊盘宽仅 0.2 mm，喷锡的锡面不平整度在该间距下会带来立碑与连锡风险；
2. 本板含盘中孔（§3），孔口需在树脂塞孔并电镀填平后保持平整，沉金的平整度优于喷锡。

沉金在嘉立创为收费选项。若改用无铅喷锡，需在首件上重点复查 U1 的焊接质量。

**下单页状态（2026-10-12）**：表面处理已选**沉金（收费）**、沉金厚度 **1u"**（常规档）。见《PCB 打样下单说明》§2、§3.2。

## 2. 工艺能力核对

按嘉立创 4 层板常规工艺（外层 1 oz / 内层 0.5 oz）逐项核对：

| 项目 | 本设计 | 嘉立创能力 | 判定 |
|---|---|---|---|
| 最小线宽 | 0.20 mm | 0.09 mm | ✅ |
| 最小铜净距（异网络） | **0.200 mm** | 0.09 mm | ✅ 见 §2.1 |
| 最小过孔孔径 | 0.30 mm | 0.15 mm 极限 / 0.20 mm 推荐 | ✅ |
| 最小过孔盘径 | 0.70 mm | 0.25 mm | ✅ |
| 过孔环宽 | 0.20 mm | ≥0.20 mm 推荐 / 0.15 mm 极限 | ✅ 取推荐值 |
| 插件孔最小环宽 | 0.25 mm（BT1） | ≥0.20 mm | ✅ |
| 过孔孔到孔 | 0.90 mm | 0.20 mm | ✅ |
| 插件孔孔到孔 | 1.74 mm（LCD1） | 0.45 mm | ✅ |
| 铜到板边 | ≥0.50 mm | ≥0.20 mm（铣边） | ✅ |
| 阻焊桥 | 0.20 mm（QFN 0.4 mm 间距） | 0.10 mm | ✅ |
| 阻焊开窗到相邻走线 | ≥0.10 mm | ≥0.09 mm | ✅ |
| 钢网面积比（0402 封装） | 1.22 | >0.66 可印刷 | ✅ |
| 丝印最细线宽 | **0.16 mm** | ≥0.15 mm | ✅ 见 §2.3 |
| 成品板厚 | 1.6 mm | 1.6 mm 标准档 | ✅ |
| 最小孔径附加费 | 0.30 mm | 0.30 mm 属常规组合 | ✅ |

### 2.1 最小铜净距

嘉立创 DFM 对线路层逐对实测的结果：**异网络的最小铜净距为 0.200 mm**（走线—走线、盘—线、盘—铜皮三项的最小实测值均为 0.200 mm），与设计中的网络类间距规则（0.20 mm）一致，全板无更紧处，对嘉立创 0.09 mm 下限的余量充足。

另有两处同网络的紧点需要区分说明（同网络不受 0.20 mm 规则约束）：

| 实测净距 | 位置 | 判定 |
|---|---|---|
| **0.150 mm** | VIA 孔到焊盘（2 处） | 高于常规工艺下限，不必处理 |
| 0.107 mm | 焊盘距焊盘（1 处，位于 (161.85, −77.8)） | 同上，只在同网络内 |

> **勘误**：本文早期版本（2026-10-07）记录"最小铜净距 0.101 mm（I2C_SDA 与 R1 pad 1）"，并建议下单时向板厂点明该位置。该值在 2026-10-09 批次的 DFM 中**找不到任何支撑** —— 若真有 0.101 mm 的异网络间距，DFM 会判为"危险"、DRC 也会报错，而两者都没有。判断为 **10-08 移动过孔之前的旧值**，**该条已删除**，向板厂点明该位置的建议一并撤销（向板厂点一个不存在的紧点，比不写更容易引起误解）。详见《DFM 检查报告与优化记录》§2.2。

### 2.2 阻焊开窗到走线

本板的阻焊开窗与焊盘等大（`pad_to_mask_clearance = 0`），因此"开窗到相邻走线"的间距等于焊盘到走线的最小间距，板级实测最小为 0.10 mm，高于嘉立创 0.09 mm 的下限。

### 2.3 丝印

**已整改。** 元件外框线宽由 0.12 mm 加粗至 **0.16 mm**，位号文字 0.15 ~ 0.16 mm，均不低于嘉立创 0.15 mm 的下限；DFM 实测 0.1599 ~ 0.1600 mm，丝印线条宽度一项**全部达标**。

整改同时重排了位号避让焊盘与过孔：丝印类"危险"项由 **109 条清零**（丝印距孔 46 → 0、丝印距焊盘 63 → 0）。加粗后线与焊盘/孔的净距随之减小，剩余 36 条落在 DFM 的"警告"档（最紧 0.131 mm）。丝印属工艺标识，不影响电气性能。

整改过程见《DFM 检查报告与优化记录》§2.1。

## 3. 关键项：U1 散热焊盘盘中孔

这是本板唯一一项超出常规工艺范围的设计。

### 3.1 现状

U1（nRF52810，QFN-48，6 × 6 mm）的散热焊盘为 pad 49：**4.6 × 4.6 mm 矩形，F.Cu + F.Mask 开窗，网络 GND**。焊盘内部布置了 **9 个 GND 过孔**，0.70 mm 盘 / 0.30 mm 孔，3 × 3 阵列，行距 1.60 mm、列距 1.80 mm。

**阻焊层核对**：`F.Mask` 图层无极性反转、也无独立的过孔开窗，9 个过孔完全落在散热焊盘的开窗范围内——设计上属于**盘中孔**。

**钢网层核对**：焊盘上方为 9 块 1.24 × 1.24 mm 开窗（中心距 1.53 mm），**每块开窗正下方即一个过孔**。

### 3.2 风险

<div class="keybox" markdown="1">
<p class="kb-title">锡膏流失估算</p>

```
钢网锡膏体积 = 9 × 1.24 × 1.24 × 0.12 mm(钢网厚) ≈ 1.66 mm³
过孔内容积   = 9 × π × 0.15² × 1.6 mm(板厚)      ≈ 1.02 mm³
```

按上述估算，回流时约 **60% 的锡膏**可能被吸入过孔，使散热焊盘焊点出现空洞。

</div>

该风险的影响范围**仅限于散热焊盘自身的焊接质量**：

- 受影响的是 U1 散热焊盘与其下方 In1.GND 平面之间的焊点；
- 空洞会降低散热与机械连接的可靠性。按《热设计分析》§1.4，本板平均功耗约 0.1 mW、最热器件结温升约 0.7 °C ——**该数据只说明热设计余量充足，不能据此认定焊接风险可以忽略**。

### 3.3 处理方案

按评审确认，向板厂指定**盘中孔工艺（树脂塞孔 + 电镀填平，即 IPC-4761 Type VII / POFV）**：

- 嘉立创支持该工艺，适用孔径 0.15 ~ 0.55 mm，本设计的 0.30 mm 在范围内；
- **4 层板的盘中孔为收费选项**——嘉立创仅对 6 层及以上免费；4 层板免费的是"过孔塞油"（阻焊油墨塞孔），与盘中孔不是同一工艺，需在下单时选择并由计价器核算；
- 其余 56 个过孔不涉及盘中孔，按 4 层板标配的免费"过孔塞油"处理即可。

### 3.4 结论

**采用盘中孔工艺（树脂塞孔 + 电镀填平）。** 4 层板的该工艺为收费项，尚未取得报价。

> **已确认并已落实（2026-10-12）**：首版**采用盘中孔工艺，不做简化**，下单页"阻焊覆盖"**已选定**「过孔塞树脂 + 过孔电镀盖帽」（见《PCB 打样下单说明》§2、§3.3）。见《DFM 检查报告与优化记录》§5.1。

## 4. 装配相关

### 4.1 双面贴装

正面 28 个元件、背面 9 个元件，需**双面钢网与两次过炉**。背面元件以 U3（SSOP-28）、U4（SOT-23-6）、SW1、J1、C1、C19、R4 为主，均为小质量器件，第二次回流时可依靠焊锡表面张力固定，无需点胶。

### 4.2 基准点

**设计文件中未放置基准点（fiducial）。** 嘉立创 SMT 允许无基准点下单，其产线可在工艺边上自行添加；若需在设计侧固定，可在工艺边三个角添加 1.0 mm 铜 / 1.5 mm 开窗的基准点。本板尺寸小、元件间距宽松，不添加不构成风险。

### 4.3 贴装范围

生产文件的 CPL 与 BOM 按 **31 个 SMT 位号**出具，以下 6 个位号不在 SMT 范围：

| 位号 | 原因 |
|---|---|
| AE1 | 板载 PCB 天线，无实体器件 |
| LCD1 | 定制段码 LCD 玻璃，引脚穿孔，单独装配 |
| BT1 | CR2032 电池座，插件（TH） |
| C6 | 不贴装（N.C.） |
| C13 / C14 | 不贴装（DNP，射频匹配网络预留位） |

> **注意**：板文件中 C6 / C13 / C14 三个不贴装位号**未勾选 DNP 属性**，因此 KiCad 直接导出的坐标文件仍包含它们。生产文件中的 CPL 已按上表剔除；后续若重新导出坐标文件，需同步剔除，否则会与 BOM 不一致。

## 5. 生产文件清单

<div class="keep" markdown="1">

| 类别 | 文件 | 说明 |
|---|---|---|
| **Gerber** | 11 个图层文件 + `.gbrjob` | F.Cu / In1.GND / In2.VDD / B.Cu / F.Mask / B.Mask / F.Paste / B.Paste / F.Silkscreen / B.Silkscreen / Edge.Cuts；关闭 X2 格式、采用 Protel 扩展名，丝印已做阻焊扣除 |
| **钻孔** | `-PTH.drl` / `-NPTH.drl` / `-drill.rpt` | Excellon，公制，绝对坐标；PTH 共 92 孔（0.3 / 0.8 / 1.5 mm 三把刀），NPTH 0 孔 |
| **坐标** | `CPL_SMT_智能温湿度传感器.csv` | 嘉立创格式，31 个 SMT 位号，公制，绝对坐标 |
| **BOM** | `BOM_SMT_智能温湿度传感器.csv` | 嘉立创格式，23 行，含立创商城编号；SMT 元件小计 ¥27.01（不含 LCD 玻璃与不贴件） |

</div>

**坐标系统一致性**：Gerber 与 CPL 均采用"X 为板坐标、Y 取负"的约定（U1 在两者中同为 `X 149.80 / Y −67.40`），可直接对齐，无需换算。

**贴装角度**：CPL 中的旋转角取自 KiCad 封装定义。嘉立创元件库的角度基准与 KiCad 不完全一致，下单后应在其 DFM 预览 / 贴装预览中逐个核对外形方向。

**2026-10-11 复核结果**：DFM 的元件组装分析中，**U3（C5444716，SSOP-28）的库模型摆出的姿态与板上焊盘相差 90°**，报出 20 条"PIN脚无焊盘" + 8 条"焊脚和焊盘相交区域"（接触面积仅 41%）。已从 Gerber 原件逐项核实：**CPL 角度（90°）、板文件封装朝向、丝印 1 脚标记三者自洽**（pad 1 = 135.670, −72.600；丝印 1 脚标记的三角顶点在 136.1425, −72.6375，距该焊盘中心 0.47 mm、距其外沿 0.27 mm），且同为底面 90° 家族的 U4 未报同类告警 —— 因此判断为**立创库内该料号模型默认朝向与板上封装定义不一致所致的误报**。

> **2026-10-12 确认**：该器件的贴装方向**交嘉立创在贴装审核环节确认；本工程不改版、也不修改 CPL**，另随单提交书面说明**《U3 贴装方向说明》**。完整依据与问法见《DFM 检查报告与优化记录》§3.2、§5。

### 5.1 边界类告警的处理（2026-10-12 确认）

DFM 另报出 U1 的 48 条与 L2 的 6 条引脚边界告警（自测偏差分别为 0.0000 ~ 0.0002 mm 与 25 ~ 38 µm，属库模型引脚轮廓与板上焊盘的差异）。**评审结论：首版保留现有焊盘，不改版。** 依据见《DFM 检查报告与优化记录》§3.3、§3.5。

## 6. 结论

本板按嘉立创 4 层板常规工艺**可制造**：最小线宽 0.20 mm、最小过孔 0.30 mm、成品厚 1.6 mm 均处于常规范围，叠层与其标准模板一致。全板超出常规的只有 U1 散热焊盘的盘中孔一项，其余为余量提示，不影响下单。

**下单前需向板厂确认**（其中 U1 / L2 边界告警与盘中孔工艺的取舍已于 **2026-10-12 确认**：**保留现有焊盘、不改版**；**采用盘中孔工艺、不做简化**）：

1. **4 层板盘中孔（树脂塞孔 + 电镀填平）的报价与交期**——本板唯一影响成本的工艺选项（**工艺已定，仅剩报价与交期**）；
2. **订单工艺参数须与设计一致**：表面处理**沉金**、过孔工艺**盘中孔（过孔塞树脂 + 过孔电镀盖帽）** —— **已于 2026-10-12 在下单页选定并经截图核对**（见《PCB 打样下单说明》§2）。DFM 工具内保存的旧参数快照（"有铅喷锡 + 过孔盖油"）**不再代表订单的实际选项**。**本项尚余一处待确认**：下单页"层压顺序"选的是"指定层压顺序"而非"我的文件中已有层压顺序"，须核对其所指定叠层与 `.gbrjob` 声明一致（**外层到 In1.GND 介质 0.2104 mm**，见本文 §1.2），否则射频馈线的 50 Ω 须重算（见《PCB 打样下单说明》§3.1）；
3. 0.30 mm 孔 / 0.70 mm 盘是否属常规组合，有无小孔径加价；
4. ~~I2C_SDA 走线与 R1 焊盘之间 0.101 mm 的净距能否稳定蚀刻~~ —— **本条已撤销**：该值在 2026-10-09 批次的 DFM 中无任何支撑，判断为旧值，异网络最小净距实为 **0.200 mm**（见 §2.1）。
5. **U3 贴装方向**：**已确认交嘉立创在贴装审核环节确认，本工程不改版、不改 CPL**；随单提交《U3 贴装方向说明》，请在贴装预览中核对 SSOP-28 的 1 脚（板上 pad 1 = 135.670, −72.600）后再放行（缘由见 §5"贴装角度"）；
6. **J1（立创编号 C51897894）**：DFM 报告标注 `no_package`，请确认该料号与板上封装 `PinHeader_2x05_P1.27mm_Vertical_SMD` 匹配，并完成贴装审核；
7. **U2（C2909890）中心盘**：板上采用无中心盘（`..._SHT4x_NoCentralPad`）封装，贵司库内该料号的封装为 `DFN-4-EP(1.5x1.5)`（含 EP），请确认贴装判定不受影响；
8. 扩展库料 14 项（共 23 项）的上料费，以及 **J1 库存**的交期确认。

> **2026-10-12 增补**：记录评审对三项待确认事项的结论 —— **U3 贴装方向交嘉立创在贴装审核确认（不改版、不改 CPL，另出《U3 贴装方向说明》）；U1 / L2 边界告警保留现有焊盘、不改版；U1 散热盘采用盘中孔工艺、不做简化**。同时更正一处数据：丝印 1 脚标记距 U3 pad 1 的距离由"0.53 mm"更正为**距焊盘中心 0.47 mm、距外沿 0.27 mm**（按板文件重算）。
>
> **版本说明**：本文成文于 2026-10-07，**2026-10-11 定稿**。定稿时已把下列几处更正落进正文：丝印线宽 0.12 → **0.16 mm** 并反转结论（§2、§2.3）；删除无支撑的"最小铜净距 0.101 mm"（§2.1、§6）；补上 U3 库模型朝向的复核结果（§5）；DRC 状态改为 **0 error / 0 未连接 / 34 warning（全部为封装本地覆盖）**（§1.1）；`.gbrjob` 带出的 `ImpedanceControlled: true` 已在下单说明中单独提示。
>
> **2026-10-12 下单页复核**：按下单页最新截图逐项核对工艺区，**表面处理（沉金 + 1u"）、过孔工艺（过孔塞树脂 + 过孔电镀盖帽）、铜厚（外层 1 oz / 内层 0.5 oz）、阻抗（无要求）、最小孔径档（0.3 mm）均与本文一致**；唯一差异是"层压顺序"选了"指定层压顺序"，须确认其叠层与 `.gbrjob` 声明一致（本文 §1.2、§6 第 2 项）。清单见《PCB 打样下单说明》§2。
>
> **R3 料号更正**（C17604 为 2 kΩ，已改为 C17520 `0805W8F2201T5E`，2.2 kΩ ±1% 0805）已闭环，见《DFM 检查报告与优化记录》§4。
>
> DFM 检查与整改的完整过程见**《DFM 检查报告与优化记录》**（原《DFM 整改记录》，已按交付要求重写）；下单操作见**《PCB 打样下单说明》**；文件构成见**《生产文件包清单》**。

---

**参考**：嘉立创 4 层板制造能力与盘中孔工艺说明；《本项目叠层方案_智能温湿度传感器_4层板》§1、§3.4、§3.5；《信号完整性分析》§4（射频馈线阻抗）；《热设计分析》§1.4（平均功耗）；`正式工程_方案B.kicad_pcb` 提取的几何与钻孔数据。
