hansonxiex-stack/nrf52-th-sensor-hardware/docs/wk7/LTspice电源仿真取数依据与适用性说明_智能温湿度传感器.md

# LTspice 电源仿真取数依据与适用性说明

**项目**：智能温湿度传感器（方案 B）· 四层板
**日期**：2026-10-11（第 7 周）
**复核对象**：第 2 周交付物《电源 LTspice 仿真》（`正式工程_方案B/电源ltspice仿真.docx`）与本项目第 2 周实验报告 §2.4
**仿真源文件**：`正式工程_方案B/电源仿真.asc`、仿真原始数据 `电源仿真.raw`（31 204 952 字节，600 072 点）
**目的**：说明该仿真三路负载电流的取值依据，并界定其占空比假设的适用范围

---

## 1. 结论摘要

| 问题 | 结论 |
|---|---|
| 三路负载的电流值 | **均以器件手册为依据**，其中 nRF 峰值与 SHT40 测量值属向上取整的**保守值**，不是手册原始条目 |
| 脉冲宽度 ton = 10 ms | **有依据**：覆盖 SHT40 最慢一档测量（8.3 ms），且 ≥ 70 倍放电时间常数，保证谷底走到稳态 |
| nRF 一侧的 ton 依据 | ton 由 SHT40 的 8.3 ms 确定即可覆盖 nRF 的真实突发（按 BLE 包结构与射频时序估算约 **1 ~ 2 ms**）；且 ton ≥ 1 ms 后谷底已饱和，nRF 取多长都不影响结论（见 §3.5） |
| 脉冲周期 T = 1 s / 2 s | **无手册依据**，是"随时在上报"的常发假设，属最坏一侧 |
| 占空比能否作为实际模式的参考 | **求最坏压降可以**（结果对占空比不敏感，< 1%）；**求平均电流与续航不可以**（结果由占空比直接决定，差 4 ~ 6 倍） |
| 本板真正的欠压判据 | 不是 nRF52810 的 1.7 V，而是 **HT16C21A 的 VDD 下限 2.4 V**；最差谷底 2.499 V，余量仅 **99 mV** |
| 已更正的数值 | 正文"0 dBm 发射约 7.5 mA" → **4.6 mA**。nRF52810 手册中并无 7.5 mA 这一条目（nRF52832 手册里的 7.5 mA 属 **+4 dBm** 档、且是另一颗芯片），溯源见 §2.5 |

---

## 2. 三路负载电流的取值依据

### 2.1 取值对照表

| 负载 | 仿真取值（`电源仿真.asc`） | 器件手册值 | 出处 | 判定 |
|---|---|---|---|---|
| nRF52810 睡眠 | `2u` | `ION_RAMON_RTC` **1.5 µA**（System ON、全 RAM 保持、LFRC 唤醒） | nRF52810 PS v1.0 §5.2.1.3（p.58） | 略保守 |
| nRF52810 发射峰值 | `10m` | **4.6 mA**（TX only、0 dBm、DC/DC、3 V）—— 本文取值<br>5.8 mA（同工况，场景表口径）<br>7.4 mA（CPU + 射频同时，`IS0`）<br>10.1 mA（TX only、0 dBm、LDO） | §6.14.15.2（p.314）`ITX,0dBM,DCDC`<br>§5.2.1.2（p.57）`IRADIO_TX1`<br>§5.2.1.4（p.60）`IS0`<br>§6.14.15.2（p.314）`ITX,0dBM` | 含余量的上界，构成见 §2.2 |
| SHT40 空闲 | `0.2u` | **0.08 µA** typ（25 °C）/ 1.0 µA max | SHT4x DS v7.3 §3（p.9） | 略保守 |
| SHT40 测量 | `0.6m` | 320 µA typ / **500 µA max** | 同上 p.9 | **高于手册最大值 20%**，保守上界 |
| SHT40 单次测量时长 | `10m`（ton） | `tMEAS,h` typ 6.9 ms / **max 8.3 ms** | 同上 §3.1（p.10） | 覆盖最慢一档 |
| HT16C21A（含所驱动的 LCD 玻璃） | `18u` 恒定 | `IDD` **18 µA** typ / **36 µA max** @3 V | HT16C21A DS v1.30 直流电气特性（p.7） | **取 typ，未取 max** |
| 电池内阻 | `.step param Rb list 10 30 50` | 无依据文件 | — | 假设值，见 §5 |

> HT16C21A 的 18 µA 测试条件为：VDD = 3 V、**无负载**、VLCD = VDD、1/3 bias、fLCD = 80 Hz、LCD 显示开启、内部系统振荡器开启、DA0~DA3 = "0000"。

### 2.2 nRF52810 峰值 10 mA 的构成与交叉验证

VDD 轨上看到的是**整芯片**电流，而 4.6 mA 只是射频一项。用两条互相独立的路径分别汇总：

```
路径 A（手册分项相加）                路径 B（手册复合场景）
射频 0 dBm TX（DC/DC）    4.6 mA      IS0：CPU + 射频 0 dBm TX（DC/DC）  7.4 mA
CPU CoreMark from flash   2.2 mA      状态 LED                           0.5 mA
状态 LED                  0.5 mA                                   ─────────
                        ─────────                                      7.9 mA
                           7.3 mA
```

两条路径互相印证，结果均落在 10 mA 以下，**取 10 mA 作为负载峰值，其中约含 2 ~ 3 mA 余量**，用于覆盖手册分散性、CPU 占用率波动与固件实现差异。状态 LED 的电流由网表确定：`U1 pin 38 (P0.26)` → R3（2.2 kΩ）→ D1（绿色 0805）→ GND，`I ≈ (3.0 − 1.95 V) / 2.2 kΩ ≈ 0.5 mA`——该支路贡献很小，10 mA 的余量主要给的是 CPU 与射频同时工作。

**关于 4.6 mA 与 5.8 mA 的差异**：同一颗芯片、同一工况（0 dBm 发射、DC/DC、3 V）在手册的两张表中分别给出 **4.6 mA**（§6.14.15.2 "TX only run current"）与 **5.8 mA**（§5.2.1.2 场景表），相差 1.2 mA，手册未说明差异来源。本文取 4.6 mA，与第 1、5、6 周各文档一致；该差异列入 §6 待确认项 3。

### 2.3 4.6 mA 与 5.8 mA 都是 VDD 电源电流，不是射频输出功率

两者都是**从 VDD 引脚抽取的电源电流**，与天线上的射频输出不是同一个量：

| 量 | 值 | 说明 |
|---|---|---|
| 射频输出功率 | 0 dBm = **1 mW** | 这才是"输出" |
| 若按 3 V 折算的等效输出电流 | 1 mW / 3 V ≈ **0.33 mA** | 与 4.6 mA 相差约 14 倍 |
| 功放效率 | 1 mW / (4.6 mA × 3 V = 13.8 mW) ≈ **7 %** | BLE 功放不追求效率，该量级正常 |

依据：手册 §5.2（p.55）明确说明这套场景给出的是 "the typical current **drawn from the VDD supply**"；§6.14.15.2 的条目名称为 `ITX,0dBM,DCDC — TX only run current`，单位 mA。**因此该值可以直接作为电源轨上的负载电流使用，与仿真的电流源模型口径一致。**

### 2.4 取 DC/DC 口径才与本板一致

板上 L2（10 µH，muRata LQM21FN100M80L）接在 `Net-(U1-DCC)`（U1 pin 47 ↔ DEC4，配 C11 1 µF），即 **nRF52810 的 DC/DC 电感已在 BOM 内，设计意图是启用 DC/DC**。因此手册中 DC/DC 一列的数值（4.6 / 5.8 mA）才是与本板相符的口径；LDO 一列（10.1 / 10.5 mA）只在固件未使能 DC/DC 时成立，其影响见 §4.4。

### 2.5 与其余各周口径的一致性

| 文档 | 引用的 nRF 发射电流 |
|---|---|
| 第 1 周产品需求分析 §竞品对比 | 4.6 mA（注明"Key features 条件"） |
| 第 5 周电源模块布线分析 | 4.6 mA |
| 第 6 周热设计分析、电源完整性分析、DFT 说明 | 4.62 mA（含 LCD） |
| **第 2 周实验报告与《电源 LTspice 仿真》正文（更正前）** | **7.5 mA** |

**更正**：第 2 周两处正文已由 7.5 mA 改为 **4.6 mA**，与其余各周一致，对应手册条目为 **§6.14.15.2（p.314）`ITX,0dBM,DCDC` = 4.6 mA**（wk1 另注明其同为 Key features（p.2）的口径）。同时把"负载电流值全部取自数据手册"改为"以器件数据手册为依据、部分向上取整为保守值"——因为 10 mA（nRF 峰值）与 0.6 mA（SHT40 测量）都不是手册原始条目，而是上取整值，原来的表述与事实不符。仿真输入本身未改动。

**7.5 mA 的可能来源**（供追溯，两种可能，均不成立）：

| 可能 | 对应条目 | 为什么不成立 |
|---|---|---|
| 取自 nRF52832 | §23.15.2（p.230）`ITX,PLUS4dBM,DCDC` = **7.5 mA** | 数值完全吻合，但那是 **+4 dBm** 档、且是**另一颗芯片**（本项目用的是 nRF52810） |
| 把整芯片值当作射频值 | §5.2.1.4（p.60）`IS0` = **7.4 mA**（CPU + 射频，DC/DC） | 数值接近，但该值已含 CPU，正文又"叠加 CPU"，属重复计算 |

nRF52810 在 +4 dBm（DC/DC）档的对应值是 **8 mA**（`IRADIO_TX0`，p.57），并非 7.5 mA。

---

## 3. 为什么用"周期性电流脉冲"建模

### 3.1 建模方式

三路负载（nRF52810、SHT40、HT16C21A）经各自内部稳压后取电，对 VDD 轨而言表现为**恒流性质的电流台阶**。因此在去耦电容组两端并联三个电流源，是对"负载阶跃 → 电源轨跌落"这一问题的标准等效做法，模型本身没有引入额外近似。

### 3.2 ton = 10 ms 的两个依据

去耦电容组 C = 2.2 µF + 5 × 100 nF = **2.7 µF**；最差档放电时间常数 `τ = Rb · C = 50 Ω × 2.7 µF = 135 µs`。

1. **覆盖最慢一档单次测量**：SHT40 `tMEAS,h` 手册最大值 8.3 ms < 10 ms，即 10 ms 足以覆盖传感器最长的一次测量动作；
2. **远大于放电时间常数**：10 ms = **74 τ**，保证谷底到达"稳态 I·Rb"而不是"电容尚未放完"的中间态——这两者是完全不同的两个答案。

### 3.3 实测验证

由 `电源仿真.raw` 解出的三条曲线（3 个 step 各 200 024 点，`.tran 0 2 0 10u`）：

| Rb | 空载稳态 | nRF 脉冲谷底 | 跌落深度 | SHT40 脉冲谷底 | 跌落深度 |
|---|---|---|---|---|---|
| 10 Ω | 2.9998 V | **2.8998 V** | 100.0 mV | 2.9938 V | 6.0 mV |
| 30 Ω | 2.9994 V | **2.6995 V** | 299.9 mV | 2.9814 V | 18.0 mV |
| 50 Ω | 2.9990 V | **2.4991 V** | 499.9 mV | 2.9690 V | 30.0 mV |

三条互相独立的证据说明**谷底由电池内阻单独决定，与电容、与 ton 取多长都无关**：

1. **深度 = I × Rb 精确成立**：10 mA × 50 Ω = 500.0 mV（实测 499.9）、0.6 mA × 50 Ω = 30.0 mV（实测 30.0）；
2. **谷底到达时刻 ≈ 15 τ**：脉冲始于 0.2 s，谷底出现在 0.20212 s（Rb = 50 Ω，2.12 ms = 15.7 τ）、0.20116 s（Rb = 30 Ω，14.3 τ）、0.20039 s（Rb = 10 Ω，14.4 τ），之后约 8 ms 一直停在谷底——**ton 的后 80% 并未被"用上"，是刻意留的余量**；
3. **空载稳态电压自洽**：3.0 V − 20 µA × Rb → 2.9998 / 2.9994 / 2.9990 V，与 Rb 三档及 20 µA（18 µA HT16C21A + 2 µA nRF 睡眠）完全对应。

### 3.4 T = 1 s / 2 s 的性质

脉冲周期 1 s（nRF）与 2 s（SHT40）**不是任何规格书的条目**，取自产品需求中"大广播间隔"的量级（第 1 周需求分析对方案 A 记为"如 10–60 s"）并取更靠保守的一端。两路负载另设 0.2 s / 0.3 s 的 Tdelay 使其错开，仅为了让凹口在波形上可分辨；这一处理同时回避了"发射与测量同时发生"的更坏情形，其量级见 §4.4。

### 3.5 nRF 一侧的突发时长依据

ton = 10 ms 的直接依据来自 SHT40（三路负载中唯一有手册规定"单次动作时长"的一项）。**nRF 的突发时长不是器件参数，而是协议参数**——由 BLE 包长与广播/连接参数决定，属固件范畴，手册中没有对应条目。因此对 nRF 只能给出上界估算，并证明该上界不影响结论。

**上界估算**（按 BLE 1 Mbps 包结构与手册射频时序推算，1 Mbps 下 1 bit = 1 µs）：

```
单包空中时间 = (前导 1 + 接入地址 4 + 头 2 + 载荷 ≤37 + CRC 3) 字节 × 8 bit × 1 µs
             = 47 字节 = 376 µs
射频建立     tTXEN 140 µs（兼容模式）/ tTXEN,FAST 40 µs（快速模式）   §6.14.15.8（p.317）
信道切换     tSWITCH 20 µs                                          §6.14.15.8（p.318）
广播事件     3 个信道 ×（376 µs + 包间 T_IFS 150 µs）≈ 1.6 ms
```

即 nRF 的真实一次活动（含射频建立与三个广播信道）约 **1 ~ 2 ms**，比模型取的 10 ms **小一个数量级**。

**饱和性证明**（为什么 nRF 取多长都不影响结论）：谷底电压只有在 ton ≫ τ 时才达到稳态 `I·Rb`，而 10 ms = 74 τ，已经深度饱和。

| nRF 实际突发 | 与模型 ton = 10 ms 的关系 | 对谷底的影响 |
|---|---|---|
| 1 ~ 2 ms（按上界估算） | 短于模型 | 仍 > 7 τ，**谷底完全相同** |
| 200 µs（极端短突发） | 远短于模型 | 谷底浅 23 %（2.499 → 2.613 V），**模型偏保守，不会低估跌落** |
| ≥ 10 ms（固件长时间高速运行） | 长于模型 | **谷底不可能超过 `I·Rb`，答案不变** |

**结论：谷底对 ton 在 ≥ 1 ms 以上完全不敏感，因此无须为 nRF 定出准确的突发时长。** 以 SHT40 的 8.3 ms（各负载中手册规定的单次动作时长最大值）确定 ton，同时满足"覆盖最长动作"与"进入饱和"两条要求。

**代价**：ton 对**平均电流/续航**是有影响的（`D = ton / T`）。若 nRF 的实际突发按 1 ~ 2 ms 计，1 s 周期下它的平均贡献由 10 mA × 1 % = 100 µA 降至 10 ~ 20 µA。这也说明 §4.2 的平均电流必须由固件上报周期决定，而不能沿用本仿真的 ton。

---

## 4. 占空比的适用性

### 4.1 求最坏压降：可用，且结果对占空比不敏感

谷底电压 `V_min = 3.0 V − I_peak · Rb`，**与占空比无关**，只要求 ton ≫ τ 且 T ≫ τ（脉冲之间完全恢复、不叠加）。1 s / 2 s 的周期远大于 135 µs，满足该条件。

按 RC 放电 `ΔV = I · Rb · (1 − e^(−ton/τ))` 重算 Rb = 50 Ω 档：

| 假设的 ton | 跌落深度 | 谷底电压 | 与仿真取值之差 |
|---|---|---|---|
| **10 ms（仿真取值）** | 500.0 mV | **2.499 V** | — |
| 1 ms（真实 BLE 一次发射活动的量级） | 499.7 mV | 2.499 V | < 1 mV |
| 200 µs（极短突发） | 386.3 mV | 2.613 V | ＋114 mV |

即 **ton 从 10 ms 缩到 1 ms，结论一位小数都不变**；即使缩到 200 µs，谷底也只浅 23%。而 T 取 1 s 比任何合理的上报间隔都短。**因此以该占空比求得的压降结论是偏保守的、可用的。**

### 4.2 求平均电流与续航：不可用

平均电流完全由占空比决定，而占空比由**固件上报周期**决定。本项目目前没有固件，周期也未在任何文档中定过，因此该仿真不能直接给出续航结论。

`I_avg = I_睡眠 + I_HT + D_nRF · I_发射 + D_SHT · I_测量`

按手册值（nRF 发射 8 mA = 4.6 射频 + CPU、睡眠 1.5 µA、SHT40 idle 0.08 µA、测量 320 µA、HT16C21A 18 µA），CR2032 按 220 mAh 估算：

| 上报周期 | 占空比 | I_avg | 续航 | 对第 1 周"≤ 80 µA"预算 |
|---|---|---|---|---|
| **1 s / 2 s（仿真自用）** | 1 % / 0.5 % | **123 µA** | **≈ 75 天** | ❌ **超出 54 %** |
| 10 s | 0.1 % / 0.05 % | 28.6 µA | ≈ 320 天 | ✅ |
| **60 s（需求给出的量级）** | 0.017 % | **21.0 µA** | **≈ 1.2 年** | ✅ |

（若直接采用仿真自身的电流值 10 mA / 0.6 mA / 2 µA / 0.2 µA / 18 µA，1 s 档的 I_avg 为 123.2 µA，与本表同量级。）

**要点：占空比把续航挪动了 4 ~ 6 倍，却几乎不挪动 V_min（< 1 %）。两个用途必须分开，仿真的占空比只能用于前者。**

低占空比下还出现一个结构性事实：60 s 档的 21 µA 中有 18 µA 来自 HT16C21A，占 **86 %**。**即决定本机续航的不是蓝牙发射，而是 LCD 驱动器的静态电流**；若按手册最大值 36 µA 计，该项翻倍，续航降至约 235 天。

### 4.3 本板真正的欠压判据

第 2 周报告以 nRF52810 的 **1.7 V** 为欠压判据。该判据本身正确（nRF52810 的 VDD 工作范围 1.7 ~ 3.6 V），回答的是"会不会触发 nRF 欠压复位"这一问题；但整机还有一个**更紧**的约束：

**HT16C21A 的 VDD 工作范围为 2.4 ~ 5.5 V**，本板 VLCD 直接取 VDD，因此 LCD 驱动器是全板对电压最敏感的一颗。

| 判据 | 下限 | 最差谷底 | 余量 |
|---|---|---|---|
| nRF52810 VDD | 1.7 V | 2.499 V | **0.80 V** |
| **HT16C21A VDD** | **2.4 V** | **2.499 V** | **0.10 V（99 mV）** |

反推电池内阻的边界：`Rb < (3.0 − 2.4) / 10 mA ≈ **60 Ω**`，超过该值即把 LCD 驱动器拉出规格（按 1.7 V 反推则是 130 Ω）。**60 Ω 才是本供电链真正的内阻边界。**

### 4.4 两项敏感性

| 情形 | 峰值 | Rb = 50 Ω 时谷底 | 与 HT16C21A 的 2.4 V 关系 |
|---|---|---|---|
| 固件启用 DC/DC（设计意图） | ≈ 7.3 mA | 2.499 V | 余量 99 mV |
| **固件未启用 DC/DC**（LDO：射频 10.5 mA + CPU 4.2 mA + LED 0.5 mA） | ≈ 15.2 mA | **≈ 2.24 V** | **跌破 2.4 V** |
| 发射与 SHT40 测量同时发生 | 10.6 mA | 2.469 V | 余量 69 mV |

因此"启用 DC/DC"不只是省电问题，它同时是保住 LCD 驱动器工作电压的条件之一；而 1 s / 2 s 错开激励的处理，对压降结论的乐观程度约为 30 mV。

---

## 5. 模型省略项与假设值

### 5.1 省略的高频元件

模型未含电容 ESR/ESL、电池电感与走线电感。量级估算如下：

| 项 | 估算 | 影响 |
|---|---|---|
| 0402 100 nF（X7R）ESR 取 50 mΩ | 10 mA × 50 mΩ | 0.5 mV |
| 0805 2.2 µF ESR 取 5 mΩ | 10 mA × 5 mΩ | 0.05 mV |
| 走线/回路电感取 20 nH | 20 nH × 10 mA / 1 µs | 0.2 mV |

合计 **< 1 mV**，相对 499.9 mV 的跌落可忽略，故省略项不影响结论；但该结论以"上升时间 1 µs"为前提，若实际 di/dt 高一个数量级，应按上式重估。

### 5.2 假设值（无依据文件）

| 假设 | 取值 | 说明 |
|---|---|---|
| 电池内阻三档 | 10 / 30 / 50 Ω | 对应新 / 半新 / 快没电；**本项目资料中没有 CR2032 手册**，三档为假设值。内阻随放电深度与温度上升，低温或接近终止电压时可能远高于 50 Ω |
| CR2032 容量 | 220 mAh | 通用标称值，同样无依据文件；§4.2 的续航数字随该值线性变化 |
| 自放电 | 未建模 | 通用值约每年 1 ~ 2 %，会进一步拉低续航 |

---

## 6. 待确认事项

| # | 事项 | 需要谁定 |
|---|---|---|
| 1 | **固件上报周期**（10 s？60 s？）——这是把"占空比假设"变成"实际工作模式"的唯一输入，也是判定能否满足 ≤ 80 µA 预算与续航目标的前提 | 评审 / 固件侧 |
| 2 | **欠压判据取哪一个**：nRF52810 的 1.7 V，还是 HT16C21A 的 2.4 V。后者会把结论从"余量 0.8 V"改为"余量 99 mV、内阻边界 60 Ω"，性质不同 | 评审 |
| 3 | **nRF 发射电流的口径统一**：同一工况（0 dBm、DC/DC、3 V）手册给出 4.6 mA（§6.14.15.2，TX only）与 5.8 mA（§5.2.1.2，场景表）两值；整芯片（含 CPU）为 7.4 mA（`IS0`，p.60）；LDO 档为 10.1 mA。第 5、6 周的热设计与电源完整性分析把 **4.6 mA（纯射频）当作整芯片电流**使用，只相当于 `IS0` 的 62 %，**偏小约 38 %**，需明确统一按哪一档
| 4 | **CR2032 的具体型号与手册**（内阻—放电深度曲线、容量、低温特性），据以替换 §5.2 的假设值 | 器件选型 |
| 5 | 是否把 §4.3 的 2.4 V 判据与 §4.2 的占空比适用范围**回写进第 2 周报告正文**（本次只做了数值更正，未改动结论文字） | 评审 |

---

## 7. 数据来源

| 来源 | 用途 |
|---|---|
| `数据手册/Nordic_nRF52810_PS.pdf` v1.0 | §5.2 场景说明"drawn from the VDD supply"（p.55）、§5.2.1.1 CPU 电流（p.56）、§5.2.1.2 射频电流表（p.57）、§5.2.1.3 睡眠电流（p.58）、§5.2.1.4 复合场景 `IS0`（p.60）、§6.14.15.2 发射/接收电流（p.314）、§6.14.15.8 射频时序（p.317–318）、Key features（p.2） |
| `数据手册/Nordic_nRF52832_PS.pdf` | §23.15.2 发射电流（p.230）——仅用于 §2.5 中 7.5 mA 的溯源 |
| `数据手册/Sensirion_SHT4x_Datasheet.pdf` v7.3 | §3 电源特性表（p.9）、§3.1 Timings 测量时长（p.10） |
| `数据手册/simHT16C21Av130.pdf` | 直流电气特性表（p.7） |
| `正式工程_方案B/电源仿真.asc` | 仿真输入（负载电流、ton、T、`.step`、`.tran`） |
| `正式工程_方案B/电源仿真.raw` | §3.3 实测谷底与深度、谷底到达时刻 |
| `正式工程_方案B/正式工程_方案B.net` | §2.2 LED 支路（U1 pin38 → R3 2.2 kΩ → D1）、§2.3 DC/DC 电感 L2（DCC ↔ DEC4） |
| `wk1/产品需求分析报告.md` §5 | 整机平均电流 ≤ 80 µA、显示驱动器 ≤ 60 µA、续航 3 ~ 10 个月、广播间隔 10 – 60 s |

---

**相关文档**：《DFM 检查报告与优化记录》《DFM 可制造性设计说明》《PCB 打样下单说明》《BOM 清单与工艺说明》《生产文件包清单》。
