hansonxiex-stack/nrf52-th-sensor-hardware/docs/wk7/U3贴装方向说明_智能温湿度传感器.md

# U3 贴装方向说明

**（提交嘉立创 SMT 贴装审核用）**

**项目**：智能温湿度传感器（方案 B）· 四层板
**日期**：2026-10-12
**涉及位号**：U3（立创编号 **C5444716**，HOLTEK HT16C21A-28SSOP，SSOP-28，**底面**）
**对应提交文件**：`Gerber_2026-10-09.zip`、`CPL_SMT_智能温湿度传感器.csv`、`BOM_SMT_智能温湿度传感器.csv`

> **结论**：本工程板上设计与 CPL 文件均正确，**不做任何修改**。本说明用于说明贵司 DFM 对 U3 报出的 30 条元件组装类危险项的成因，并请贵司在**贴装审核**环节确认本器件的贴装方向。

---

## 1. 位号信息

| 项 | 值 |
|---|---|
| 位号 / 立创编号 | U3 / **C5444716**（HOLTEK HT16C21A-28SSOP）|
| 封装 | SSOP-28，脚距 **0.635 mm**，跨度 **8.255 mm** |
| 贴装面 | **Bottom（底面）** |
| CPL 坐标 | **(131.5425, −70.000) mm** |
| CPL 旋转角 | **90°** |
| **板上 pad 1 位置** | **(135.670, −72.600) mm**，焊盘 **0.40 × 1.20 mm** |
| 板上焊盘排布 | 两排，沿 X 方向，Y = **−67.400 / −72.600**（排距 5.20 mm），每排 14 个 |
| 丝印 1 脚标记 | 一个指向 pad 1 的小实心三角，顶点 **(136.1425, −72.6375)**，距 pad 1 中心 0.47 mm、距其外沿 0.27 mm |

---

## 2. 情况说明

贵司 DFM 的"元件组装分析"对本位号报出 **30 条危险项**，明细如下：

| 检查项 | 条数 |
|---|---|
| PIN脚无焊盘 | 20 |
| 焊脚和焊盘相交区域（接触面积比均为 0.41） | 8 |
| 元件焊脚到孔的距离 | 2 |

**成因**：贵司库内 C5444716 的封装模型默认朝向，与本工程板上封装的朝向**相差 90°**。按本工程 CPL 的 90° 将模型叠加到 Gerber 上后，模型呈"两列沿 Y 排列"，而板上焊盘是"两排沿 X 排列"：

| | 排列方向 | 排 / 列间距 | 脚距 | 跨度 |
|---|---|---|---|---|
| **板上实际焊盘**（Gerber 实测） | 两排，**沿 X** | Y = −67.400 / −72.600，**5.20 mm** | 0.635 mm | 8.255 mm |
| **DFM 模型摆出的引脚** | 两列，**沿 Y** | X = 128.958 / 134.127，**5.169 mm** | 0.635 mm | 8.255 mm |

脚距、跨度、间距三项完全一致，**只有方向互相垂直**——即整体相差 90°，且只有 90° 能同时满足这三个数。模型共 28 个脚，其中 8 个落在焊盘上（两列 × 两排的交集），其余 20 个落在焊盘之外，与 DFM 报出的 20 + 8 = 28 正好吻合。

**本工程侧的三条佐证**：

1. **板上 1 脚位置自洽**：CPL 角度（90°）、板文件封装朝向、丝印 1 脚标记三者一致——丝印那个指向 pad 1 的小三角，顶点就在 pad 1（135.670, −72.600）右侧 0.47 mm 处；
2. **同类元件不再报警**：同为底面、CPL 写 −90° 的 **U4**（SOT-23-6）以及 U1、U2、L2 均未报出此类危险项 —— 说明 DFM 对其它元件是正确应用 CPL 旋转角的，问题只出现在 C5444716 这一个料号的库模型上；
3. **8 条"相交区域"的接触面积比全部为 0.41**：若是任意角度歪斜，各脚的接触比会有大有小；这里整齐划一，说明是**整齐的 90° 旋转**。

图 1 U3 的库模型与板上焊盘叠合（光标停在模型引脚上，右下角坐标读数 128.953, −74.113）

图 2 U3 的"焊脚和焊盘相交区域"明细：8 条，接触面积比均为 0.41

---

## 3. 请求事项

1. 请确认贵司库内 **C5444716** 的默认朝向，并在**贴装审核**环节按板上焊盘的实际朝向（即本工程 CPL 的 **90°**）确认本器件的贴装方向，使 **1 脚落在板上名为 pad 1 的焊盘（135.670, −72.600）**上；
2. 本工程**不修改 PCB 设计，也不修改 CPL 的旋转角**（CPL 中的 90° 即板上实际朝向）。若该料号在贵司贴装流程中需要按库内模型做角度补偿，请按贵司内部规则处理；
3. 若审核认为仍需设计方调整贴装数据，请书面告知需要调整的角度，与本工程确认后再处理。

---

## 4. 可直接粘贴至订单备注的短文本

> 位号 U3（立创编号 C5444716，SSOP-28，底面）在贵司 DFM 中报出 30 条元件组装危险项。经核对，成因为贵司库内该料号的封装模型默认朝向与本工程板上封装相差 90°。本工程 CPL 中该位号角度 90° 正确，板上 1 脚焊盘坐标为 (135.670, −72.600)，丝印 1 脚标记紧邻该焊盘。请贵司在贴装审核时确认并保证 1 脚落在该焊盘上。本工程不改板、不改 CPL，详细说明见附件《U3 贴装方向说明》。

---

**相关文档**：《DFM 检查报告与优化记录》§3.2、§5.1；《DFM 可制造性设计说明》§5"贴装角度"；《PCB 打样下单说明》§6。
