hansonxiex-stack/nrf52-th-sensor-hardware/docs/wk7/第7周实验报告_智能温湿度传感器.md

# 开源智能温湿度传感器 Pro PCB 设计——第 7 周实验报告

> 姓名：谢天成
> 项目周期：第 7 周（2026.10.05—2026.10.11）
> 本周阶段：DRC 复验 → 嘉立创 DFM 全量提交与整改 → 生产文件包定稿

---

## 1. 本周目标

按《项目理解与个人 8 周计划》，第 7 周的实践轨是「DRC → SI/PI/热/DFT → 嘉立创 DFM → Gerber/钢网/坐标 → 最终 BOM」，里程碑为「**DRC 0 error + 生产文件包**」；理论轨为**反射/串扰机理 · PI 分析 · 制造工艺 · DFM/DFT · IPC**。

承接第 6 周顺延下来的四项：

1. **两份分析报告定稿**——《热设计分析》《DFT 可测试性设计说明》改到与其余三份一致的口径。
2. **输出生产文件包**——Gerber / 钻孔 / 钢网 / CPL / 最终 BOM，并逐项核对一致性。
3. **提交嘉立创 DFM 并完成整改**——本周新增的一项，也是本周工作量最大的一块。
4. **核定下单工艺参数**，把打样订单推到最后一步。

## 2. 本周完成情况

### 2.1 里程碑达成：DRC 0 error + 生产文件包 ★

| DRC 项 | 结果 |
|---|---|
| error | **0** |
| 未连接 | **0** |
| warning | 34（**全部为 `lib_footprint_mismatch`**） |

34 条 warning 的来源不是设计缺陷，而是本周丝印整改（§2.2）把元件外框线宽由 0.12 mm 加粗到 0.16 mm —— 每个封装因此都与 KiCad 库里的副本不一致。**属预期结果，不进制造数据**；其中 U2 / AE1 / U3 三个器件**禁止执行"从库中更新封装"**（U2 最危险：从库更新会静默删掉四层热隔离 keepout，且不产生任何额外告警）。

**生产文件包定稿**（`正式工程_方案B/生产文件_20261009/`）：

| 类别 | 内容 |
|---|---|
| Gerber | 11 个图层 + `.gbrjob`（RS-274X，关 X2，Protel 扩展名，丝印已做阻焊扣除） |
| 钻孔 | PTH 92 孔（0.3 / 0.8 / 1.5 mm 三把刀），NPTH 0 孔 |
| 钢网 | 直接由 `F_Paste` + `B_Paste` 开制，双面，厚 0.12 mm |
| 坐标 CPL | 31 个贴装位号，公制绝对坐标，Y 取负 |
| BOM | 23 行，含立创编号 |
| 制板说明 | 随 Gerber 同批提交 |

一致性核对 8 项全部通过：板框 48.25 × 40.05 mm、层数 4、坐标系一致、元件数 37 = CPL 31 + 不贴 6、孔数 92 = `drill.rpt` 92、U3 朝向（板文件 90°/B.Cu = CPL 90.0°/Bottom）。

### 2.2 嘉立创 DFM 全量提交与整改 ★

**提交内容**：Gerber + 钻孔 + CPL + BOM **全量提交**，让 DFM 在"板 + 件"两层一起过一遍。

**PCB 四层分析结果**：

| 分析层 | 危险 | 警告 | 处理 |
|---|---|---|---|
| 线路层 | **0** | 少量（同网络） | 无需处理 |
| 阻焊层 | **0** | 1 | 0.125 mm 高于板厂 0.09 mm 下限，不处理 |
| 丝印层 | **0** | 36 | 已整改（109 条危险清零） |
| 钻孔层 | **0** | 0 | — |

**丝印整改是本周唯一改动过 PCB 图形的一项**：上一版 DFM 报丝印 **109 条危险**（丝印距孔 46、丝印距焊盘 63），另有线宽警告 69 条（0.12 mm 低于 0.15 mm 下限）。整改方式是把元件外框线宽 0.12 → **0.16 mm**，并重排位号避让焊盘与过孔：

| 检查项 | 整改前 | 整改后 |
|---|---|---|
| 丝印距孔 | 危险 **46** | 危险 **0** / 警告 23 |
| 丝印距焊盘 | 危险 **63** | 危险 **0** / 警告 13 |
| 丝印线条宽度 | 警告 69 | 全部达标（实测 0.1599 ~ 0.1600 mm） |

**过孔挪位**：另有两类过孔与焊盘/过孔过近的问题，由 DFM 逐条定位后挪位——12 处"焊盘—过孔"最小间距 **0.013 → 0.150 mm**；1 处两孔间距 **0.061 → 0.418 mm**。孔离焊盘过近时，回流焊的焊料会沿孔壁虹吸流失，属必须改。

### 2.3 元件组装（SMT）侧 96 条危险的分类与定位

DFM 的元件组装分析报出 **96 条危险 + 2 条警告**。这些**不是**板上缺铜，逐条溯源后的分布是：

截图 1 元件组装分析总览：各检查项的危险 / 警告 / 良好条数

| 来源 | 条数 | 定位结论 |
|---|---|---|
| U3 库模型朝向与板上焊盘相差 90° | **30**（20 无焊盘 + 8 相交区域 + 2 焊脚到孔） | 立创库模型朝向问题，**不改板**（§2.4） |
| U1 散热盘盘中孔（设计意图） | **10**（9 焊脚到孔 + 1 相交区域） | 散热盘的 9 个盘中孔被计入，属设计意图（§2.5） |
| U1 引脚边界轮廓差异 | **48**（左 26 + 右 22） | 自测偏差 **0.0000 ~ 0.0002 mm**，属"零余量"提示（§3.1） |
| L2 引脚边界轮廓差异 | **6**（左 2 + 右 2 + 内 2） | 自测偏差 **25 ~ 38 µm**，库模型引脚轮廓略大于板上焊盘 |
| U2 中心盘（板上本无此盘） | **1** | 板上用无中心盘封装，立创库匹配的是带 EP 的 `DFN-4-EP(1.5x1.5)` |
| 同网络铜重叠 | **1** | GND 过孔盘与 C7 pad 1（同为 GND），允许 |

**板上焊盘的数量、尺寸、间距已逐个数 Gerber 闪光核对**：U1 48 个侧焊盘（0.20 × 0.80 mm）+ 4.6 × 4.6 散热盘、U3 28 个（0.40 × 1.20 mm）、U2 4 个、L2 2 个 —— **数量、尺寸、间距均与设计一致，边界类警报不由"缺铜"引起**。

### 2.4 U3 贴装方向：本周最值得记的一条 ★

截图 2 U3 的库模型与板上焊盘叠合：光标停在模型引脚上

DFM 报 U3 有 20 条"PIN脚无焊盘" + 8 条"焊脚和焊盘相交区域"（接触面积比全为 **0.41**）。**结论先行：这不是"封装没被识别"。** DFM 不读 `.kicad_pcb`，其依据是 BOM 里的立创编号 **C5444716**，从立创库调 SSOP-28 模型，再按 CPL 的 (131.5425, −70.000) / 90° / Bottom 叠到 Gerber 上比对——**封装尺寸与脚间距都对得上，仅整体朝向差 90°**。

两组位置换算到同一坐标系后：

| | 排列方向 | 间距 | 单脚间距 | 跨度 |
|---|---|---|---|---|
| **板上实际焊盘**（Gerber 实测） | 两排，**沿 X** | Y = −67.400 / −72.600，**5.20 mm** | 0.635 mm | 8.255 mm |
| **DFM 模型摆出的引脚** | 两列，**沿 Y** | X = **128.958 / 134.127**，**5.169 mm** | 0.635 mm | 8.255 mm |

**间距、单脚间距、跨度三项完全一致，只有方向互相垂直**——只有 90° 能同时满足这三个数。两条互相独立的定量证据：

1. **接触面积比 0.41**——落在焊盘上的那 8 个脚，每个只有 41% 的焊接面积压在焊盘上，且 8 条**全是 0.41**。若是任意角度歪斜，各脚接触比会有大有小；整齐划一说明是**规整的 90° 旋转**。
2. **20 + 8 = 28**——模型共 28 个脚，"无焊盘"20 条 + "相交区域"8 条**正好穷尽**。按位置求交集（2 排 × 2 列 = 8）与报告完全一致。

**为什么只有 U3 暴露**：同为底面、同为 90° 家族的 **U4**（SOT-23-6，CPL 写 −90°）**没有这类告警**。若 DFM 不应用旋转，U4 的 6 颗脚会整个错开、必然报红——它没报，说明 **DFM 对别的元件是会正确应用 CPL 旋转角的**。问题出在 C5444716 这一个料号在立创库里的模型默认朝向。

**板上设计本身自洽**，两点已从 Gerber 原件核实：CPL 里 U3 写 90°、板文件里 U3 也是 90°；板上 U3 的 pad 1 = (135.670, −72.600)，其右侧就是 `B_Silkscreen.gbo` 里指向该焊盘的小实心三角，顶点 (136.1425, −72.6375)，距焊盘中心 0.47 mm。**焊盘编号、焊盘位置、丝印标记三者自洽。**

> **处理：不改版、不修改 CPL**，另出一份《U3 贴装方向说明》随单提交，请嘉立创在贴装审核环节确认。CPL 里的 90° 反映的就是板上实际朝向。

### 2.5 盘中孔：确认采用 POFV 工艺

U1（nRF52810，QFN-48）的散热焊盘 pad 49 为 4.6 × 4.6 mm、网络 GND，内部 9 个 0.30 mm 过孔（3 × 3）——设计上属**盘中孔**。风险是回流时锡膏被敞口过孔吸走：钢网锡膏体积 ≈ 1.66 mm³、9 孔内容积 ≈ 1.02 mm³，**约 60% 的锡膏可能流失**，散热焊盘焊点会出现空洞。

**处理：采用盘中孔工艺（树脂塞孔 + 电镀填平，IPC-4761 Type VII / POFV），不做简化。** 下单页对应"阻焊覆盖 = 过孔塞树脂 + 过孔电镀盖帽"；**4 层板的该工艺为收费项**（嘉立创仅对 6 层及以上免费）；其余 56 个过孔不涉及盘中孔，按标配的免费"过孔塞油"处理即可。表面处理保留**沉金**——U1 为 0.4 mm 间距 QFN，喷锡的锡面不平整度在该间距下会带来立碑与连锡风险。

### 2.6 下单工艺参数逐项核定

按下单页的填写顺序逐项核定了工艺参数，并留存订单页截图作为凭证：

| 项 | 选定 | 说明 |
|---|---|---|
| 板材 / 层数 / 尺寸 / 数量 | FR-4 / 4 层 / 4.82 × 4 CM / 5 片 | 板厚 1.6 mm 标准档 |
| 外层 / 内层铜厚 | 1 oz / 0.5 oz | 与叠层一致 |
| **阻焊覆盖** | **过孔塞树脂 + 过孔电镀盖帽** | 即盘中孔工艺（§2.5） |
| 表面处理 | **沉金**（厚度 1u"） | §2.5 |
| 需要阻抗 | 无要求（免费） | 见下 |
| 确认生产稿 | 需要 | 投产前最后一次核对 CAM |
| **层压顺序** | 指定层压顺序 | **待确认**：须与 `.gbrjob` 声明的叠层一致（§3.2） |

**关于阻抗**：`.gbrjob` 带出 `ImpedanceControlled: true`，这是 KiCad 对"本板含阻抗控制走线"的声明，不是"要求板厂测试"。本板只有一条射频馈线（0.36 mm，F.Cu，参考 In1 地平面，介质 0.2104 mm，目标 50 Ω），《制板说明》已写明"叠层未变更时无需另行调整"。**首版按"无要求"下**；实测天线不理想时，改版或二版再选 ±10% 管控。

### 2.7 BOM 料号更正：R3 由 2 kΩ 改为 2.2 kΩ

BOM 的 Comment 写 `2.2k`，但原料号 **C17604** 在嘉立创 BOM 合并数据里匹配到的是 **2 kΩ**（型号 `0805W8F2001T5E`）。确认设计阻值就是 2.2 k 后改为 **C17520**（`0805W8F2201T5E`，2.2 kΩ ±1% 125 mW，UNI-ROYAL 厚声）。同厂、同系列、同为 0805 ±1%，仅阻值不同，**合计金额不变（28.36 元）**。重新上传 BOM 后合并数据已正确匹配；其余 22 个料号的值与封装逐条核对，无其它不一致。

### 2.8 三处文档数据勘误

| 文档 | 原文 | 核对结果 |
|---|---|---|
| `制板说明.txt` §六 | 元件外框线宽 0.12 mm（低于 0.15 mm 下限） | 已改为 **0.16 mm**，结论反转 |
| `制板说明.txt` §二 | 最小焊盘—过孔 0.125 mm（3 处） | DFM 实测最小 **0.150 mm**（2 处），已按实测更正 |
| 《DFM 可制造性设计说明》§2.1 | 最小铜净距 0.101 mm（I2C_SDA 与 R1 pad 1） | **该值在 2026-10-09 批次的 DFM 中找不到任何支撑**，判断为 10-08 移动过孔之前的旧值，**已删除**，向板厂点明该位置的建议一并撤销 |

> 第三条值得记一笔：若真有 0.101 mm 的**异网络**间距，DFM 会判"危险"、DRC 也会报错，而两者都没有——**用两个独立的检查工具交叉验证一个数字，比反复复算它更有用**。异网络最小铜净距实为 **0.200 mm**，与设计规则一致。

### 2.9 LTspice 电源仿真的取数依据复核

第 2 周的电源仿真是早期交付物，本周回头把它的**取数依据**逐条溯源，成果是《LTspice 电源仿真取数依据与适用性说明》：

- 三路负载电流**均有手册依据**；其中 nRF 峰值与 SHT40 测量值取的是向上取整的**保守值**。
- **更正一处数值**：正文"0 dBm 发射约 7.5 mA" → **4.6 mA**（nRF52810 手册中并无 7.5 mA 这一条目；7.5 mA 出自 nRF52832 手册的 +4 dBm 档，是另一颗芯片）。
- **脉冲周期 T = 1 s / 2 s 无手册依据**，是"随时在上报"的常发假设。**该占空比假设求最坏压降可以用（结果对占空比不敏感，< 1%），求平均电流与续航不可以用（结果由占空比直接决定，差 4 ~ 6 倍）**——这条适用范围已写进文档标题。
- **本板真正的欠压判据不是 nRF52810 的 1.7 V，而是 HT16C21A 的 VDD 下限 2.4 V**；最差谷底 2.499 V，余量仅 **99 mV**。这解释了为什么电量耗尽的先兆是 **LCD 先显示异常**。

### 2.10 变更记录表更新至第 7 周

补入 7-1 ~ 7-8，涵盖过孔挪位（12 处 + 1 处）、丝印线宽与位号重排、R3 料号更正、DRC 状态、生产文件包定稿、三处文档数字勘误。

> **7-1 ~ 7-3 只移动过孔与丝印，元件位置与布线拓扑未改变**；PCB 已重跑 DRC 与 DFM 复验通过。

## 3. 本周遇到的问题及处理

### 3.1 "边界告警"到底要不要改

DFM 报 U1 的 48 条 + L2 的 6 条引脚边界告警，字面上像"封装尺寸不符"。查明细后是两个不同的量级：

| 器件 | 条数 | 自测偏差 | 判定 |
|---|---|---|---|
| U1 | 48（左 26 + 右 22） | **0.0000 ~ 0.0002 mm**（界面"值"列直接显示 `0mm`） | 模型引脚外沿与板上焊盘外沿**重合**，"零余量"提示，非尺寸不符 |
| L2 | 6（左 2 + 右 2 + 内 2） | **25 ~ 38 µm** | 立创库 0805 引脚轮廓比板上焊盘大约 0.05 ~ 0.075 mm |

**处理：首版保留现有焊盘、不改版。** 放行依据若成文，建议表述为"DFM 自测偏差 ≈ 0"，**不宜**表述为"焊盘符合 Nordic 推荐"——因为 DFM 标注的锚点坐标与板上焊盘外沿仍相差 0.05 ~ 0.15 mm，其引脚轮廓与板上焊盘并非同一套几何。

### 3.2 层压顺序：取叠层的方式与建议不同

下单页必填项已满足，但选的是 **「指定层压顺序」**，而建议选 **「我的文件中已有层压顺序」**——上传包里的 `.gbrjob` 已完整声明 4 层、板厚 1.6062 mm 与逐层介质（prepreg 0.2104 mm / εr 4.4，core 1.065 mm / εr 4.5），板厂按它排层即可，少一处人工出错点。

**必须确认的一点**：所指定的叠层要与文件一致，其中最关键的是**外层到 In1.GND 的介质厚度 0.2104 mm**——射频馈线的 50 Ω 就是按该厚度与 εr 4.4 算的，**叠层一变，阻抗必须重算**。此项留待下单前确认。

### 3.3 丝印整改的反直觉结果

线宽由 0.12 → 0.16 mm 后，丝印"危险"从 109 条清零，但**"警告"档反而从 0 增到 36 条**（最紧 0.131 mm）。原因是线条变粗后，线与焊盘/孔的净距随之变小。

**结论：只看危险档的增减会误判整改效果。** 丝印属工艺标识、不影响电气性能，危险清零即达标；加粗是为了满足板厂 0.15 mm 的**最细线宽**下限，这个下限不能靠"少画细线"绕开。

### 3.4 DFM 导出数据比界面少条目

本次 `dfm.json` 导出在"元件距元件""丝印距焊盘"两项上比 DFM 界面少 6 条与 32 条（界面为 60 / 122）。

**处理：对外引用一律以界面显示为准**，导出数据只用于定位单条的实测值与坐标。

## 4. 当前进度评估

| 第 7 周里程碑 | 状态 |
|---|---|
| **DRC 0 error + 生产文件包** | ✅ **已达成**（0 error / 0 未连接 / 34 warning；文件包定稿并逐项核对） |

**本周完成**：

- DRC 复验：0 error / 0 未连接
- 嘉立创 DFM 全量提交与整改：PCB 四层 0 危险，丝印 109 条危险清零，14 处过孔挪位
- SMT 侧 96 条危险完成分类与原因定位（其中 U3 的 30 条判为立创库模型朝向，不改板）
- 生产文件包定稿 + 一致性核对 8 项通过
- 《热设计分析》《DFT 可测试性设计说明》定稿；新增《DFM 检查报告与优化记录》《DFM 可制造性设计说明》《生产文件包清单》《BOM 清单与工艺说明》《PCB 打样下单说明》《U3 贴装方向说明》《LTspice 电源仿真取数依据与适用性说明》七份
- R3 料号更正；三处文档数据勘误
- 《变更记录表》更新至第 7 周

**评审反馈（2026-10-12）**：**本周的可制造性收尾这一部分做得好，DFM 的整改记录等相关文档没有问题**；三项待确认事项的结论为——**U3 贴装方向交嘉立创在贴装审核环节确认（本工程不改版、不修改 CPL）；U1 / L2 边界告警保留现有焊盘、不改版；U1 散热盘采用盘中孔工艺、不做简化**。三项至此全部闭合，本轮无设计变更。

**本周未完成、顺延至第 8 周**：

| 项 | 说明 |
|---|---|
| 提交打样订单 | 工艺参数已逐项核定并留存截图，**订单尚未提交**；`层压顺序` 一项待确认（§3.2） |
| J1 库存 / 交期 | 查询时立创库存为 0 pcs；需在下单页再确认，或改为首版手工焊接、把 J1 从 SMT 范围剔除 |
| 盘中孔工艺报价 | 4 层板为收费项，需由下单页计价器核算 |

## 5. 下周计划（第 8 周：2026.10.12—10.18）

> 对应个人 8 周计划第 8 周：实践轨「总结报告 + PPT + 视频 + GitHub + 答辩」，里程碑「**线上答辩通过**」；理论轨「全流程方法论复盘 · 开源硬件规范（OSHWA）」。

1. **提交打样订单**，确认层压顺序与 J1 交期；板厂推送生产稿确认后，核对板框、层数、孔径、线宽。
2. **项目总结报告**——把八周的实践轨与理论轨收成一份，重点写清每个设计决策的**依据与取舍**，以及几处"查出来的错"是怎么发现的。
3. **答辩 PPT 与演示视频**，以及 GitHub 工程组织（按 OSHWA 开源硬件规范整理）。
4. **全流程复盘**：需求 → 原理 → 布局 → 布线 → 验证 → 生产。

## 6. 本周总结

本周把板子从"布线完成"推到了"**可以交文件包**"：**DRC 0 error / 0 未连接，生产文件包定稿，DFM 报出的 109 条丝印危险与 14 处过孔间距问题全部整改闭环。**

这一周最有价值的一条不是"改了什么"，而是**判断出哪些不用改**。DFM 的元件组装分析报了 96 条危险，看数字像板上到处缺铜；逐条溯源后，30 条是立创库里 U3 这个料号的模型朝向与板上封装差 90°（用"接触面积比全是 0.41"与"20 + 8 = 28 穷尽"两个独立证据坐实），48 + 6 条是模型引脚轮廓与板上焊盘的重合或微小悬出（自测偏差 0.0000 ~ 0.0002 mm 与 25 ~ 38 µm），10 条是散热盘盘中孔的设计意图，1 条是同网络重叠。**全部指向"工具侧的模型差异"或"设计意图"，没有一条是板上真的缺铜**——数 Gerber 闪光复核焊盘数量与尺寸，是这条结论的落脚点。

第二条经验是**同一个数字要用两个独立工具验证**：`制板说明` 里那个"最小铜净距 0.101 mm"被复算过多次却始终留着，最后是"若真有 0.101 mm 的异网络间距，DFM 会判危险、DRC 会报错，而两者都没有"这个交叉验证把它证伪的。**证伪一个数字，比反复复算它更有用。**

第三条是**整改的判据要看清是哪个档**：丝印线宽加粗后危险清零、警告却从 0 增到 36 条，只看总数会以为改坏了；实质上危险档才是板厂不收的档，而 0.15 mm 的最细线宽下限又不能靠"少画细线"绕开。

---

**本周交付物**：《DFM 检查报告与优化记录》《DFM 可制造性设计说明》《生产文件包清单》《BOM 清单与工艺说明》《PCB 打样下单说明》《U3 贴装方向说明》《LTspice 电源仿真取数依据与适用性说明》，以及定稿的**生产文件包**（`生产文件_20261009/`）。

**相关文档**：《变更记录表》《DFM 检查报告与优化记录》《DFM 可制造性设计说明》《PCB 打样下单说明》《生产文件包清单》。
