hansonxiex-stack/nrf52-th-sensor-hardware/docs/wk8/img/board_bottom_iso.png

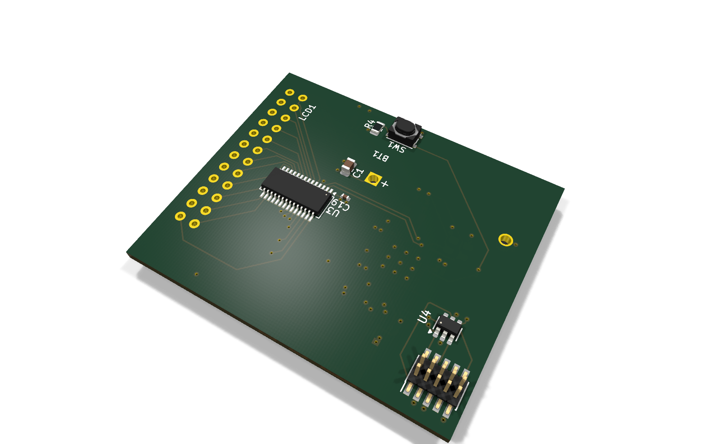
docs/wk8/img/board_bottom_iso.png
