hansonxiex-stack/nrf52-th-sensor-hardware/docs/wk8/img/PCB正反面标注.png

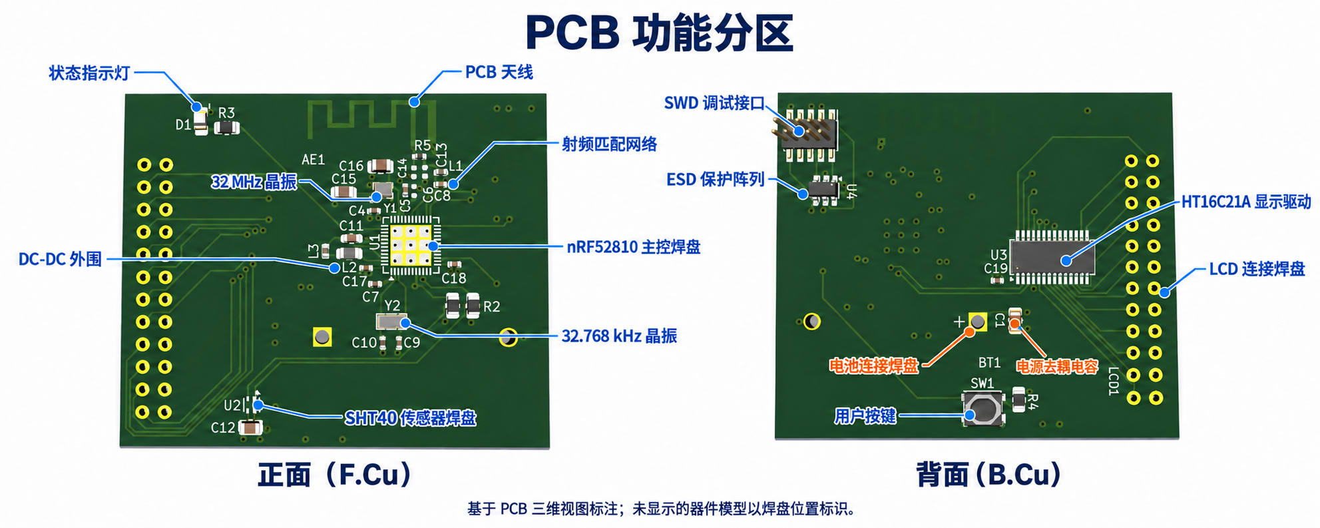
docs/wk8/img/PCB正反面标注.png
