hansonxiex-stack/nrf52-th-sensor-hardware/docs/wk8/img/SHT_keepout.png

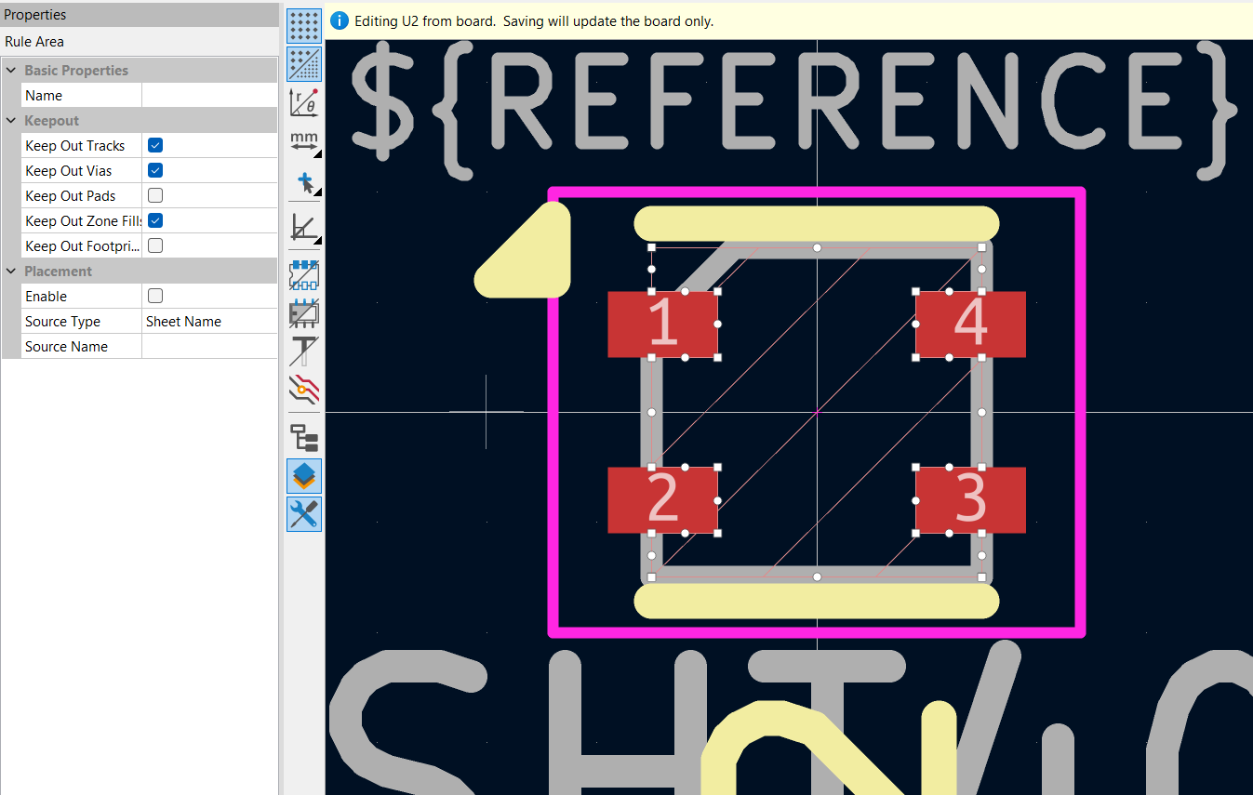
docs/wk8/img/SHT_keepout.png
