hansonxiex-stack/nrf52-th-sensor-hardware/docs/wk8/img/叠层方案.png

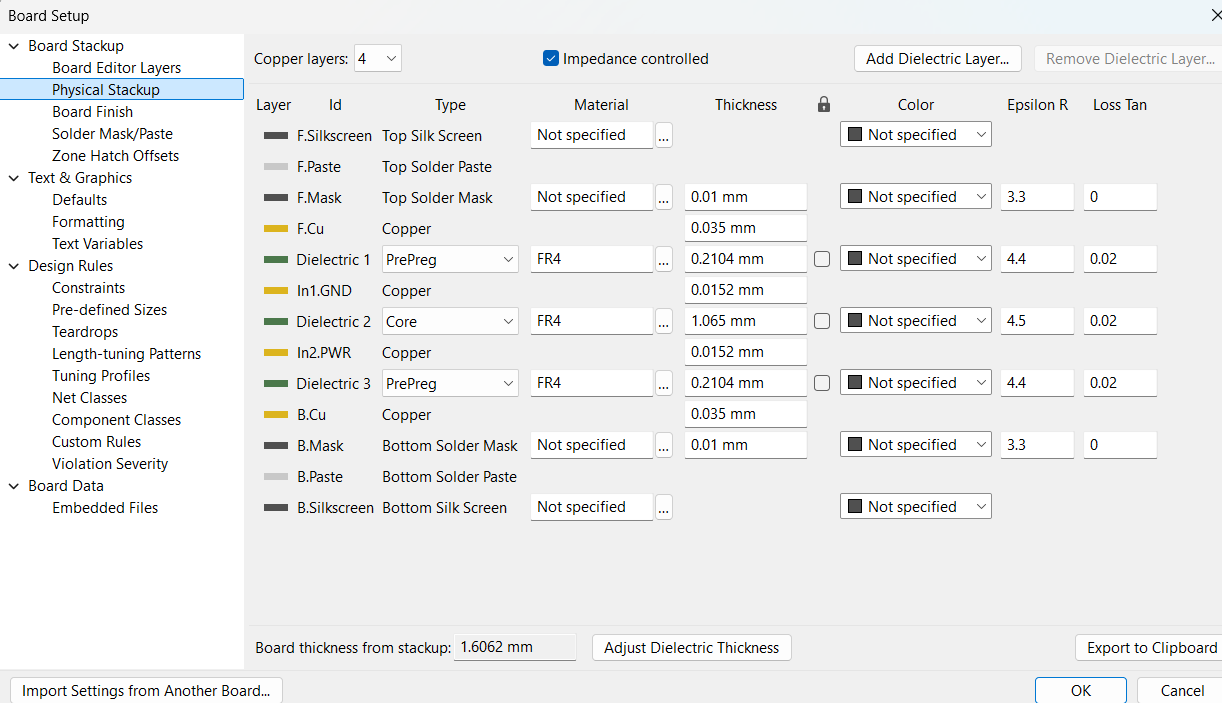
docs/wk8/img/叠层方案.png
