hansonxiex-stack/nrf52-th-sensor-hardware/docs/wk8/img/射频走线与颈缩.png

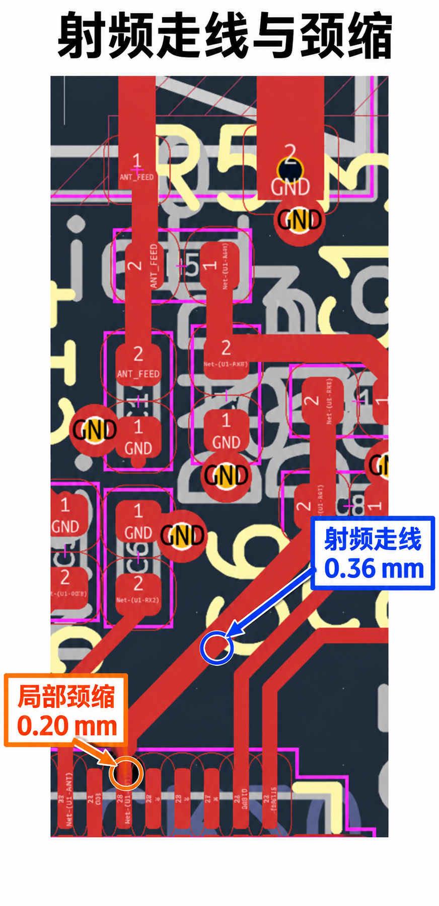
docs/wk8/img/射频走线与颈缩.png
