hansonxiex-stack/nrf52-th-sensor-hardware/docs/wk8/img/晶振与负载电容布局标注.png

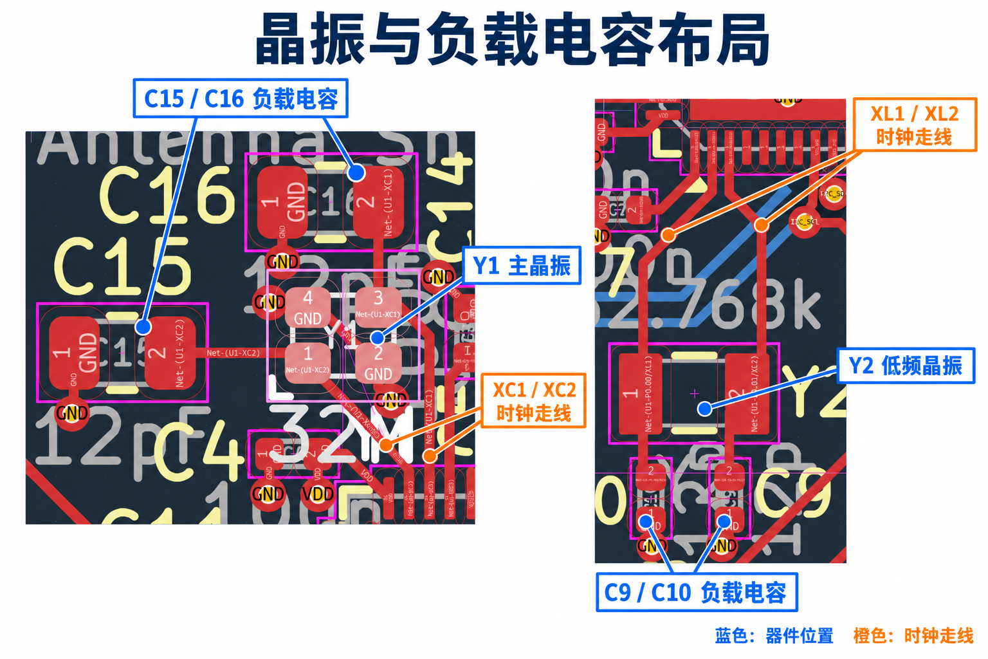
docs/wk8/img/晶振与负载电容布局标注.png
