hansonxiex-stack/nrf52-th-sensor-hardware/docs/wk7/BOM清单与工艺说明_智能温湿度传感器.md

# BOM 清单与工艺说明

**项目**：智能温湿度传感器（方案 B）· 四层板
**版本**：最终版（v7，2026-10-11）　**元件总数**：37 个位号
**提交文件**：`生产文件_20261009/BOM_SMT_智能温湿度传感器.csv`（23 行 / 31 个贴装位号）
**工程源文件**：`正式工程_方案B/BOM.csv`

---

## 1. 贴装 BOM（31 个位号，23 行）

| # | 位号 | 数量 | 值 | 封装 | 立创编号 | 厂家型号 | 单价 ¥ | 小计 ¥ |
|---|---|---|---|---|---|---|---|---|
| 1 | C4, C7, C17, C18, C19 | 5 | 100 nF | 0402 | C1525 | Samsung CL05B104KO5NNNC | 0.03 | 0.15 |
| 2 | C5 | 1 | 100 pF | 0402 | C1546 | FH 0402CG101J500NT | 0.03 | 0.03 |
| 3 | C8 | 1 | 0.8 pF | 0402 | C285068 | FH 0402CG0R8B500NT | 0.03 | 0.03 |
| 4 | C9, C10 | 2 | 12 pF | 0402 | C1547 | FH 0402CG120J500NT | 0.03 | 0.06 |
| 5 | C11 | 1 | 1.0 µF | 0603 | C15849 | Samsung CL10A105KB8NNNC | 0.03 | 0.03 |
| 6 | C1 | 1 | 2.2 µF | 0805 | C77081 | muRata GRM21BR71E225KE11L | 0.24 | 0.24 |
| 7 | C12 | 1 | 100 nF | 0805 | C49678 | YAGEO CC0805KRX7R9BB104 | 0.11 | 0.11 |
| 8 | C15, C16 | 2 | 12 pF | 0805 | C107108 | YAGEO CC0805JRNPO9BN120 | 0.04 | 0.08 |
| 9 | R1, R2, R4 | 3 | 10 kΩ | 0805 | C17414 | UNI-ROYAL 0805W8F1002T5E | 0.02 | 0.06 |
| 10 | **R3** | 1 | **2.2 kΩ** | 0805 | **C17520** | **UNI-ROYAL 0805W8F2201T5E** | 0.02 | 0.02 |
| 11 | R5 | 1 | 0 Ω | 0402 | C17168 | UNI-ROYAL 0402WGF0000TCE | 0.02 | 0.02 |
| 12 | L1 | 1 | 3.9 nH | 0402 | C14033 | Sunlord SDCL1005C3N9STDF | 0.04 | 0.04 |
| 13 | L2 | 1 | 10 µH | 0805 | C162582 | muRata LQM21FN100M80L | 0.79 | 0.79 |
| 14 | L3 | 1 | 15 nH | 0402 | C27143 | Sunlord SDCL1005C15NJTDF | 0.04 | 0.04 |
| 15 | D1 | 1 | STATUS_LED | 0805 | C2297 | KT-0805G（绿） | 0.12 | 0.12 |
| 16 | SW1 | 1 | SW_Push | 4.2 × 3.2 mm | C221895 | C&K PTS810SJG250SMTRLFS | 1.18 | 1.18 |
| 17 | U1 | 1 | nRF52810 | QFN-48 6×6 EP4.6 | C141828 | Nordic NRF52810-QFAA-R | 13.71 | 13.71 |
| 18 | U2 | 1 | SHT40 | DFN-4 1.5×1.5（无中心盘） | C2909890 | Sensirion SHT40-AD1B-R2 | 6.95 | 6.95 |
| 19 | U3 | 1 | HT16C21A | SSOP-28 | C5444716 | HOLTEK HT16C21A-28SSOP | 1.80 | 1.80 |
| 20 | U4 | 1 | TT0554TLX | SOT-23-6 | C5156695 | JingYang TT0554TLX | 0.22 | 0.22 |
| 21 | Y1 | 1 | 32 MHz | 2016 4 脚 | C3013600 | HCI XC21M4-32.000-F08NJDTL | 0.28 | 0.28 |
| 22 | Y2 | 1 | 32.768 kHz | 3215 2 脚 | C5120558 | HCI FC31M2-32.768-N07LLDTL | 0.74 | 0.74 |
| 23 | J1 | 1 | Conn_02x05 | 1.27 mm 2×5 SMD | C51897894 | Liansheng 1010100237 | 0.31 | 0.31 |
| | | **31** | | | | | | **27.01** |

## 2. 不贴装位号（6 个，随板交付但不进 SMT）

| 位号 | 数量 | 说明 | 处理 |
|---|---|---|---|
| AE1 | 1 | 板载 PCB 天线（TI SWRA117D 2.4 GHz） | **无实体器件**，铜箔图形本身即天线 |
| LCD1 | 1 | 定制段码 LCD 玻璃 20×4，28 × 20 mm | **客供 / 单独采购**，引脚穿孔后手工装配 |
| BT1 | 1 | CR2032 电池座（MYOUNG BS-07-A1BJ001，C2979167） | **插件（TH）**，不属 SMT 范围 |
| C6 | 1 | N.C. | 不贴装 |
| C13, C14 | 2 | DNP（射频匹配网络预留位） | 不贴装 |

> **一致性提醒**：C6 / C13 / C14 在 KiCad 板文件中**未勾选 DNP 属性**，直接导出坐标文件时会包含它们。提交用 CPL 已剔除；**若日后重新导出坐标，必须同步剔除**，否则会与 BOM 不一致。

## 3. 成本与库别

| 项 | 数值 |
|---|---|
| 元件合计（不含 LCD 玻璃与不贴件） | **¥28.36** |
| 其中 SMT 部分（含 J1，不含插件 BT1） | **¥27.01** |
| 位号数 | 37（贴装 31 + 不贴装 6） |
| BOM 行数 | 23 |
| **基础库** | **9 项**（无上料费） |
| **扩展库** | **14 项**（一次性上料费，按嘉立创当期计价） |
| 单板最贵器件 | U1 nRF52810 ¥13.71（占元件成本 48%） |

---

## 4. 工艺说明

### 4.1 贴装范围与面别

- **双面贴装**：正面 28 个元件、背面 9 个元件 → 需**两张钢网、两次过炉**。
- 背面以 U3（SSOP-28）、U4（SOT-23-6）、SW1、J1、C1、C19、R4 为主，均为小质量器件，第二次回流时依靠焊锡表面张力即可固定，**无需点胶**。
- **基准点（fiducial）**：设计文件中未放置。嘉立创 SMT 允许无基准点下单，其产线可在工艺边上自行添加；本板尺寸小、元件间距宽松，不添加不构成风险。

### 4.2 钢网

由 `F_Paste.gtp` / `B_Paste.gbp` 直接开制，厚度 **0.12 mm**。关键开窗：

- U1 散热盘：9 块 1.24 × 1.24 mm，中心距 1.53 mm；
- U1 引脚：0.20 × 0.80 mm，0.4 mm 间距 —— 该间距下的钢网面积比与脱模是本次贴装的主要难点；
- 0402 封装面积比 1.22（> 0.66 可印刷）。

### 4.3 表面处理：建议沉金（ENIG）

两条理由：

1. U1 为 **0.4 mm 间距 QFN**，焊盘宽仅 0.20 mm，喷锡的锡面不平整度在该间距下会带来立碑与连锡风险；
2. 本板含**盘中孔**（见 4.4），孔口需在树脂塞孔并电镀填平后保持平整，沉金的平整度优于喷锡。

沉金在嘉立创为收费选项（无铅喷锡另收 30 元/m²，沉金按面积另计）。**若改用喷锡，需在首件上重点复查 U1 的焊接质量。**

### 4.4 特殊工艺：U1 散热焊盘的 9 个盘中孔

U1 的散热焊盘 pad 49 为 4.6 × 4.6 mm、网络 GND，内部布置 **9 个 0.30 mm 过孔**（3 × 3，行距 1.60 mm、列距 1.80 mm）。`F.Mask` 层无独立的过孔开窗，9 孔完全落在散热盘开窗范围内 —— **设计上属盘中孔**。

| 风险 | 说明 |
|---|---|
| 锡膏流失 | 钢网锡膏体积 ≈ 9 × 1.24 × 1.24 × 0.12 ≈ **1.66 mm³**；过孔内容积 ≈ 9 × π × 0.15² × 1.6 ≈ **1.02 mm³**。回流时约 **60% 的锡膏**可能被吸入过孔，散热焊盘焊点会出现空洞 |
| 影响范围 | **限于散热焊盘自身的焊接质量** |

**处理方式（已确认）**：向板厂指定**盘中孔工艺（树脂塞孔 + 电镀填平，IPC-4761 Type VII / POFV）**。

- 嘉立创支持该工艺，适用孔径 0.15 ~ 0.55 mm，本设计 0.30 mm 在范围内；
- **4 层板的盘中孔为收费项**（嘉立创仅对 6 层及以上免费）；
- 4 层板免费的是"过孔塞油"，**与盘中孔不是同一工艺**，须在下拉框中选择"**过孔塞树脂 + 过孔电镀盖帽**"（**2026-10-12：下单页已选定**），详见《PCB 打样下单说明》§3.3；
- 其余 56 个过孔不涉及盘中孔，按标配的免费"过孔塞油"处理即可。

> **已确认并已落实（2026-10-12）**：首版**采用盘中孔工艺，不做简化** —— 下单页 `阻焊覆盖` **已选定**"过孔塞树脂 + 过孔电镀盖帽"，表面处理保留**沉金**。见《DFM 检查报告与优化记录》§5.1。

### 4.5 贴装角度

CPL 中的旋转角取自 KiCad 封装定义。**嘉立创元件库的角度基准与 KiCad 不完全一致**，下单后应在其 DFM 预览 / 贴装预览中逐个核对外形方向。

**本批已核对**：`U3`（C5444716，SSOP-28）在 DFM 的元件组装分析中，其库模型摆出的姿态与板上焊盘**相差 90°**（报 20 条"PIN脚无焊盘" + 8 条"焊脚和焊盘相交区域"，接触面积仅 41%）。经逐项核实，**板上 CPL 角度、封装朝向、丝印 1 脚标记三者自洽**（pad 1 = 135.670, −72.600；丝印 1 脚标记的三角顶点在 136.1425, −72.6375，距该焊盘中心 0.47 mm），因此判断为**立创库内该料号模型默认朝向与板上封装定义不一致所致的误报**。

> **已确认（2026-10-12）**：**交嘉立创在贴装审核时确认；本工程不改版、不修改 CPL**，另随单提交书面说明《U3 贴装方向说明》。见《DFM 检查报告与优化记录》§5.1。

### 4.6 库存与交期提示

| 位号 | 情况 |
|---|---|
| **J1**（C51897894） | 查询时立创库存为 **0 pcs**；DFM 另报 `no_package`（其库内无该封装轮廓）。BOM 合并数据显示料号已匹配到物料（封装 `SMD,P=1.27mm`）。**下单页需再确认交期**，或改为首版自己手焊、把 J1 从 SMT 中剔除 |
| U1（C141828） | 单价最高，建议确认到货批次的防潮包装（MSL 3，开封后需按 Nordic 要求烘烤） |
| U2（C2909890） | 立创库内封装为 `DFN-4-EP(1.5x1.5)`（**带** EP），与板上无中心盘封装不同，DFM 会持续报 1 条"PIN脚无焊盘"，属预期 |
| 扩展库 14 项 | 需支付一次性上料费，按当期计价 |

---

**相关文档**：《DFM 检查报告与优化记录》《DFM 可制造性设计说明》《生产文件包清单》《PCB 打样下单说明》。
