hansonxiex-stack/nrf52-th-sensor-hardware/docs/wk7/生产文件包清单_智能温湿度传感器.md

# 生产文件包清单

**项目**：智能温湿度传感器（方案 B）· 四层板
**文件包位置**：`正式工程_方案B/生产文件_20261009/`
**文件生成时间**：Gerber / 钻孔 / CPL 2026-10-09 02:51，BOM 2026-10-09 22:32
**工具版本**：KiCad Pcbnew 10.0.5
**板框**：48.25 × 40.05 mm（工程标称 48.2 × 40.0）　**层数**：4　**成品板厚**：1.6 mm

---

## 1. 目录结构

```
生产文件_20261009/
├── Gerber/                       ← 光绘文件（11 个图层 + 作业文件）
│   ├── 正式工程_方案B-F_Cu.gtl              L1 顶层线路
│   ├── 正式工程_方案B-In1_GND.g1            L2 内层 1（GND 平面）
│   ├── 正式工程_方案B-In2_PWR.g2            L3 内层 2（VDD 平面）
│   ├── 正式工程_方案B-B_Cu.gbl              L4 底层线路
│   ├── 正式工程_方案B-F_Paste.gtp           顶层钢网（锡膏层）
│   ├── 正式工程_方案B-B_Paste.gbp           底层钢网（锡膏层）
│   ├── 正式工程_方案B-F_Silkscreen.gto      顶层丝印
│   ├── 正式工程_方案B-B_Silkscreen.gbo      底层丝印
│   ├── 正式工程_方案B-F_Mask.gts            顶层阻焊（负片）
│   ├── 正式工程_方案B-B_Mask.gbs            底层阻焊（负片）
│   ├── 正式工程_方案B-Edge_Cuts.gm1         板框
│   └── 正式工程_方案B-job.gbrjob            作业文件（叠层、尺寸、厚度）
├── Drill/                        ← 钻孔文件
│   ├── 正式工程_方案B-PTH.drl               PTH 钻孔（Excellon）
│   ├── 正式工程_方案B-NPTH.drl              NPTH 钻孔（本板为空）
│   ├── 正式工程_方案B-drill.rpt             钻孔统计报告
│   ├── 正式工程_方案B-PTH-drl_map.gbr       钻孔图（供核对，非生产用）
│   └── 正式工程_方案B-NPTH-drl_map.gbr      钻孔图（供核对，非生产用）
├── CPL/
│   └── CPL_SMT_智能温湿度传感器.csv         贴片坐标（31 个位号）
├── BOM_SMT_智能温湿度传感器.csv             贴片 BOM（23 行，含立创编号）
├── 制板说明.txt                             随 Gerber 一起提交给板厂的工艺说明
├── Gerber_2026-10-09.zip                    上传包：制板说明 + 11 图层 + gbrjob + 2 钻孔
├── 丝印渲染_顶面.png / 丝印渲染_底面.png     丝印效果核对图（内部件）
├── all_color_simulation_image.zip           DFM 彩色仿真图（内部件）
├── web.zip                                  下单平台导出的配置快照（内部件）
└── dfm.zip                                  DFM 分析原始数据（内部件）
```

---

## 2. 逐项说明

### 2.1 Gerber（11 图层 + 作业文件）

| 项 | 内容 |
|---|---|
| 格式 | RS-274X，**关闭 X2 扩展**（`%TF` 属性仍保留以标记层功能） |
| 单位 / 坐标 | 公制，绝对坐标，4.6 格式 |
| 扩展名 | Protel 风格（`.gtl/.g1/.g2/.gbl/.gtp/.gbp/.gto/.gbo/.gts/.gbs/.gm1`），板厂 CAM 通用 |
| 极性 | 线路 / 丝印 / 钢网 / 板框为正片；**阻焊为负片**（`SolderMask`，开窗处为图形） |
| 丝印处理 | 已做**阻焊扣除**（丝印压焊盘处自动断开），线宽 0.16 mm |
| 铜箔 | 外层 1 oz（0.035 mm），内层 0.5 oz |
| 内层 | In1.GND、In2.PWR 均为**整层平面**，无走线 |

`正式工程_方案B-job.gbrjob` 汇总：`LayerNumber: 4`、`Size: 48.25 × 40.05`、`BoardThickness: 1.6062`、`ImpedanceControlled: true`。

> ⚠ **`ImpedanceControlled: true`** 是 KiCad 从板文件带出来的标记。它是"本板含阻抗控制走线"的声明，不是"要求板厂测试"；下单时**需要阻抗**一项如何选择见《PCB 打样下单说明》§3.2。

### 2.2 钻孔

```
正式工程_方案B-PTH.drl  （Excellon，公制，绝对坐标，小数格式）
    T1  0.300 mm   65 孔   过孔（ViaDrill）
    T2  0.300 mm    1 孔   AE1 天线馈点（ComponentDrill）
    T3  0.800 mm   24 孔   LCD1 段码引脚
    T4  1.500 mm    2 孔   BT1 电池座定位
    ────────────────────────
    合计            92 孔  全部镀通（PTH）

正式工程_方案B-NPTH.drl
    0 孔（本板无非镀通孔，无安装孔、无挖槽）
```

过孔全部为 **0.30 mm 孔 / 0.70 mm 盘**（环宽 0.20 mm）。其中 U1 散热盘内的 **9 个 0.30 mm 过孔为盘中孔**，需按树脂塞孔 + 电镀填平处理，见《PCB 打样下单说明》§3.3。

### 2.3 钢网（锡膏层）

钢网直接由 **`F_Paste.gtp` + `B_Paste.gbp`** 开制，不需另出一份文件。

| 项 | 内容 |
|---|---|
| 层数 | **双面**，需两张钢网（正面 28 个元件、背面 9 个元件） |
| 本板钢网尺寸 | 4.82 × 4.0 cm（与板框相同，无工艺边 → 下单时按平台自动加边） |
| 厚度 | 0.12 mm（DFM 参数快照 `stencilLayer = 4`，厚度 0.12） |
| 关键开窗 | U1 散热盘为 9 块 1.24 × 1.24 mm，每块正下方一个过孔；0402 封装面积比 1.22（> 0.66 可印刷） |

### 2.4 坐标（CPL）

| 项 | 内容 |
|---|---|
| 文件 | `CPL/CPL_SMT_智能温湿度传感器.csv` |
| 格式 | 嘉立创标准：`Designator, Mid X, Mid Y, Layer, Rotation` |
| 位号数 | **31**（正面 24 / 背面 7） |
| 单位 / 坐标 | 公制，绝对坐标，**Y 取负** |
| 坐标系 | 与 Gerber **完全一致**，无需换算（例：U1 在两者中同为 `X 149.80 / Y −67.40`） |

**31 个位号之外不贴装的 6 个**：AE1（板载 PCB 天线）、LCD1（定制 LCD 玻璃，穿孔另装）、BT1（CR2032 座，插件）、C6（NC）、C13 / C14（DNP，射频匹配预留位）。

> C6 / C13 / C14 在板文件中**未勾选 DNP 属性**，KiCad 直接导出的坐标文件会包含它们。本 CPL 已按上表剔除；**若日后重新导出坐标文件，必须同步剔除**，否则会与 BOM 不一致。

### 2.5 BOM

| 项 | 内容 |
|---|---|
| 文件 | `BOM_SMT_智能温湿度传感器.csv` |
| 格式 | 嘉立创标准：`Comment, Designator, Footprint, LCSC Part #, Quantity` |
| 行数 | **23**（对应 31 个贴装位号） |
| 库别 | 基础库 9 项 / 扩展库 14 项 |

完整清单与工艺说明见《BOM 清单与工艺说明》。

---

## 3. 一致性核对

| 核对项 | Gerber / 板文件 | CPL / BOM | 结果 |
|---|---|---|---|
| 板框 | 48.25 × 40.05 mm | — | ✅ |
| 层数 | 4（job 文件声明） | — | ✅ |
| 座标系 | X 正 / Y 负 | X 正 / Y 负 | ✅ 可直接对齐 |
| 元件总数 | 37 个（正面 28 / 背面 9） | CPL 31 + 不贴 6 = 37 | ✅ |
| 贴装面分布 | 正面 28 / 背面 9 | CPL 正面 24 + 背面 7 = 31 | ✅（差额即 6 个不贴件） |
| 孔数 | 板文件 92 | `drill.rpt` 92 | ✅ |
| U3 朝向 | 板文件旋转 90° / B.Cu | CPL `90.0` / `Bottom` | ✅ |
| R3 料号 | — | `C17520`（2.2 kΩ） | ✅ 已更正 |

以上各项与 DFM 报告中的 `check_info`（`assembler_total_num = 31`、正面 24、背面 7）**完全一致**。

---

## 4. 提交说明

**给板厂（PCB 打样）**：上传 **`Gerber_2026-10-09.zip`** —— 内含 `制板说明.txt` + 11 个 Gerber 图层 + `.gbrjob` + 2 个钻孔文件，共 15 个文件。

**给板厂（SMT 贴装）**：PCB 订单本身**不含**坐标与 BOM，需另外提交

- `CPL/CPL_SMT_智能温湿度传感器.csv`
- `BOM_SMT_智能温湿度传感器.csv`

也可在 PCB 下单页直接点「提交 pcb 订单，去下单 smt」进入贴装流程后再上传。

**内部件，不要给板厂**：`all_color_simulation_image.zip`（DFM 彩色仿真）、`web.zip`（平台配置快照）、`dfm.zip`（DFM 原始数据）、`丝印渲染_*.png`、`Drill/*-drl_map.gbr`（钻孔图，仅供自检）。

---

## 5. 已知需要随包说明的两点

1. **`制板说明.txt` 与文件包同批提交**，其中 §三 已点名 U1 散热盘的 9 个盘中孔，§五 说明射频馈线的阻抗目标。下单时**订单页的工艺选项必须与这份说明一致**（重点是阻焊覆盖与表面处理），逐项对照表见《PCB 打样下单说明》§3。
2. **DFM 报告中的 `no_package` 提示**：J1（C51897894）在立创 DFM 库内无封装轮廓。BOM 合并数据显示该料号已匹配到物料（封装 `SMD,P=1.27mm`），与板上 `PinHeader_2x05_P1.27mm_Vertical_SMD` 一致；仍需在贴装审核中确认。

---

**相关文档**：《DFM 检查报告与优化记录》《DFM 可制造性设计说明》《BOM 清单与工艺说明》《PCB 打样下单说明》。
