hansonxiex-stack/nrf52-th-sensor-hardware/manufacturing/BOM_SMT_智能温湿度传感器.csv

Comment | Designator | Footprint | LCSC Part # | Quantity
2.2u | C1 | C_0805_2012Metric | C77081 | 1
100n | C4,C7,C17,C18,C19 | C_0402_1005Metric | C1525 | 5
100p | C5 | C_0402_1005Metric | C1546 | 1
0.8p | C8 | C_0402_1005Metric | C285068 | 1
12p | C9,C10 | C_0402_1005Metric | C1547 | 2
1.0u | C11 | C_0603_1608Metric | C15849 | 1
100n | C12 | C_0805_2012Metric | C49678 | 1
12pF | C15,C16 | C_0805_2012Metric | C107108 | 2
STATUS_LED | D1 | LED_0805_2012Metric_Pad1.15x1.40mm_HandSolder | C2297 | 1
Conn_02x05_Odd_Even | J1 | PinHeader_2x05_P1.27mm_Vertical_SMD | C51897894 | 1
3.9n | L1 | L_0402_1005Metric | C14033 | 1
10u | L2 | L_0805_2012Metric | C162582 | 1
15n | L3 | L_0402_1005Metric | C27143 | 1
10k | R1,R2,R4 | R_0805_2012Metric | C17414 | 3
2.2k | R3 | R_0805_2012Metric | C17520 | 1
0 | R5 | R_0402_1005Metric | C17168 | 1
SW_Push | SW1 | SW_SPST_PTS810 | C221895 | 1
nRF52810-QFxx | U1 | QFN-48-1EP_6x6mm_P0.4mm_EP4.6x4.6mm | C141828 | 1
SHT40 | U2 | Sensirion_DFN-4_1.5x1.5mm_P0.8mm_SHT4x_NoCentralPad | C2909890 | 1
HT16C21A | U3 | SSOP-28_3.9x9.9mm_P0.635mm | C5444716 | 1
TT0554TLX | U4 | SOT-23-6 | C5156695 | 1
32MHz | Y1 | Crystal_SMD_2016-4Pin_2.0x1.6mm | C3013600 | 1
32.768k | Y2 | Crystal_SMD_3215-2Pin_3.2x1.5mm | C5120558 | 1
