hansonxiex-stack/nrf52-th-sensor-hardware/manufacturing/制板说明.txt

智能温湿度传感器（方案 B）  制板说明
板名：正式工程_方案B          日期：2026-10-11
================================================================

一、基本参数
    层数        4 层
    板框        48.2 × 40.0 mm（矩形，无挖槽）
    成品板厚    1.6 mm
    外层铜厚    1 oz
    内层铜厚    0.5 oz
    叠层        4 层 1.6mm 标准叠层：0.2104mm prepreg / 1.065mm core
                外层 1oz + 内层 0.5oz，共 7 层材料
    表面处理    建议沉金（ENIG）
    阻焊        绿色或常规色，不限

二、最小尺寸
    最小线宽        0.20 mm
    最小线距        0.20 mm
    最小铜净距      0.200 mm（异网络，全板无更紧处）
    最小焊盘—过孔   0.150 mm（同网络，2 处）
    最小过孔        0.30 mm 孔 / 0.70 mm 盘，共 65 个
    最小插件孔      0.80 mm
    铜到板边        ≥0.50 mm
    孔总数          92，全部镀通；无非镀通孔

    说明：以上最小值为嘉立创 DFM 的实测值。同网络的焊盘—过孔间距不受
          0.20 mm 网络类规则约束，0.150 mm 高于常规工艺下限。

三、特殊工艺（重要）
    U1（QFN-48）散热焊盘 4.6 × 4.6 mm 内有 9 个 0.30 mm 过孔，
    属盘中孔，请按“树脂塞孔 + 电镀填平”（POFV / IPC-4761 Type VII）处理。
    其余 56 个过孔按常规过孔处理。

四、变更记录
    2026-10-08：调整 12 处过孔位置，用于增大焊盘与过孔之间的间距；
                焊盘—过孔最小间距由 0.013 mm 提升至 0.125 mm。
    2026-10-09：再调整 1 处过孔位置，用于增大两枚过孔之间的间距；
                该处过孔间距由 0.061 mm 提升至 0.418 mm。
    2026-10-09：丝印整改。元件外框线宽由 0.12 mm 加粗至 0.16 mm，
                并重排位号避让焊盘与过孔；丝印类“危险”项由 109 条清零。
    以上调整均只涉及丝印与过孔，元件位置与布线拓扑未改变。
    当前全板异网络铜净距 ≥0.200 mm，无低于常规工艺下限之处。

五、阻抗
    射频馈线 0.36 mm，位于 F.Cu，参考 In1 地平面，介质 0.2104 mm，
    设计目标 50 Ω。叠层未变更时无需另行调整。
    如需板厂保证，可按 50 Ω ±10% 控制并提供阻抗测试条。

六、丝印
    元件外框线宽 0.16 mm，位号文字 0.15 ~ 0.16 mm，均不低于常规下限
    0.15 mm。丝印已做阻焊扣除，压焊盘/过孔处自动断开，无覆盖焊盘的
    “危险”项。

七、文件说明
    Gerber/     11 个图层 + .gbrjob
                F_Cu / In1_GND / In2_PWR / B_Cu / F_Mask / B_Mask /
                F_Paste / B_Paste / F_Silkscreen / B_Silkscreen / Edge_Cuts
    Drill/      Excellon 格式，公制，绝对坐标，PTH 与 NPTH 分开
    CPL/        贴片坐标（嘉立创格式，31 个位号）
    BOM_SMT_*.csv  贴片 BOM（含立创商城编号）

    注：本文件（制板说明.txt）与 Gerber 图层、钻孔文件同包提交；CPL 与
        BOM 不在本包内，走 SMT 下单时另行上传。
