hansonxiex-stack/nrf52-th-sensor-hardware/manufacturing/丝印渲染_底面.png

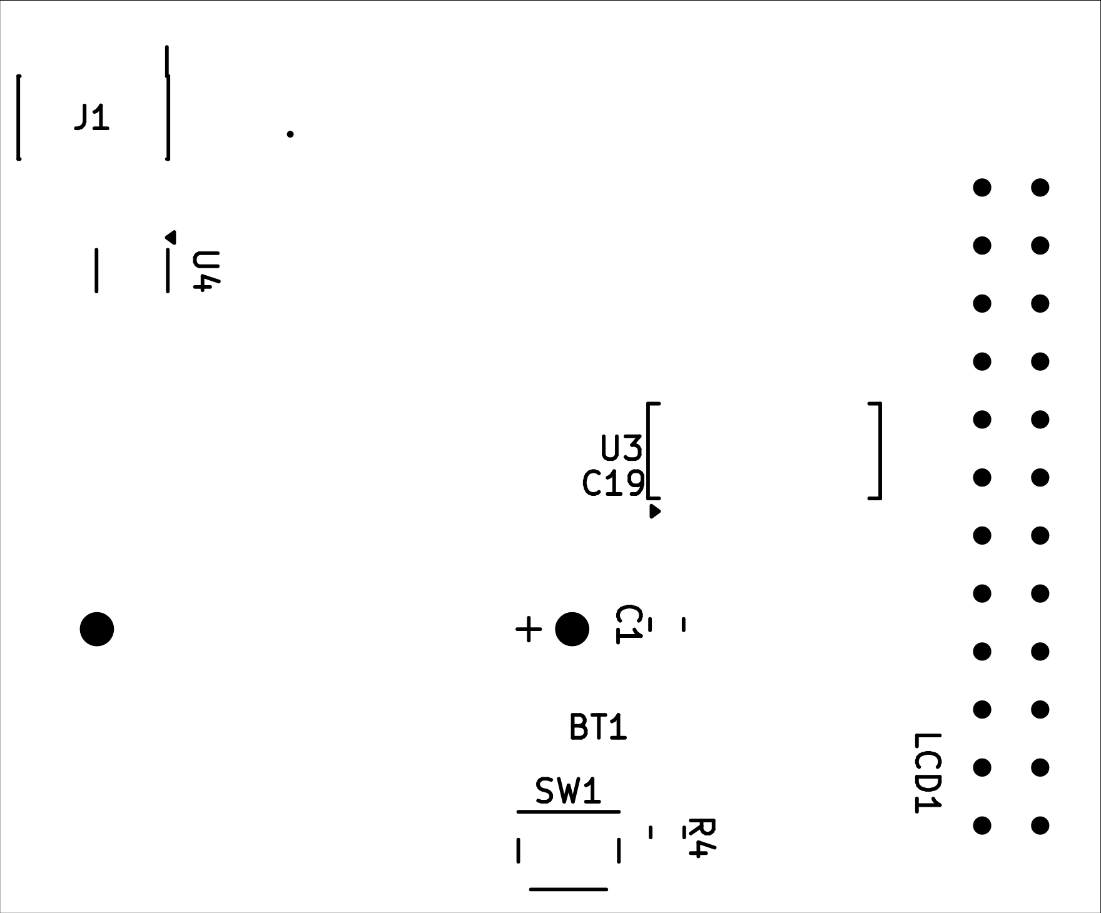
manufacturing/丝印渲染_底面.png
