hansonxiex-stack/nrf52-th-sensor-hardware/manufacturing/丝印渲染_顶面.png

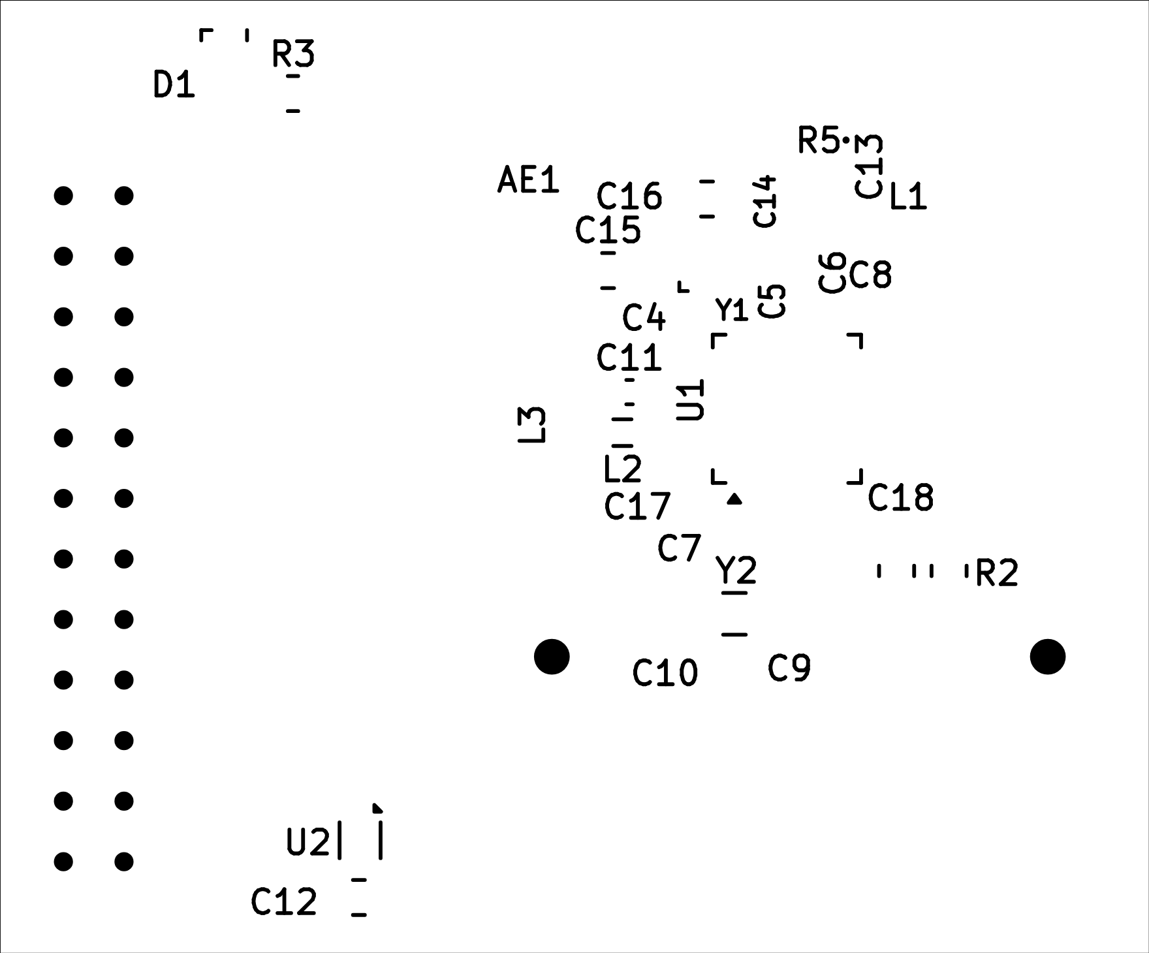
manufacturing/丝印渲染_顶面.png
