hansonxiex-stack/nrf52-th-sensor-hardware/simulation/电源仿真.asc

C1: cap; 2.2µ
C2: cap; 100n
C3: cap; 100n
C4: cap; 100n
C5: cap; 100n
C6: cap; 100n
I1: current; PULSE(2u 10m 0.2 1u 1u 10m 1)
I2: current; PULSE(0.2u 0.6m 0.3 1u 1u 10m 2)
I3: current; 18µ
V1: voltage; 3; Rser={Rb}
Named nets: 0, Vrail
.tran 0 2 0 10u
.step param Rb list 10 30 50
