hansonxiex-stack/nrf52-th-sensor-hardware/hardware/smart-th-sensor.kicad_pcb

## KiCad design hardware/smart-th-sensor.kicad_pcb (2026-10-18)

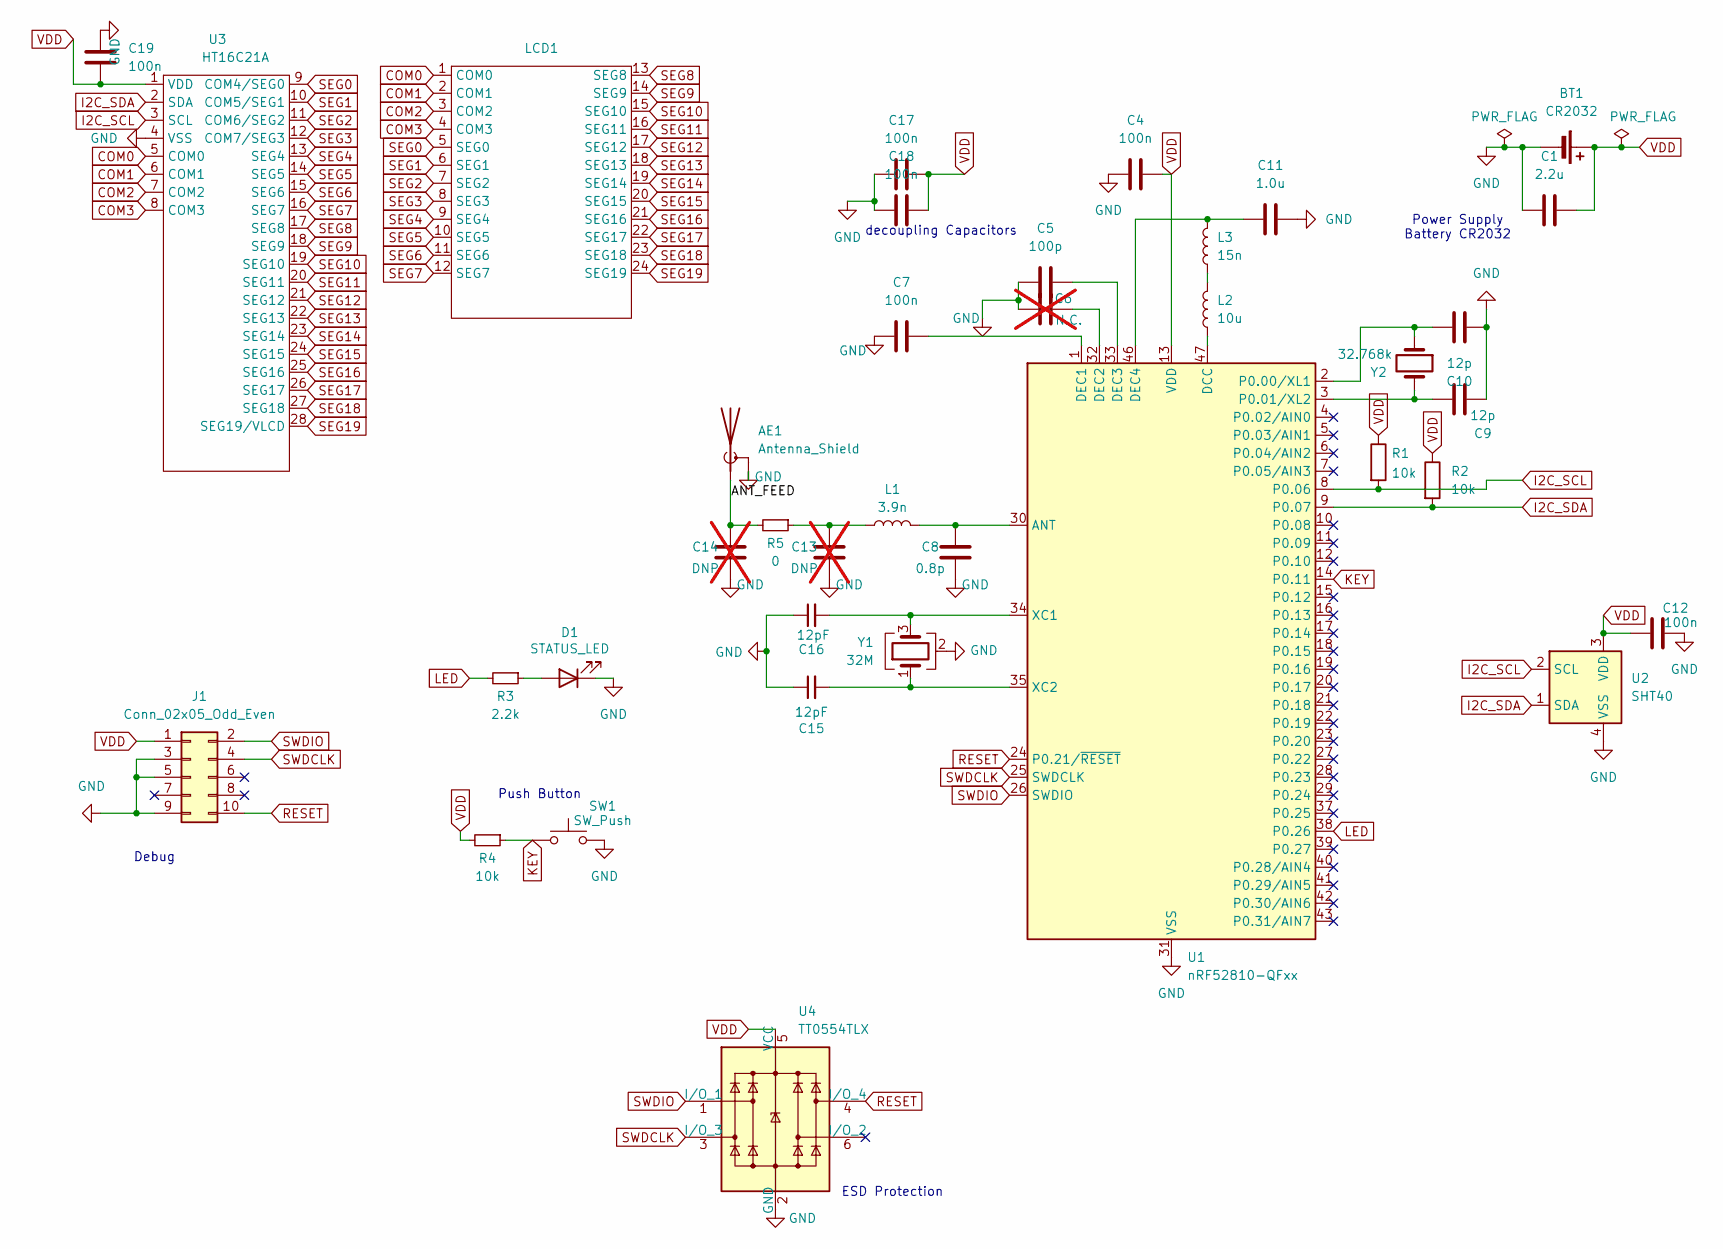
[picture p59: schematic smart-th-sensor.kicad_sch]

Parts:
AE1: Antenna_Shield; Texas_SWRA117D_2.4GHz_Left
BT1: CR2032; BatteryHolder_MYOUNG_BS-07-A1BJ001_CR2032
C1: 2.2u; C_0805_2012Metric
C4, C7, C17, C18, C19: 100n; C_0402_1005Metric
C5: 100p; C_0402_1005Metric
C6: N.C.; C_0402_1005Metric; not fitted
C8: 0.8p; C_0402_1005Metric
C9, C10: 12p; C_0402_1005Metric
C11: 1.0u; C_0603_1608Metric
C12: 100n; C_0805_2012Metric
C13, C14: DNP; C_0402_1005Metric; not fitted
C15, C16: 12pF; C_0805_2012Metric
D1: STATUS_LED; LED_0805_2012Metric_Pad1.15x1.40mm_HandSolder
J1: Conn_02x05_Odd_Even; PinHeader_2x05_P1.27mm_Vertical_SMD
L1: 3.9n; L_0402_1005Metric
L2: 10u; L_0805_2012Metric
L3: 15n; L_0402_1005Metric
LCD1: LCD_Segment_20x4
R1, R2, R4: 10k; R_0805_2012Metric
R3: 2.2k; R_0805_2012Metric
R5: 0; R_0402_1005Metric
SW1: SW_Push; SW_SPST_PTS810
U1: nRF52810-QFxx; QFN-48-1EP_6x6mm_P0.4mm_EP4.6x4.6mm
U2: SHT40; Sensirion_DFN-4_1.5x1.5mm_P0.8mm_SHT4x_NoCentralPad
U3: HT16C21A; SSOP-28_3.9x9.9mm_P0.635mm
U4: TT0554TLX; SOT-23-6
Y1: 32M; Crystal_SMD_2016-4Pin_2.0x1.6mm
Y2: 32.768k; Crystal_SMD_3215-2Pin_3.2x1.5mm

Connections:
/ANT_FEED: AE1.1 (A), C14.2, R5.2
COM0: LCD1.1 (COM0), U3.5 (COM0)
COM1: LCD1.2 (COM1), U3.6 (COM1)
COM2: LCD1.3 (COM2), U3.7 (COM2)
COM3: LCD1.4 (COM3), U3.8 (COM3)
GND: AE1.2 (Shield), BT1.2 (-), C1.1, C4.1, C5.1, C6.1, C7.1, C8.1, C9.1, C10.1, C11.2, C12.2, C13.1, C14.1, C15.1, C16.1, C17.1, C18.1, C19.1, D1.1 (K), J1.3, J1.5, J1.9, SW1.2, U1.31 (VSS), U1.45 (VSS), U1.49 (VSS), U2.4 (VSS), U3.4 (VSS), U4.2 (GND), Y1.2 (G), Y1.4 (G)
I2C_SCL: R1.2, U1.8 (P0.06), U2.2 (SCL), U3.3 (SCL)
I2C_SDA: R2.2, U1.9 (P0.07), U2.1 (SDA), U3.2 (SDA)
KEY: R4.1, SW1.1, U1.14 (P0.11)
LED: R3.2, U1.38 (P0.26)
unnamed: C13.2, L1.1, R5.1
unnamed: D1.2 (A), R3.1
unnamed: L2.2, L3.1
unnamed: C8.2, L1.2, U1.30 (ANT)
unnamed: L2.1, U1.47 (DCC)
unnamed: C7.2, U1.1 (DEC1)
unnamed: C6.2, U1.32 (DEC2)
unnamed: C5.2, U1.33 (DEC3)
unnamed: C11.1, L3.2, U1.46 (DEC4)
unnamed: C10.2, U1.2 (P0.00/XL1), Y2.1
unnamed: C9.2, U1.3 (P0.01/XL2), Y2.2
unnamed: C16.2, U1.34 (XC1), Y1.3
unnamed: C15.2, U1.35 (XC2), Y1.1
RESET: J1.10, U1.24 (P0.21/~RESET), U4.4 (I/O_4)
SEG0: LCD1.5 (SEG0), U3.9 (COM4/SEG0)
SEG1: LCD1.6 (SEG1), U3.10 (COM5/SEG1)
SEG2: LCD1.7 (SEG2), U3.11 (COM6/SEG2)
SEG3: LCD1.8 (SEG3), U3.12 (COM7/SEG3)
SEG4: LCD1.9 (SEG4), U3.13 (SEG4)
SEG5: LCD1.10 (SEG5), U3.14 (SEG5)
SEG6: LCD1.11 (SEG6), U3.15 (SEG6)
SEG7: LCD1.12 (SEG7), U3.16 (SEG7)
SEG8: LCD1.13 (SEG8), U3.17 (SEG8)
SEG9: LCD1.14 (SEG9), U3.18 (SEG9)
SEG10: LCD1.15 (SEG10), U3.19 (SEG10)
SEG11: LCD1.16 (SEG11), U3.20 (SEG11)
SEG12: LCD1.17 (SEG12), U3.21 (SEG12)
SEG13: LCD1.18 (SEG13), U3.22 (SEG13)
SEG14: LCD1.19 (SEG14), U3.23 (SEG14)
SEG15: LCD1.20 (SEG15), U3.24 (SEG15)
SEG16: LCD1.21 (SEG16), U3.25 (SEG16)
SEG17: LCD1.22 (SEG17), U3.26 (SEG17)
SEG18: LCD1.23 (SEG18), U3.27 (SEG18)
SEG19: LCD1.24 (SEG19), U3.28 (SEG19/VLCD)
SWDCLK: J1.4, U1.25 (SWDCLK), U4.3 (I/O_3)
SWDIO: J1.2, U1.26 (SWDIO), U4.1 (I/O_1)
VDD: BT1.1 (+), C1.2, C4.2, C12.1, C17.2, C18.2, C19.2, J1.1, R1.1, R2.1, R4.2, U1.13 (VDD), U1.36 (VDD), U1.48 (VDD), U2.3 (VDD), U3.1 (VDD), U4.5 (VCC)

Notes on the sheet:
decoupling Capacitors
ESD Protection
Push Button
Debug
Power Supply Battery CR2032

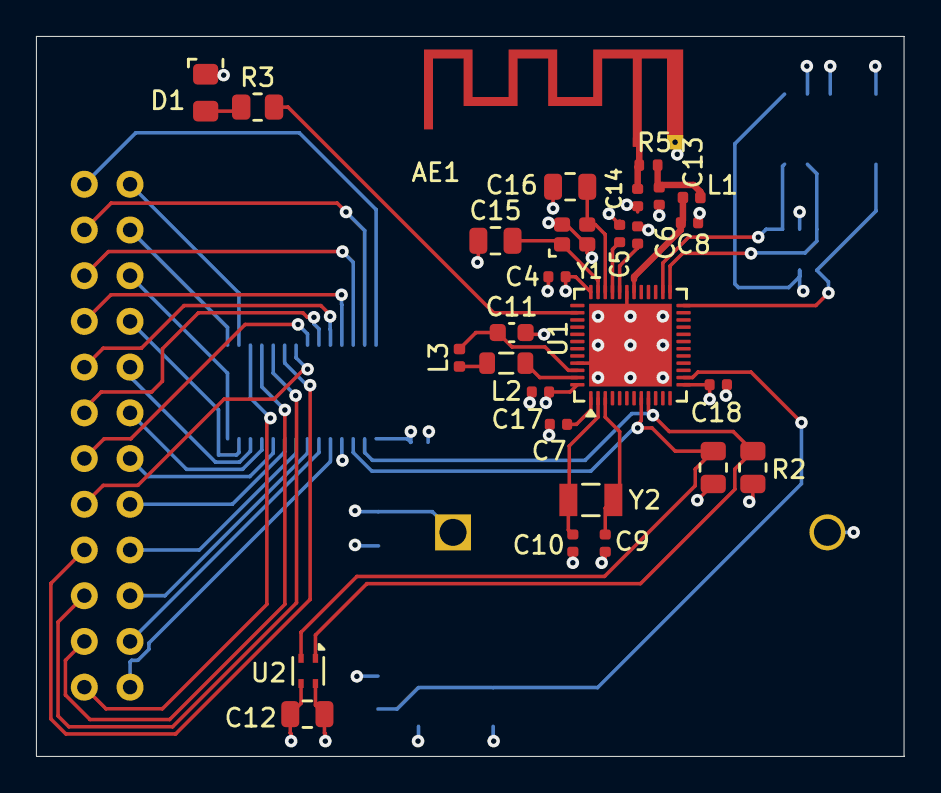
[picture p60: board smart-th-sensor.kicad_pcb from above]

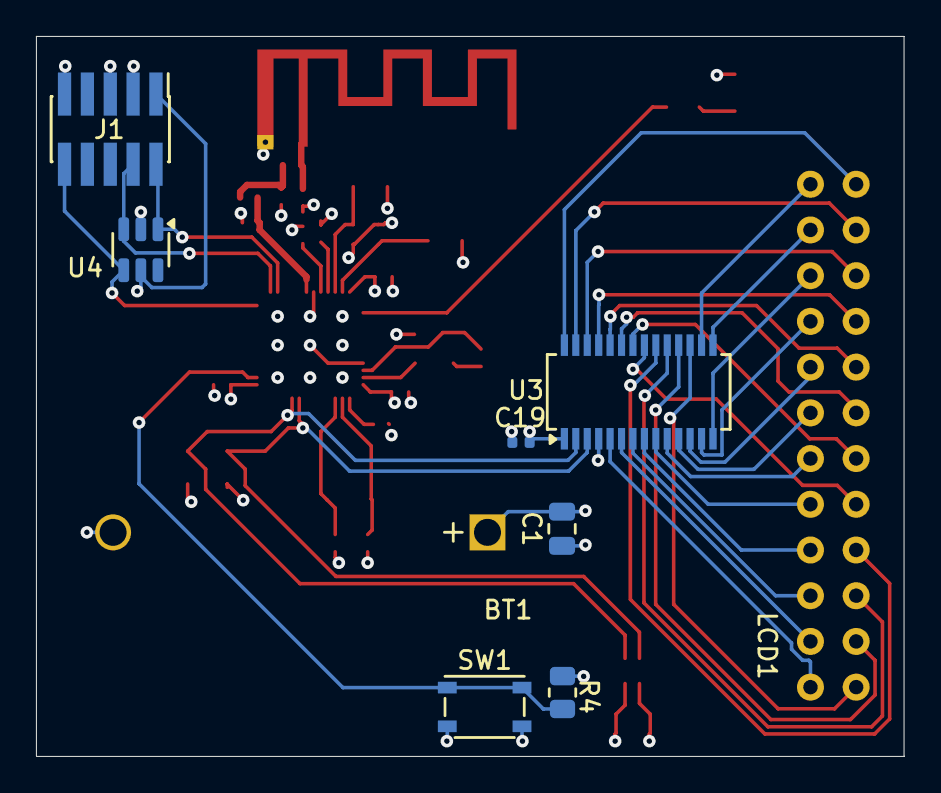
[picture p61: board smart-th-sensor.kicad_pcb from below]

Board: 4 copper layers, 48.2 x 40.0 mm, 37 parts (9 on the bottom side), 47 nets.
