hansonxiex-stack/nrf52-th-sensor-hardware/(commit log)

2026-10-18 初始化：nRF52810 四层温湿度传感器硬件工程
    - hardware/ KiCad 10 工程、自定义符号与封装、ERC/DRC 报告
    - simulation/ LTspice 电源仿真电路与运行日志
    - manufacturing/ Gerber、钻孔、BOM、CPL 与制板说明
    - docs/ 八周实验报告与各专项设计说明
    - presentation/ 演示 PPT（含逐页录音）、PDF 与逐页讲解稿
    - images/ 3D 图、系统框图与关键布局图
    [BOM_SMT_智能温湿度传感器.csv, smart-th-sensor.kicad_pcb, smart-th-sensor.kicad_sch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]
2026-10-18 docs: 总结报告补充附录 B（生成式 AI 使用情况）
2026-10-18 docs: 附录 B 统一口径与分工表
2026-10-18 docs: 总结报告收尾修订（工况口径、结论收敛、交付状态更新）
2026-10-18 docs: 删除第 8 周交付物状态小节，同步 §4 与文件索引
